shinhan7n2-spec/autonomous-car/README.md

# 자율주행 자동차 (몸체)

## 처음이면 여기부터

| 폴더 | 내용 |
|---|---|
| `1_출력파일_v6.3` | **지금 뽑을 STL 10개** |
| `2_출력가이드` | 출력 순서·시간·설정 (`index.html` 열기) |
| `3_조립설명서` | 그림으로 보는 조립 순서 (`index.html` 열기) |
| `4_학교제공자료` | 수업 자료 화면, 부품 목록·사진·스캔 STL |
| `5_과거기록` | 날짜별 이전 설계, 작업 기록 |
| `6_발표자료` | AI 활용 발표 (`index.html` 열기, 방향키로 넘김) |

- 최신 모델: `5_과거기록/2026-10-30/06_v6.3_최신모델/20261030_자율주행자동차_최종_v6.4.blend`
- 출력은 `1_출력파일_v6.3` 파일만 사용. 과거 기록의 STL과 섞지 않기
