shinhan7n2-spec/autonomous-car/5_과거기록/2026-10-29/00_부품조사/README.md

# 부품 원본 자료

2026-10-29, 기기 A. 사용자가 제공한 Downloads의 파일 3개를 원본 이름으로 복사했으며 각각 SHA-256 일치를 확인했다. 원본은 변경하지 않았다.

- 부품리스트_학생용.xlsx: Sheet3, 부품 항목 24개와 용도별 체결 부품 표를 읽음. 제품 링크의 실시간 내용은 아직 확인하지 않음.
- 부품스캔파일(stl).zip: 원본 ZIP 보존. 부품 STL 6개를 stl/에 풀었음. 몸체 완성 모델은 파일 목록에 없음.
- 자율주행_팀_물품사진_공지용.jpg: 팀 물품 안내 사진. 실제 수령 여부와 동일성은 미확인.
- stl_inventory.json: 바이너리 STL의 삼각형 수와 좌표축별 외곽 범위를 계산한 목록. STL에는 단위 정보가 없으므로 mm로 확정하지 않음. 회전된 부품의 축별 범위는 실제 길이·폭·높이와 다를 수 있음. 구멍 치수나 출력 적합성을 검증한 결과가 아님.

## 확인한 구성

- 라즈베리파이 4B 8GB 1개, IG-22GM 01TYPE 12V 1/104 모터 2개, 좌·우 96mm 메카넘휠 각 1개, 캐스터 1개.
- L298 드라이버, 2250mAh 11.1V 리포배터리, 보조배터리, APC850 카메라, 초음파 센서 등.
- STL: 라즈베리, 리포배터리, 메카넘휠, 모터, 보조배터리, 캐스터 휠. 카메라·센서·드라이버 이름의 STL은 없음.
- 체결 표: 캐스터 M5×10 4개와 M5 너트 4개, 바퀴 M4×12 2개와 M3×8 2개, 카메라 M6×20 1개, 지지대 볼트·너트 M4×30 각 4개, M4×20 볼트 8개.
- M4 3cm 지지대가 목록에 있어 다층 구성에 활용 가능성을 검토할 수 있으나 층 구성은 아직 결정하지 않음.

## 다음 확인

STL 형상과 방향·실물 크기 대조, 고정 구멍과 볼트 머리/너트 작업 공간, 카메라·센서·드라이버 크기, 프린터 조건, 사용자 외형 선택.
