shinhan7n2-spec/autonomous-car/5_과거기록/DESIGN_CHECKLIST.md

# 설계 고려사항과 확인 상태

2026-10-29 / 기기 A. 최신 사용자 결정 기준. 고려한 것과 실제 검증 완료를 구분한다.

| 항목 | 상태 | 근거 / 남은 일 |
|---|---|---|
| 제공 STL 원본 크기·형상 유지 | 반영·검사 | 배율 1. v3.1과 원본배율 복원본의 참고 객체 8개 전체 정점 해시 일치. 원본 파일 보존. |
| 기존 v2 보존 | 완료 | v3.0~v3.2를 별도 파일로 저장. |
| 메카넘휠 2개＋모터 2개＋캐스터 | 반영 | 수업 연결도 및 XLSX. 좌L·우R 각 1개 확인. STL은 한쪽 휠만 있어 복제된 반대편은 실제 롤러 방향을 재현하지 못함. |
| 전방 카메라·HY-SRF05 | 부분 반영 | 센서 기판과 받침 배치. 카메라 본체 및 커넥터 외곽 미반영. |
| 한 장 / 두 조각 비교 | 한 장 선택·치수 검사 | 바닥판 190×185mm. 접합부 제거를 우선. 분할판의 하중 시험이나 강도 해석을 비교한 것은 아님. |
| 3DWOX 1 | 사양 반영 | 출력 한계210×200×195mm. 바닥판 좌우10mm, 앞뒤7.5mm 여유. 실제 슬라이서에서 브림·서포트까지 포함한 검사 미완료. |
| 둥근 외형 | 부분 반영 | 모서리를 완화한 바닥판. 뚜껑 없음. |
| 차체·바퀴 공간 | 수치 검사 일부 | 전체 폭 약282.6mm, 후방 바닥판과 휠 외곽 사이 약2.7mm. 회전·축 체결·동적 변형은 미검증. |
| 높이·지면 접촉 | 형상 기준 반영 | 원본 휠/캐스터의 최저점을 지면에 맞춤. 모터 실제 축선은 스캔 중앙과 같다고 보장하지 않음. |
| 모터 고정 | 수정 중 | 기존 둥근 상하 받침의 29mm 구멍은 확정 끼움 아님. 사용자 승인: U자 홈 받침＋평평한 판＋제공 금속 볼트로 변경. 아직 새 고정대 생성 전. |
| 나사 구멍 | 부분 반영·추정 | M4용5mm, M3용4mm. 캐스터 슬롯38×28 중심 간격,14×6 슬롯은 추정. 나사 길이·머리·너트 및 공구 접근 최종 대조 미완료. |
| 배터리 고정 | 형상 반영·조립 미검증 | 벨크로는 지급품으로 확인되지 않아 제외. 출력 가로대＋볼트·너트, 옆/앞뒤 멈춤턱. 상부 여유1mm 제안. 리포 가로대 위 선반 여유1mm로 작음. |
| 배선·커넥터 | 부분 반영 | 선반 통로와 배선 경로 예시. 실제 USB/전원 커넥터 크기·굽힘 반경·착탈 공간 검증 미완료. |
| 부품 겹침 | 부분 검사 | 외곽 범위와 일부 접촉 높이 검사. 모든 실제 형상의 교차·공구 접근·캐스터 회전 간섭 검사를 완료한 것은 아님. |
| 무게·주행 안정성 | 미검증 | 실제 부품 질량·무게중심·가감속·횡미끄럼·캐스터 전환 시험 없음. 단순한 구조가 주행 성공을 보장하지 않음. |
| 출력 쉬운 단순 부품 | 수정 중 | 선반·가로대는 평판. 높은 일체 기둥·너트 포켓·모터 고정대 출력 방향/지지물 검토 필요. |
| 모델 표면 검사 | v3.1 검사 완료 | 새 구조물의 비다양체 모서리0. 출력·강도·조립 성공 검사와 다름. |
| 출력 파일 | 검토용만 생성 | v3.2에서 부품9개 STL 내보냄. REVIEW 표시. 사용자 요청은 확정본이므로 현재 파일을 최종 출력본으로 안내하지 않는다. |
| 조립설명서·치수도 | 미완료 | v2 README의 개념 순서와 v3 렌더는 있음. 최종 부품 번호·볼트 수량·순서 문서 및 치수도 미완료. |
| 예약 출력·재방문 최소화 | 설계 제약 유지 | 반복 시험 출력 가능하다고 가정하지 않음. 최종 슬라이싱 시간·필라멘트 확인 필요. |

## 추정값 적용 원칙
- 사용자는 검색 후 추정해 진행하되 값을 기록하도록 승인했다. 추정을 실측·제조사 확정치로 표시하지 않는다.
- 모터 제품명: IG-22GM 01TYPE 12V 1/104. 제조사 참고: https://www.shayangye.com/en/ig-22gm-01type
- 정확한 커플링: 지급 목록 96mm 휠용4mm 커플링. 다른6mm 커플링 치수를 확정값으로 쓰지 않는다.
- 3DWOX1 사양: https://sindoh.es/producto-sindoh/3dwox-1/
- 구조 치수·검사 상세: outputs/20261029_assembly_v3_A/v3_engineering_audit.json 및 mesh_validation.json.
- 제조사 수치와 스캔이 달라도 STL은 변경하지 않는다. 새 고정대 설계에 차이를 기록한다.

## 다음 완료 순서
1. 모터 U자 받침＋평판 방식으로 수정하고 출력 방향·체결 경로 검사.
2. 다른 고정대·커넥터·배터리 탈착·공구 접근 검사 및 수정.
3. 최종 STL과 부품 번호·볼트 목록·치수도·조립설명서 생성.
4. 실제 3DWOX1 프로필/재료로 슬라이싱 검증 후 출력 확정 여부 보고.

## 2026-10-29 v3.3 갱신
- 모터 U자 V홈 받침+평판 변경 완료. 단, 실제 고정·축 정렬 미검증.
- STL9개, 조립설명서HTML, 금속부품 예상표, ZIP 저장 완료. 제작확정본 아님.
- 9개 출력부품 연결체1개, 비다양체모서리0, 개별베드크기범위내. 원본STL참고객체 전체 정점해시 보존.
- PLA를 사용자 선택. 실제 장비재료/슬라이서검사/G-code 미완료. 보드·카메라·캐스터·모터 체결 검증은 여전히 남음.

## 2026-10-29 v3.4 덮개 프리뷰
- 덮개 외형 생성 및 4뷰 프리뷰 완료. 원본 STL 파일/형상 유지 해시 검증.
- 체결부와 카메라 실물여유, 전체간섭·슬라이싱은 미완료. 최신 덮개는 프리뷰이며 출력승인 아님.

## 2026-10-29 v4 통합 검토와 카메라 정정
- 랜카드 A1000mini 내장 안테나형 참고 형상. 치수24.6×16×8mm·USB 위치 추정, 연결 돌출30mm 가정 기록. 전파·열 시험 아님.
- 해치백 덮개와 보드 고정편 추가. 19개 새 출력 부품 메시 닫힘/연결성/크기 검사 통과. 실제 조립 및 출력 승인 아님.
- 카메라 뒤 접이식 받침이 프리뷰에 누락/과도 단순화됨. 테이프 없이 모니터처럼 걸칠 세로 받침과 뒤 클립 여유 설계 필요. M6 볼트 체결 위치·유효깊이는 미확정.
- 센서 뒤 고정띠 체결 상세, 보드 소자 간섭, 모터 축 정렬, 캐스터 회전 궤적, 실제 슬라이서 검사가 남음.

## 2026-10-29 v4.1 카메라 클립 받침
- 모니터형 세로 받침과 뒤 누름판, 지급 공용 M3×20 볼트/너트 각2개 기준 체결 형상 생성. 카메라 클립 뒤 작업 공간을 덮개에 반영.
- 원본 STL 파일/메시/배율 유지 확인. 변경부품3개 닫힘/연결체1, 카메라·받침 대 덮개/선반/Pi 표면교차0. 실물 힌지 동작과 고정력 검사는 아님.
- 테이프·접착제·추가 구매 부품을 쓰지 않는 규칙을 AGENTS.md에 기록. 카메라 외형/클립 치수는 추정, 실제 M3 수량과 끼움 확인 필요.

## 2026-10-29 v4.2 배터리 후방 탈착
- 위 가로대는 유지하고 뒤 잠금판2개를 제거해 배터리를 꺼내는 구조. 테이프/스트랩 추가 없음. 지급 M3×16 볼트/너트 총4세트 기준.
- 앞/뒤 왼쪽 지지대와 보조배터리 겹침 수정. 선반 보강대와 덮개 후방 개구 추가. 변경메시5개 닫힘/연결체1.
- 배터리 직선 이동 공간과 지정 구조물 부피 검사. 실제 배선/커넥터/충전기 호환성/실물 강도/열은 별도 미검증. 충전 중 차내 장착을 전제로 하지 않음.

## 2026-10-29 v4.3 센서 고정 (Claude)
- 센서가 덮개 앞벽과 겹치던 문제를 수정함. 기판은 바닥판 앞 기둥 홈에 밀어 넣고, 덮개에는 위가 트인 홈을 냄. 카메라 받침은 +6mm 올리고 선반에 M3×20 2개로 고정함. P12 고정띠는 삭제함.
- 조립 순서: 센서를 먼저 꽂고 배선한 뒤 카메라 받침을 얹는다(받침이 센서 빠짐을 막음).
- 미확인: 센서 핀 방향, 원통 간격·지름, 기판 두께 실측. 슬라이서 검사는 아직 하지 않음.
- 출력 1차 계산: 모든 부품이 3DWOX1 출력 범위 안에 들어감. 덮개 P10은 서포트 면적이 큼(눕혀서 출력해도 약 131cm²). 선반 P02는 약 35cm². 바닥판 P01은 판 크기가 출력 범위에 거의 꽉 차서 브림 여유가 작음.

## 2026-10-29 v5.0 들어 올리는 덮개 (Claude)
- P10을 v5 덮개로 교체함. 핀 4개로 끼우고 볼트 없이 수직으로 들어 올림. 0~130mm 들어 올림 간섭 0건. 지붕을 아래로 놓고 출력하며 서포트는 거의 없음.
- 핀 지름 3.6mm, 바닥판 구멍 4mm. 끼움이 헐겁거나 빡빡한지는 실물로 확인 필요.
- v4.3 덮개는 사용하지 않음(센서 홈 방향 오류).
