shinhan7n2-spec/autonomous-car/인수인계.md

# 인수인계 (2026-11-01, Claude → 다음 작업자)

## 1. 한 줄 요약
v6.4 출력 세트까지 완성. 사용자가 **출력물에 볼트를 직접 박는 방식(셀프태핑)을 쓰지 않기로** 해서, 키트 지지대를 쓰는 재설계를 검토 중. 아직 모델 수정 시작 전.

## 2. 폴더
| 폴더 | 내용 |
|---|---|
| `1_출력파일_v6.3/` | 출력1~4 STL (v6.4 반영). `개별부품_다시뽑을때/`에 부품 10개 |
| `2_출력가이드/` | 출력 가이드 HTML (수업 자료 「3D 프린터 모델링 및 제작」 순서 반영) |
| `3_조립설명서/` | 단계별 그림 조립설명서 HTML |
| `4_학교제공자료/` | 수업 자료 화면, 부품 목록·사진·스캔 STL |
| `5_과거기록/` | 날짜별 이전 설계, `AI_WORK_LOG.md`(LOG-001~035), `PROJECT_STATUS.md`, `DESIGN_CHECKLIST.md` |
| `5_과거기록/2026-10-30/06_v6.3_최신모델/` | **최신 모델 `20261030_자율주행자동차_최종_v6.4.blend`** + 생성 스크립트 |
| `6_발표자료/` | AI 활용 발표 HTML |

## 3. 사용자 조건 (확정)
- 잘 달리는 것 우선, 배터리 충전·교체 쉽게
- **키트 부품만** 사용 (테이프·접착제·추가 구매 없음)
- 가늘어서 부러지기 쉬운 구조 없음, 부품 수 적게, 조립 쉽게
- 의미 없는 구멍·흔적·떠 있는 덩어리 없음
- 설명은 짧은 문장, 그림 중심
- **출력물에 볼트 직접 박는 방식 사용 안 함** (2026-11-01 결정)
- GitHub 업로드는 사용자가 직접 함 (Claude는 하지 않음)

## 4. 장비·규격
- 프린터: **신도리코 3DWOX 1** (210×200×195mm), PLA, 프로그램 3DWOX Desktop (사용자 확인)
- 예약: 학교 예약 사이트 "3D 프린터 (3DWOX1)", 월~금. 수업 자료상 9시 이전·18시 이후·주말 출입 제한
- 도로 폭 30cm. 교수님 자동차 규격은 **예시**(몸체 폭 15cm, 길이 25cm, 층 높이 3 or 6cm)
- 현재 차: 바퀴 포함 폭 28.3cm, 몸체 19cm, 길이 20.7cm, 높이 22.3cm, 바닥판→선반 3cm (모델 측정)

## 5. 키트 볼트 (사용자 제공 목록)
| 부품 | 개수 | v6.4에서 |
|---|---|---|
| M5×10 + M5 너트 | 4+4 | 캐스터 |
| M4×12 / M3×8 | 2 / 2 | 바퀴↔커플링 / 커플링↔모터축 |
| M6×20 ("카메라" 지퍼팩) | 1 | 덮개+선반 고정 (직접 박음) |
| 지지대 볼트 M4×30 (한쪽 나사) | 4 | 안 씀 |
| 지지대 너트 M4×30 (양쪽 구멍) | 4 | 안 씀 |
| M4×20 | 8 | 모터 묶음 (직접 박음) |
- **일반 M4 너트는 키트에 없음.**

## 6. 진행 중: 재설계안 (사용자 승인 전, 치수 확인 필요)
- 아래 지지대(양쪽 구멍) 4개: 모터 하판 P07 ↔ 바닥판 사이 기둥. 모터를 위아래로 눌러 잡음
- 위 지지대(한쪽 나사) 4개: 나사가 바닥판을 뚫고 아래 지지대에 물림. 바닥판↔선반 3cm 기둥
- M4×20 8개: 아래 4개(P07→아래 지지대), 위 4개(선반→위 지지대)
- M6×20: 카메라용으로 돌려놓기 (카메라 구멍 규격 확인 필요)
- 영향: 위 기둥 위치(현재 모터 볼트 x±53, y-70/-26)가 배터리 칸과 겹침 → **배터리 배치 이동 필요**. 덮개는 볼트 없이 테두리 턱+핀. 선반 앞쪽은 출력 핀
- 다시 만들 부품: P01 바닥판, P02 선반, P06 모터 받침, P07 모터 하판, P10 덮개, (P04 가로대)
- **필요한 실측**: 지지대 볼트의 나사 길이, 지지대 육각 폭

## 7. 출력 시간 (슬라이서 실측, 사용자 제공, 층 0.2mm·외벽 0.8mm)
- 출력1 작은 부품 7개 한 판: **13시간 5분, 117.7g** (가이드 어림값 9시간보다 약 1.47배)
- P15 뒤 막대 단독 33분 5.5g / P14 리포 잠금판 단독 49분 7.4g
- 나머지는 미측정. 같은 비율이면 출력2 약 14h, 출력3 약 8h, 출력4 약 17~18h (추정)
- 줄이는 방법(**Claude 제안, 사용자 미적용·미측정**): 층 0.3mm, 채움 15%, 외벽 1.2mm(3줄)
- 출력 가이드의 시간·벽 두께(“4줄”) 표기는 아직 실측 반영 전 → 수정 필요

## 8. 남은 확인
- 웹캠 클립 실측(위판·뒤판 길이, 폭: 사진 추정 49/55/48mm)
- 초음파 센서 원통·핀 실측, 캐스터 구멍 실측
- 장시간 출력 가능 여부(담당 선생님)
- 핀 구멍 여유 0.5mm (수업 자료는 1mm 권장)

## 9. GitHub
- 원격: shinhan7n2-spec/autonomous-car (main)
- 로컬 커밋 c326cc7(폴더 정리·v6.4)까지 만들어 둠. 이후 출력 가이드 수정·이 문서는 사용자가 GitHub Desktop으로 커밋·푸시
- 큰 파일(.blend/.stl/.zip)은 Git LFS
