shinhan7n2-spec/autonomous-car/5_과거기록/PROJECT_STATUS.md

# 자율주행 자동차 프로젝트 상태

기록 기준일: 2026-10-29 (한국 표준시). 정확한 작업 시각은 소급 추정하지 않는다.

## 현재 단계

- 2026-10-30 최신: v6 (키트 볼트만, 출력 부품 10개). 출력 파일 outputs/20261030_출력세트_v6_A. 설명서 docs/제작설명서/index.html. 남은 일: 실측 확인(캐스터 구멍, 센서, 카메라 클립 뒤판), 슬라이서 검사, 작은 부품 시험 출력.

- 부품 자료를 확보하고 치수 확정 전 부품 배치·둥근 몸체 구조 초안을 검토하는 단계이다.
- 사용자는 Blender 사용을 결정했다.
- 설치·조립·부품 수령·기존 모델링의 실제 진행 여부는 아직 확인되지 않았다.
- 설치된 Blender 5.0.1로 부품 배치 v1과 둥근 몸체·선반·고정대 구조 검토 v2를 생성했다. v2 조립/분해·층별 프리뷰와 6면도를 저장하고 Blender 창에서 파일이 열린 것을 프로세스 제목으로 확인했다. 출력용 모델은 아직 미완성이다.

## 자료에서 확인한 수업 요구사항

- 각 조가 AI 에이전트를 활용해 자동차 몸체를 모델링한다.
- 모든 부품을 포함하고 단단히 고정할 수 있어야 하며 조별 미적 특징을 반영한다.
- 부품 리스트의 제품 링크, 제공 STL 및 실제 측정으로 규격을 확인한다. 실제 XLSX/STL 파일은 아직 이 작업에서 검토하지 않았다.
- 11월 10일 화요일 수업 전까지 3D 프린팅을 완료해야 한다. 날짜는 사용자 전달 내용이며, 연도는 현재 대화 맥락상 2026년으로 이해한 것이다.
- 실습 도로 폭은 자료상 30cm이다.
- 자동차 폭 15cm, 길이 25cm, 높이 3 또는 6cm 및 단층·다층 구성은 자료에 표시된 예시이며 확정 설계값이 아니다.
- 연결도에는 카메라·초음파 센서 전방 배치, 구동 바퀴 2개와 캐스터 구성이 제시되어 있다. 브레드보드는 생략 가능으로 표시되어 있다. 상세 배선·전기 규격은 검증하지 않았다.
- 주재료 표에는 라즈베리파이 4B 8GB, 전원용 배터리, 모터·드라이브, 바퀴·캐스터, USB 카메라, 초음파 센서, 브레드보드, App Inventor 앱이 제시되어 있다. 실제 지급품의 모델·수량·치수는 확인이 필요하다.

## 수업 흐름

1. 이론·라즈베리파이 소개, 모델링 과제, 카메라 실습
2. 자동차 모델링 발표와 조이스틱 앱 제작
3. 모터·조이스틱 제어와 데이터 수집
4. 모델 학습과 자율주행 테스트
5. 데이터 보완·재학습, 성능 개선과 최종 테스트

## 합의한 결정

- 기획 / 설치 및 연결 / 몸체 모델링 및 출력의 세 채팅 역할로 구성한다.
- 현재 채팅 이름은 `자율주행 자동차 · 기획`으로 변경 완료했다.
- 설치 및 연결 채팅과 몸체 모델링 및 출력 채팅을 같은 로컬 프로젝트로 생성하고 문서·이미지 경로와 인수인계 내용을 전달했다.
  - 설치 및 연결: 01a1831d-4ce7-73f2-8f7d-9bed6ac4f6e9
  - 몸체 모델링 및 출력: 01a1831d-5918-7430-a919-b8e8ce041e63
- 미확인 설계값은 임의로 정하지 않고 사용자에게 질문한다.
- 규칙은 임시 초안으로 운영하며 작업 중 수정한다.
- 채팅 인수인계에는 확정 사항, 미확인 사항, 다음 작업을 포함한다.
- 사용자가 AGENTS.md, PROJECT_STATUS.md, AI_WORK_LOG.md 생성과 지속적인 AI 활용 기록을 요청했다.
- 2026-10-29 사용자 명시 확인에 따라 현재 기기는 A이며 기존 미확인 기록도 A로 정정했다. 기기 확인은 설치·설정 변경 또는 동기화에 필요한 때만 한다.

## 제안·검토 대기

- AGENTS.md의 추가 제안 항목은 아직 일괄 합의되지 않았다.
- 기기 기록 방식은 사용자 요청으로 확정했다. 현재와 과거 미확인 기록은 A로 기록한다.
- 수업 첨부 이미지 9개는 references/class-slides에 원본 이름으로 복사하고 목록을 README.md에 기록했다. 원본과 복사본 SHA-256 일치를 확인했다. 설계 파일 구조와 버전 관리 방식은 아직 정하지 않았다.

## 기기별 상태

| 구분 | 확인된 내용 |
|---|---|
| A | 사용자 확인 완료. 현재 작업과 기존 미확인 기록은 A로 기록 |
| B | 실제 기기 대응과 작업 이력 미확인 |
| A의 연결 경로 | C:\Users\n2ria\Documents\Codex\autonomous-car |

기기와 무관한 공통 결정은 위 공통 항목에 기록하고, 실제 실행·설치·검증은 확인된 기기를 함께 기록한다. 이번 과거 기록의 A 정정은 사용자 명시 지시에 근거한다. 일반 작업에서는 기기를 반복 질문하지 않는다.

## 로컬 및 동기화 상태

- 문서 작성 전 폴더에는 README.md, .gitattributes, .git이 있었다. README에는 프로젝트 이름만 있었다.
- 프로젝트 및 확인한 상위 경로에 기존 AGENTS.md가 없었다.
- 작성 전 Git 브랜치는 main이며 작업 트리 변경은 없었다. 로컬 기록에는 초기 커밋이 있었다.
- 세 공통 문서와 references/class-slides의 이미지 9개·자료 목록을 로컬에 저장했다. commit·push는 수행하지 않았다.
- ⚠️ 미전달 변경 있음: 새 문서는 로컬 작업이며 다른 PC나 원격에 전달되지 않았다. 원격 저장소의 실시간 상태와 다른 PC 파일 상태는 확인하지 않았다.

## 모델링 채팅 추가 확인 — 2026-10-29

- 최신 구조 검토본: models/structure-preview-v2/20261029_자율주행자동차_몸체조립검토_v2.0_A.blend. 기존 v1을 보존하고 둥근 바닥판·상부 선반·모터/캐스터/배터리/보드 받침·전방 센서/카메라 받침을 추가했다. outputs/20261029_structure_v2_A에 실제 모델 렌더 11장과 조립/층별 4칸 프리뷰·6면도를 저장했다. Blender GUI 새 프로세스(PID 26832)를 실행했다.
- v2는 사용자 검토용 제안이다. 체결 구멍·나사산·정밀 끼움·배터리 스트랩·배선 경로는 미완성이고 카메라 본체는 없다. 은색 볼트는 관계 설명용. 제조 치수 확정·실물 조립·강도·주행·출력 검증은 미수행. 세부는 v2 출력 폴더 README.md 참조. 아래의 '모델 미생성' 문장은 당시의 과거 기록이다.

- 최신 산출물: models/layout-preview-v1/20261029_자율주행자동차_부품배치_v1.0_A.blend 및 outputs/20261029_layout_v1_A의 6면도·층별 PNG. 사용자 요청으로 같은 파일을 Blender GUI에 여는 프로세스를 실행했다. 결과/한계/실측 항목은 해당 출력 폴더 README.md 참조.
- 추가 수업 첨부 7장 보존·해시 확인. 카메라 M6×20, 지지대 M4×30·체결 M4×20, 캐스터 높이62mm, 휠지름96mm 등을 반영했다. 캐스터 스캔 외곽과 자료 높이 차이를 기록하고 프리뷰에 균일 배율 참고 보정. 실제 치수 검증 결과는 아님.

- 제품 규격 직접 조사: L298N SZH-EK001 외형 43×43×27mm, HY-SRF05 SZH-USBC-008 5핀 기판 45×21mm를 원래 제품 판매처 상세에서 확인. APC850 제조사 자료의 화각·회전 사양도 확인. 카메라 외형·하부 고정 치수와 센서/드라이버 장착 구멍 치수는 조사 자료에서 아직 확보하지 못했으며 구체적으로 사용자에게 질문한다. references/parts/product_dimensions.md 참조.

- 출력 이용 조건(사용자 보고): 프린터 대여를 위해 설계 후 별도 신청·방문이 필요. 프린터 정보는 추후 확인하고 현재 자료로 배치·몸체 구조부터 검토하도록 요청했다. 시험 출력을 반복할 수 있다고 가정하지 않는다.
- 배치 A안과 축척 없는 SVG 개념도를 프로젝트 루트의 20261029_자율주행자동차_배치구조초안_v1.0_A.md 및 20261029_자율주행자동차_배치개념도_v1.0_A.svg에 작성했다. 후방 구동륜·전방 캐스터·중앙 하부 배터리·작은 상부 보드 선반은 AI 제안이며 사용자 확정은 아니다. 실제 치수·간섭·출력·주행 미검증. Blender 모델은 아직 생성하지 않았다.

- 주행 구조 검토: 일반 고무 구동륜 2개+캐스터의 차동구동 원리를 현재 메카넘휠 2개 구성의 검증 결과로 취급하지 않는다. 제공 메카넘 좌·우 휠은 저속 직진·회전·후진 시 횡미끄럼과 캐스터 방향 전환 영향을 실물 시험해야 한다.
- 설계 제안(미확정): 낮은 둥근 바닥판, 무거운 배터리 하부 배치, 교체 가능한 모터/캐스터 거치대, 견고한 전방 카메라 고정. 1번 구조 참고+3번 둥근 외형 참고가 현재 제안이며 직접 호환은 미검증.
- Blender 설치는 사용자가 보고했다. 설치 상태·버전·실행은 이 채팅에서 도구로 확인하지 않았다. 향후 제공 부품 STL 배치와 맞춤 몸체 모델링에 활용할 예정.

- 사용자 선호: 디자인 미정. 3D 프린터 첫 사용이므로 출력·조립 안정성을 우선하며 너무 각진 외형은 원하지 않는다.
- 기존 모델 3종의 제작자 설명과 파일 제공 여부를 웹에서 조사했다. references/parts/model_candidates.md에 근거와 수정 필요 사항을 기록했다. 후보 선택·파일 호환·출력 검증은 아직 미완료.

- 추가 확보: 부품 XLSX, STL ZIP, 팀 물품 안내 JPG를 references/parts에 원본 이름으로 복사하고 SHA-256 일치를 확인했다. 기존의 '자료 미확보' 기록은 과거 상태이다.
- XLSX 부품 항목 24개와 체결 표를 읽고 STL 6개를 추출했다. 부품별 원시 좌표 범위를 계산했으며 단위·실물 일치·구멍 치수는 미검증이다. 상세는 references/parts/README.md 참조.
- ZIP에는 부품 모델 6개가 있으며 완성 몸체 파일은 목록에 없다. 카메라·센서·드라이버의 별도 STL도 목록에서 확인되지 않았다. Blender 모델 생성은 아직 수행하지 않았다.

- 사용자 첨부 자료에 접시머리 십자 볼트·너트·와셔 공용 세트가 표시되어 있다. 볼트 지름 M2/M2.5/M3/M4/M5/M6이며 길이는 규격별로 다르다. 실제 수령·수량과 부품별 사용 규격은 미확인이다.
- 사용자는 기존 3D 모델을 찾아 응용하는 방향을 제안했다. 구체적인 모델 선정·검색·치수 검증은 아직 수행하지 않았다.

## 다음 작업

1. 현재 기기 A를 유지한다. 설치·설정 변경 또는 동기화 시 기기 정보가 불명확하거나 전환된 경우에만 확인한다.
2. 생성한 모델링 채팅에서 자료·디자인 검토부터 시작한다. 설치 채팅에서는 사용자와 설치 현황 및 대상 기기를 확인한다.
3. 모델링을 시작하기 전 부품 자료·실측값, 설치 현황, 출력 환경을 확인한다.
4. 작업마다 AI_WORK_LOG.md와 현재 상태를 실제 수행 결과에 맞춰 갱신한다.

## 채팅·파일 공유 범위

- 세 채팅은 같은 로컬 프로젝트 폴더를 사용하도록 구성했다. 저장된 문서와 이미지를 읽어 이어가도록 전달했다.
- 다른 채팅의 대화 전체가 자동 전달되지는 않는다. 최신 결정은 문서로 기록하고 작업 재개 시 다시 읽는다.
- 같은 공통 문서를 동시에 수정하면 충돌할 수 있으므로 최신 내용을 확인하고 기존 기록을 보존한다.
- A/B PC 사이의 파일 복제, 설치 환경, 원격 저장소 동기화는 이번 작업에서 수행하거나 확인하지 않았다.

## 원본 STL 배율 유지 — 2026-10-29 / A
- 사용자 명시: 참고 배율 조절 금지. 제공 STL은 원래 크기/형상을 유지하고 위치·회전만 조정한다.
- 기존 v2 보존. models/assembly-v3/20261029_자율주행자동차_원본배율검토_v3.0_A.blend에 휠·캐스터 보정 제거 및 참고 STL 8개 객체 배율 (1,1,1) 검증 후 저장.
- 새 파일은 원본 크기 복원 체크포인트이며 조립 개선 완료본이 아니다. 기존 지지대·받침 높이와의 간섭은 재설계 대상. 원본 STL 파일 수정 없음.
- 진행 요청 유지: 겹침·바퀴구조 검토, 실제 체결/배선/배터리 고정 개선. 캐스터 높이와 모터·휠 축 위치·좌우 롤러 방향은 확인 필요.

## v3 설계·검증 상태 정리 — 2026-10-29 / A
- 최신 모델은 models/assembly-v3/20261029_자율주행자동차_한장차체조립_v3.2_A.blend. 아직 출력 확정본 아님.
- 고려사항 전체를 DESIGN_CHECKLIST.md에 반영/추정/미완료로 구분하여 정리했다. v3.1 검사 결과와 v3.2 검토용 STL 9개 존재를 기록.
- 사용자 승인: 모터 고정대를 홈 있는 U자 받침＋평판＋제공 볼트 방식으로 수정. 현재 수정 착수 단계. 생성 완료로 기록하지 않는다.
- 최근 결정이 모델 메모/JSON에 분산되고 공통 상태 갱신이 늦었던 것을 바로잡았다. 출력 최종 승인·슬라이서 검사·실물 주행 검증 미완료.

## v3.3 U자 받침 및 설명서 — 2026-10-29 / A
- 최신 모델: models/assembly-v3/20261029_자율주행자동차_U받침조립_v3.3_A.blend. U자 V홈 받침과 평판으로 교체. 기존 버전 보존. 모터 고정대 형상 변경 완료, 실물 끼움 미검증.
- outputs/20261029_assembly_v3_3_A에 STL9개, 조립 HTML, ZIP, 렌더3개, manufacturing_checks.json 저장. 새 구조9개 연결체1/비다양체모서리0/베드 크기범위내, 참고STL8개 전체정점해시 일치. 바이너리STL 구조와ZIP 무결성 확인.
- 사용자 선택 PLA. 실제 장비 재료는 담당자 확인 예정. 슬라이서 설치/실행 및 G-code 생성 미완료. 3DWOX1 사용. 출력 확정본 아님: 모터 축·끼움, 캐스터패턴, 보드/카메라 고정 상세 등이 남아 있음.
- 이전 사용량으로 인한 자동 승인 검토 실패 뒤 재시도 성공. 조립설명서 저장 및 Blender GUI PID33360 실행, 창 제목 확인.

## v3.4 덮개 프리뷰 — 2026-10-29 / A
- 사용자 요청은 덮개 모델링 프리뷰. models/assembly-v3/20261029_자율주행자동차_덮개프리뷰_v3.4_A.blend에 별도 저장, 기존v3.3 보존.
- 둥근 모서리 쉘168×156×82mm, 명목벽3mm, 전방 개구·선반여유·측면통풍·배선개구·후방휠여유 추가. 체결부 미설계, 실제 카메라 본체 미포함, 전체간섭/출력 검증 미완료. 외형프리뷰이며 출력용STL 미발행.
- 원본STL6개 파일 SHA256 전후 일치, 참고객체8개 전체정점해시 유지/배율1 검사. 덮개비다양체모서리0. 4뷰와합성프리뷰 확인, BlenderGUI 실행PID31244 및창제목 확인.
- 결과: outputs/20261029_cover_preview_v3_4_A. 파일·메시검사 근거 preview_checks.json.

## v4 통합 검토 중 — 2026-10-29 / A
- models/assembly-v3/20261029_자율주행자동차_통합설계_v4.0_A.blend 및 outputs/20261029_integrated_v4_A 생성. 해치백 덮개, 통풍구, 랜카드 추정 형상, 보드 고정편 추가. 수업 STL6개와 참고객체8개 해시/배율 유지 검사.
- 랜카드 부품표 모델은 ipTIME A1000mini. 내장 안테나형 기준이며 24.6×16×8mm와 포트 위치는 미검증 추정값. 연결 후 돌출30mm 공간 가정. 통신·온도 시험 미수행.
- 덮개 내부 면 방향/삼각화 오류와 고정편 간섭을 수정. 최신 engineering_report.json상 출력부품19개 연결체1/비다양체모서리0/개별출력범위내. 회전궤적·실물조립·슬라이싱 검사와 동일하지 않음.
- 사용자 카메라 사진 재확인: 모니터 걸침형 접이식 뒤 받침이 현재 카메라 단순 프리뷰에 충분히 반영되지 않음. 테이프 고정 아님. 카메라 받침과 뒤 클립 공간 재설계 필요. M6 체결 위치/깊이 미확정. 센서 뒤 고정띠 체결도 미완료. 최종 출력본으로 취급하지 말 것.

## 카메라 클립 받침 v4.1 — 2026-10-29 / A
- models/assembly-v3/20261029_자율주행자동차_카메라클립_v4.1_A.blend에 별도 저장. 세로 받침8mm, 뒤 누름판, M3×20 볼트/너트 각2개 기준 체결, 덮개 클립 작업 공간 수정. 기존 버전과 원본 STL 보존.
- outputs/20261029_camera_clip_v4_1_A에 변경 STL3개·조립안내HTML·검사JSON·렌더3개. 원본파일/참고메시 해시와 배율 유지, 변경부품 닫힘/연결체1, 카메라/받침 대 덮개/선반/Pi 표면교차0 확인.
- 사용자 요청에 따라 AGENTS.md 합의 규칙에 테이프·접착제·추가 구매 부품 없이 출력 구조물과 지급 부품으로 고정한다는 조건 기록.
- 카메라 클립 치수/힌지는 추정. 실제 고정력·접이동작·볼트 수량·슬라이싱 미확인. 카메라 높이가 높아진 구조이며 실물에 따라 재조정 가능. 전체 출력 확정본이 아님.

## 배터리 탈착 v4.2 — 2026-10-29 / A
- 선반/덮개를 남긴 채 뒤 잠금판을 풀고 배터리를 뒤로 빼는 구조로 수정. 기존 위 가로대 유지, 뒤 턱 제거, 잠금판2개와 M3×16 볼트/너트 총4세트 기준 받침 추가. 지급 수량 미확인.
- 실제 형상검사에서 왼쪽 앞/뒤 지지대가 보조배터리와 겹침을 발견. 뒤(-69,-59)→(8,-59), 앞(-69,64)→(-76,64) 이동. 선반 체결 귀/하부 보강대와 덮개 여유 추가.
- models/assembly-v3/20261029_자율주행자동차_배터리탈착_v4.2_A.blend, outputs/20261029_battery_service_v4_2_A에 변경STL5개·렌더·HTML안내·검사JSON. 기존버전 및 수업 STL 보존.
- 원본파일/참고메시/배율 유지 검사, 변경메시 닫힘/연결체1, 배터리 직선 탈착 공간과 지정 구조물 부피 겹침 검사. 케이블/커넥터 치수와 배치, 실제 휨/고정력/충전기 호환성/슬라이싱 미검증. 충전 가능 또는 안전성 확정으로 해석하지 말 것.

## GitHub 전달 준비 — 2026-10-29 / A
- 사용자 커밋·업로드 승인. origin은 shinhan7n2-spec/autonomous-car, 기존 main의 Initial commit 기준으로 작업 파일 등록.
- 제작파일·수업 참고자료·설명서·작업기록 포함. tmp, .blend1 등 자동 백업, 실행 로그 제외. .blend/.stl/.zip은 Git LFS 관리. 원본 파일 내용 변경 없음.
- 텍스트 내 대표 토큰/개인키 패턴 검색에서 일치 없음. 대용량 파일은 LFS 포인터로 등록됨.
- 현재 원격 확인은 사용자 GitHub 로그인 대기 중. 이 기록 시점에는 푸시 완료 아님. ⚠️ 미전달 변경 있음.

## GitHub 전달 확인 — 2026-10-29 / A
- 제작 파일 커밋 86c6d6205c2ab4db88e41fbc8cf6ac5fa047f527 업로드 성공. git ls-remote로 origin/main과 로컬 HEAD 일치 확인, 작업트리 깨끗함 확인.
- LFS 45개 고유 객체 약2.0GB 전송 완료. 서버 index-pack 오류 후 동일 커밋 재시도 성공. 기존 이력 강제 변경 없음.
- 앞선 로그인 대기/미전달 기록은 당시 상태이며, 위 제작 커밋은 전달 완료. 이 확인 기록은 후속 문서 커밋으로 전달한다.
