shinhan7n2-spec/autonomous-car/5_과거기록/2026-10-29/00_부품조사/model_candidates.md

# 기존 모델 후보 검토

2026-10-29, 기기 A. 사용자는 첫 3D 출력·조립의 안정성을 우선하며 너무 각진 외형은 원하지 않는다. 특정 디자인은 아직 선택하지 않았다.

## 1. Flexible chassis 2WD & 4WD robot — Geoff_B_UK

- 제작자 설명: https://onlinedevices.org.uk/Flexible_Chassis_Design?page_ref_id=225
- 배포 페이지: https://www.printables.com/model/75941-flexible-chassis-2wd-4wd-robot
- 제작자 설명에서 2WD/4WD 공용 단일 바닥판, 분리형 부품 고정대, 배치 변경 구조를 확인했다. Printables 본문은 도구에서 열리지 않았다.
- 활용 판단: 2WD 바닥판과 고정대 분리 구성을 참고하기 좋은 후보. 사용자 모터·캐스터·배터리·카메라에 맞춘 변경이 필요하며 직접 호환은 미검증. 둥근 모서리와 낮은 외장을 추가하는 것은 AI 제안이다.
- 재배포 사이트는 CC BY-NC로 표시하지만 실제 파일 채택 전 원본 라이선스를 확인해야 한다.

## 2. PenguinTutor Mecanum Robot Chassis V2 — Stewart Watkiss

- 제작자: https://www.penguintutor.com/projects/robot-mecanum
- 배포: https://www.thingiverse.com/thing:6126877
- 제작자 설명에서 선택형 2층, 초음파 센서 거치대, 개선 모터 고정대를 확인했다. V1 FreeCAD/STL 링크와 V2 배포 링크가 있다.
- 활용 판단: 바닥판·상판·별도 거치대 구조를 참고. 원본 4륜 구동을 사용자 2륜+캐스터 구성으로 그대로 쓰지 않는다. 모터 고정과 구멍 위치 재설계 필요. 라이선스는 미확인.

## 3. PROBE LX-3 — Lumalien

- 제작자: https://www.lumalien.com/probe-lx-3
- 원본: https://github.com/patmakesapps/PROBE-LX-3
- 제작자 설명상 둥근 돔, 2 N20 모터+볼 캐스터, Pi 5용. Blender 원본·STL·조립 안내 제공. CC BY-SA 4.0.
- 제작자 표기 폭 약 245mm, 돔 출력에 최소 256×256mm 베드. 원본 지지물 없이 출력 가능하다는 제작자 설명이며 독립 검증하지 않았다.
- 활용 판단: 둥근 외장과 분리형 내부판 참고용. 사용자 부품과 차이가 커 구조 변경량이 많으며 첫 출력용 직접 채택 우선순위는 낮다.

## 현재 결론과 한계

- AI 제안: 1번의 단순 분리 구조를 바탕으로 모서리가 둥근 낮은 차체를 검토. 사용자 선택이나 확정 설계가 아니다.
- 외부 파일 다운로드·Blender 로드·부품 간섭·조립·강도·출력 검증은 수행하지 않았다. 웹 설명 기반 후보 비교이다.
- 일부 원본 이미지 URL은 웹 도구에서 불러오지 못했다. 원본 페이지의 사진/렌더 링크를 제공한다.
