shinhan7n2-spec/autonomous-car/5_과거기록/2026-10-29/00_부품조사/product_dimensions.md

# 제품 자료 규격 확인

2026-10-29 / A. XLSX 제품명·링크를 기준으로 웹 자료를 조사했다. 외형 치수와 장착 구멍 치수는 구분한다.

| 부품 | 직접 확인한 자료 | 설계에 남은 정보 |
|---|---|---|
| L298N SZH-EK001 | 원래 제품 판매처 상세설명에 Size 43×43×27mm | 구멍 지름·중심 간격, 단자/케이블 작업 여유 |
| HY-SRF05 SZH-USBC-008, 5핀 | XLSX 링크의 정확한 제품 식별. 판매처 상세에 L×W 45×21mm | 센서 돌출 깊이, 구멍 지름·간격, 커넥터 돌출 |
| ABKO APC850 | 제조사 보도자료에서 제품 식별, FHD 30fps, 화각 110°, 수평 360°·수직 90° 회전 표기 확인 | 본체·받침 외곽 치수와 하부 고정 방식. 조사한 공식 본문에서 해당 수치 찾지 못함 |

출처:
- https://www.devicemart.co.kr/goods/view_contents?no=1278835&setMode=pc&zoom=1
- https://www.devicemart.co.kr/goods/view_contents?no=1324055&setMode=pc&zoom=1
- https://www.abko.co.kr/bbs/board.php?bo_table=news&wr_id=181

HY-SRF05를 HC-SR04 모델로 대체하지 않는다. 동일 제품군도 판본 차이가 있을 수 있으므로 장착 치수는 제공품과 대조한다. APC850의 화각 110°는 제조사 표기이며 수평/수직 구분이 없어 수평 화각으로 단정하지 않는다. 물품 사진의 카메라용 M6×20 볼트 목록만으로 카메라 하부 나사산이 M6라고 확정하지 않는다.

사용자 요청: 이미 자료에 있는 내용은 먼저 직접 조회하고, 찾지 못한 필요한 항목을 구체적으로 질문한다. 사진·치수가 확보되면 이 문서에 출처와 함께 추가한다.

## 사용자 추가 수업 이미지

references/parts에 첨부 원본 7장을 파일명 그대로 보존하고 임시 원본과 SHA-256 일치를 확인했다.

- 카메라 사양: 고정 볼트 M6, 20mm. 모니터 걸이형 받침 사진 제공. 카메라 하부 나사산 자체·체결 깊이는 별도 확인.
- 지지대: 볼트형·너트형 M4, 30mm. 지지대용 볼트 M4, 20mm.
- 센서 모델: HY-SRF05.
- 모터: 2개, 12V, 1/104. 드라이버 5~35V, 2채널.
- 캐스터 높이: 62mm. 고정 볼트 M5, 10mm 및 M5 너트.
- 메카넘휠 지름: 96mm. 휠 고정 볼트 M4, 12mm 및 모터 고정 볼트 표기 M3, 8mm.
- 라즈베리 전원 5V, 모터 드라이버 전원 12V로 슬라이드에 표시. 리포 실제 전압 표기는 XLSX의 11.1V와 구분하며 전기 연결 검증은 수행하지 않았다.
