shinhan7n2-spec/autonomous-car/5_과거기록/README.md

# 과거 기록 (날짜별)

## 작업 기록 문서
- `AI_WORK_LOG.md` 작업 기록 (발견 → 조치 → 결과)
- `PROJECT_STATUS.md` 진행 상태
- `DESIGN_CHECKLIST.md` 설계 점검표

## 2026-10-29
| 폴더 | 내용 |
|---|---|
| `00_부품조사` | 키트 부품 치수·모델 조사 메모 |
| `01_배치_v1` | 부품 배치 개념도 |
| `02_구조_v2` | 몸체 구조 첫 검토 |
| `03_조립_v3` | 원본 배율 확인, 한 장 차체, U받침, 덮개 미리보기 (v3.0~3.4) |
| `04_통합_v4` | 통합 설계, 카메라 클립, 배터리 탈착, 센서 자리 (v4.0~4.3) |
| `05_덮개_출력세트_v5` | 들어 올림 덮개, 캐스터 수정, 첫 출력 세트 v5.2 |

## 2026-10-30
| 폴더 | 내용 |
|---|---|
| `06_v6.3_최신모델` | 부품 20개 → 10개, 키트 볼트만 사용, 덮개 볼트 1개, 웹캠 클립 받침. **최신 .blend** (v6.4: 모터 하판 눕혀서 출력) |
