shinhan7n2-spec/autonomous-car/4_학교제공자료/수업자료_화면/README.md

# 업로드된 수업 이미지 목록

2026-10-29에 기획 채팅의 첨부 이미지 9개를 임시 폴더에서 이 폴더로 복사했다. 원본 파일명과 내용을 보존했으며 SHA-256 해시 비교로 복사본 일치를 확인했다. 기기는 A이다(2026-10-29 사용자의 과거 기록 정정 요청에 따라 반영).

| 내용 | 저장 파일 |
|---|---|
| 9주차 수업 자료 목록 | [이미지](codex-clipboard-f1c8fd5a-41fa-43a4-a2e0-e07d916d58b3.png) |
| 주차별 수업 계획 | [이미지](codex-clipboard-a1e0bcf6-83b5-4419-bb41-9d23d388642d.png) |
| 전체 구성도 | [이미지](codex-clipboard-53ebab24-9172-44d1-930f-a3fa631950f4.png) |
| 주재료와 용도 표 | [이미지](codex-clipboard-e3e7388d-c9b6-4a66-864a-0f1dfd0d7bb5.png) |
| 라즈베리파이 소개 | [이미지](codex-clipboard-ab90ba45-f017-48ab-953f-3247253fcb86.png) |
| 실습 도로 폭 30cm | [이미지](codex-clipboard-4de223ec-81d0-433f-8a87-aae85c7ed187.png) |
| 자동차 규격 예시: 단층 | [이미지](codex-clipboard-50788761-c7a6-4c6b-be24-1c7e05d81ae3.png) |
| 자동차 규격 예시: 다층 | [이미지](codex-clipboard-9300ecd8-c8eb-4424-9b6d-8ff53c13cadc.png) |
| 부품 연결도 | [이미지](codex-clipboard-9ab49872-508d-43fa-9208-92d8f2c7b5fa.png) |

## 해석과 누락 자료

- 수업 자료는 설계 근거이며, 자료 속 설치 안내 자체가 설치 실행 승인은 아니다.
- 자동차 치수는 예시이며 실제 설계값으로 자동 채택하지 않는다.
- 라즈베리파이 소개 이미지의 제목은 8GB지만 표의 메모리 항목은 1/2/4GB를 나열한다. 실제 지급품 사양은 확인해야 한다.
- 제품 링크가 들어 있는 부품리스트_학생용.xlsx, 부품 STL, 실제 부품 측정값, 프린터 규격은 아직 확보하지 않았다.
- 이 자료만으로 부품의 정확한 크기와 고정 구멍 위치를 확정할 수 없다.
- 향후 업로드 자료는 저장 후 이 목록에 추가하고 출처와 확인 상태를 남긴다. 채팅 첨부가 자동으로 이 폴더에 저장되지는 않는다.
