shinhan7n2-spec/autonomous-car/5_과거기록/2026-10-29/01_배치_v1/20261029_자율주행자동차_배치구조초안_v1.0_A.md

# 부품 배치·둥근 몸체 구조 초안 v1.0

2026-10-29 / 기기 A / 사용자 검토용 제안. 실제 치수·강도·주행·출력 적합성을 확정한 도면이 아니다.

## 사용자 조건

- 첫 3D 출력이므로 조립과 출력 안정성을 우선하며 너무 각진 외형은 원하지 않음.
- 프린터는 대여하며 설계를 정리한 뒤 별도 신청·방문 필요. 프린터 정보는 나중에 확인하고 지금은 배치·구조 검토를 진행하도록 요청.
- Blender 사용. 제공 STL 6개는 부품 참고 모델이다. STL 단위와 실물 일치는 아직 검증하지 않았다.

## A안: 뒤쪽 구동륜 + 앞쪽 캐스터 + 낮은 둥근 바닥판

- 전방 상부: USB 카메라. 낮고 짧은 전용 받침에 고정하며 필요한 도로 시야를 확보하는 각도·높이는 이후 확인한다. 고정 후 흔들리지 않아야 한다.
- 전방 정면: 초음파 센서. 카메라 아래쪽 후보이며 센서 송수신부 앞을 외장이 가리지 않게 한다. 두 센서의 최종 높이와 간격은 미정.
- 전방 하부: 캐스터 1개. 회전축을 중심으로 바퀴·포크가 전체 회전하는 공간을 예약한다. 앞쪽 배터리·볼트와 간섭하지 않게 한다. 사진/외곽 STL만으로 회전 공간과 장착 높이를 확정하지 않는다.
- 후방 좌우: 모터 2개와 구동륜. 두 축을 같은 직선상에 두는 배치 후보. 휠은 차체 밖으로 노출하며 롤러·허브·체결부 여유를 확보한다. L/R 장착 방향은 실물과 수업 자료로 확인한다.
- 하부 중앙: 리포배터리와 보조배터리를 나란히 세로 방향으로 놓는 후보. 사진과 STL 범위를 바탕으로 한 개념이며 두 부품과 모터가 실제로 들어가는지는 미검증. 무게중심을 구동륜 접지선보다 캐스터 쪽 안쪽에 두면서 캐스터에 하중이 몰리지 않게 조정한다. 실제 질량 정보 필요.
- 중앙~후방 상부: 라즈베리파이용 작은 분리형 선반. 기판·금속 지지대가 배터리 표면에 닿지 않게 구성하고 팬 흡배기, USB/전원 포트, 케이블 굽힘과 분리 공간을 확보한다. 사용 가능한 M4 지지대가 보드 장착 구멍에 맞는다고 가정하지 않는다. 선반 체결과 보드 체결을 구분한다.
- 후방 하부 또는 옆면: 드라이버를 독립 고정. 모터 선이 짧게 이어지도록 하되 발열부를 배터리와 떨어뜨리고 단자 나사에 공구가 접근하게 한다. 모터와의 간섭에 따라 위치 변경 가능.
- 배선·선택 부품: 중앙 옆쪽 통로를 확보. 브레드보드는 최종 연결 방식에 따라 예약 공간만 두고, 무선랜카드가 필요하면 USB 돌출 공간 확보. 충전기·모니터용 케이블·보관백 등 외부 작업용 물품과 실제 탑재 부품은 최종 수업 요구로 구분한다. 브레드보드 생략을 이번 배치 결정으로 확정하지 않는다.

## 몸체 구조

- 위에서 보면 앞뒤가 둥근 긴 사각형. 앞코는 부드러운 곡선, 옆면은 짧고 곧게 이어 앞뒤가 분명한 자동차 형태를 만든다.
- 바닥은 출력판에 놓을 수 있도록 평평한 방향으로 계획. 윗면 테두리와 앞뒤 모서리를 둥글게 하는 방식으로 시작하며 바닥 전체를 구면으로 만들지 않는다.
- 바닥판 1개 + 작은 전자부품 선반 + 좌우 모터 고정대 + 캐스터 고정대 + 전방 센서 고정대가 기능 단위 후보. 일체화/분리 개수는 프린터와 조립 경로 확인 후 결정.
- 큰 돔 대신 낮은 옆 테두리와 둥근 앞코로 외형을 표현하고 상부는 열어 둔다. 배터리 교체와 배선 점검을 위한 접근 공간 확보.
- 모터/캐스터 결합은 볼트로 확실히 고정하는 구조를 검토. 위치 조정용 긴 구멍은 필요한 축에만 제한하고 모터가 회전하거나 미끄러지지 않도록 받침 면을 함께 설계한다.
- 배터리는 탈착 가능한 받침과 고정 밴드 방식 후보. 나사 끝이나 너트가 배터리에 닿지 않도록 한다. 실제 밴드 보유·치수·재료는 미정이며 새 부품 확보를 확정하지 않는다.
- 캐스터 앞/뒤가 본질적으로 항상 우수하다고 단정하지 않는다. A안의 전방 캐스터가 센서·배터리와 충돌하거나 하중 조건이 나쁘면 앞 구동륜+후방 캐스터 B안으로 바꿔 비교한다.

## 확정하지 않은 항목

차체 폭·길이·판 두께·바퀴 간격·지상고·구멍 지름/간격·카메라 각도·선반 높이·볼트 길이·재료·출력 분할. 15×25cm와 높이 3/6cm는 계속 수업 예시로 취급한다. M4 30mm 지지대 보유 목록만으로 층간 유효 공간이 충분하다고 판단하지 않는다.

## 다음 작업

Blender에서 먼저 부품 참고 모델만 원본 보존 상태로 배치해 단위와 간섭을 확인한다. 단위 대조에 필요한 대표 실물 치수 한 가지를 확보하고 실제 구멍/체결부를 확인한 뒤 몸체의 치수를 정한다. 카메라·센서·드라이버는 STL이 없으므로 제품 자료나 실측 전 임의 치수의 실제 부품 모델을 만들지 않는다. 프린터 정보는 출력용 구조·파일 확정 전에 반영한다.

동봉 SVG는 배치 관계를 설명하는 개념도이며 축척·실물 크기·실제 부품 외형을 나타내지 않는다. Blender 모델/STL은 이번 단계에서 만들지 않았다.
