shinhan7n2-spec/autonomous-car/2_출력가이드/img/pr_plate.jpg

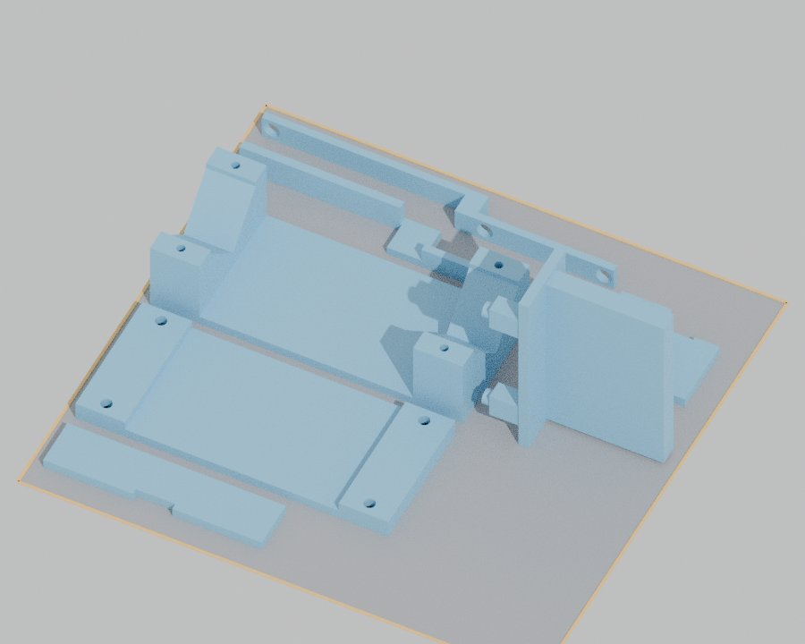
2_출력가이드/img/pr_plate.jpg
