shinhan7n2-spec/autonomous-car/4_학교제공자료/부품/codex-clipboard-4c7e1d8b-b363-4929-ad33-3c70bf41ea95.png

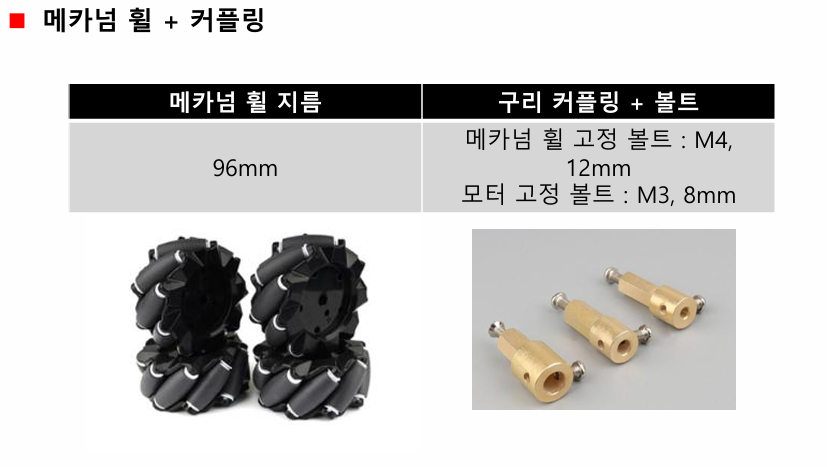
4_학교제공자료/부품/codex-clipboard-4c7e1d8b-b363-4929-ad33-3c70bf41ea95.png
