shinhan7n2-spec/autonomous-car/4_학교제공자료/부품/codex-clipboard-109dc1af-4932-47ae-b3d5-a2442e641044.png

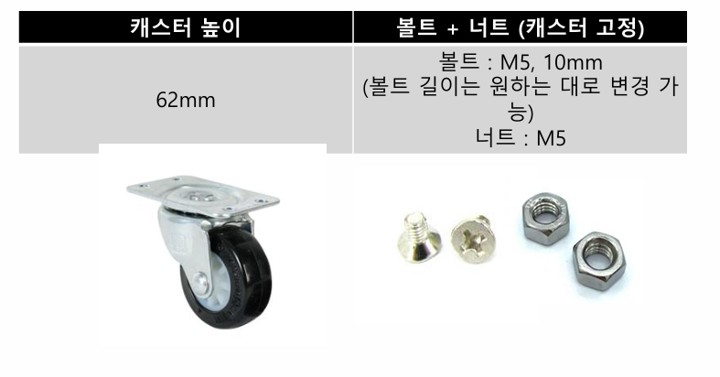
4_학교제공자료/부품/codex-clipboard-109dc1af-4932-47ae-b3d5-a2442e641044.png
