shinhan7n2-spec/autonomous-car/4_학교제공자료/부품/codex-clipboard-4463d129-2521-4563-b00f-e695de466e16.png

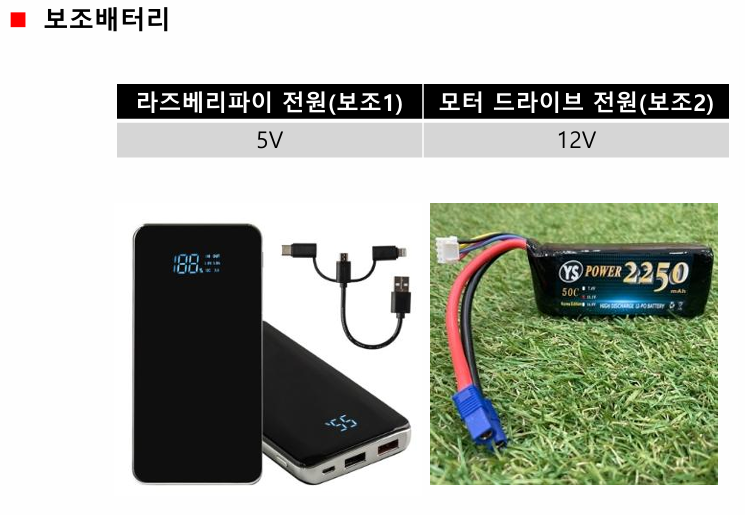
4_학교제공자료/부품/codex-clipboard-4463d129-2521-4563-b00f-e695de466e16.png
