shinhan7n2-spec/autonomous-car/4_학교제공자료/부품/codex-clipboard-06438be9-f692-4079-ad38-5f4aebd96200.png

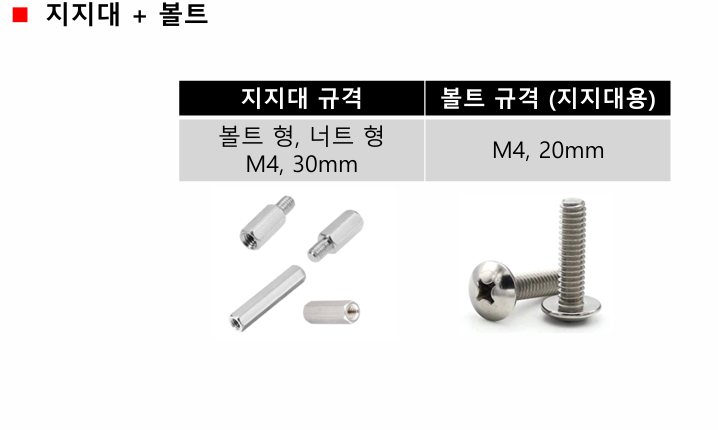
4_학교제공자료/부품/codex-clipboard-06438be9-f692-4079-ad38-5f4aebd96200.png
