shinhan7n2-spec/autonomous-car/4_학교제공자료/부품/codex-clipboard-16206f9e-b647-4b4c-82dd-df07e386d69a.png

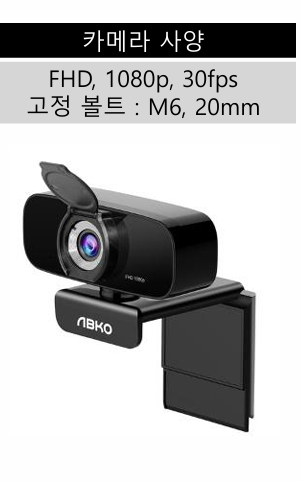
4_학교제공자료/부품/codex-clipboard-16206f9e-b647-4b4c-82dd-df07e386d69a.png
