shinhan7n2-spec/autonomous-car/4_학교제공자료/부품/codex-clipboard-b5cda85c-d5c8-43b8-b700-ac711ba945a7.png

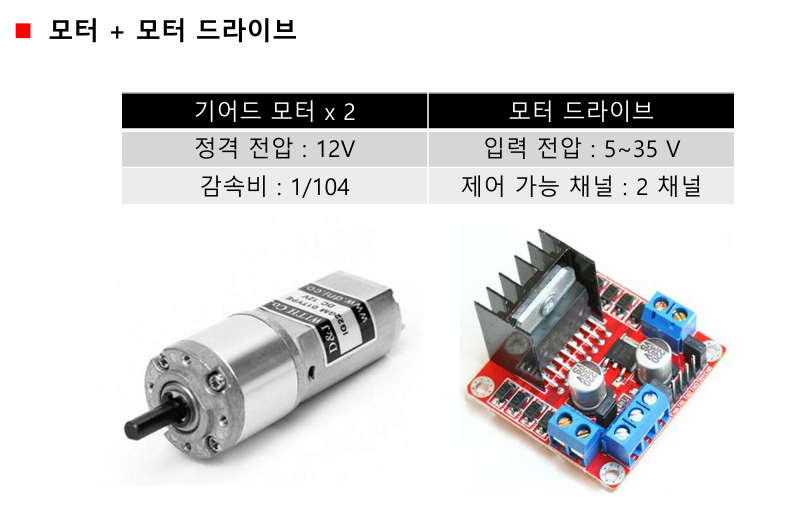
4_학교제공자료/부품/codex-clipboard-b5cda85c-d5c8-43b8-b700-ac711ba945a7.png
