shinhan7n2-spec/autonomous-car/4_학교제공자료/부품/codex-clipboard-f0626517-a061-4748-88e9-d76361669555.png

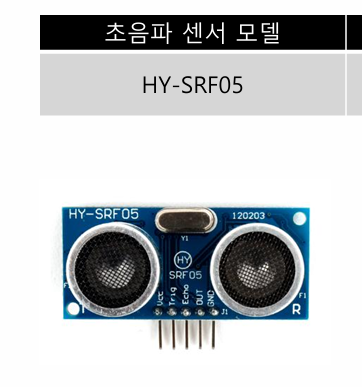
4_학교제공자료/부품/codex-clipboard-f0626517-a061-4748-88e9-d76361669555.png
