shinhan7n2-spec/autonomous-car/4_학교제공자료/부품/자율주행_팀_물품사진_공지용.jpg

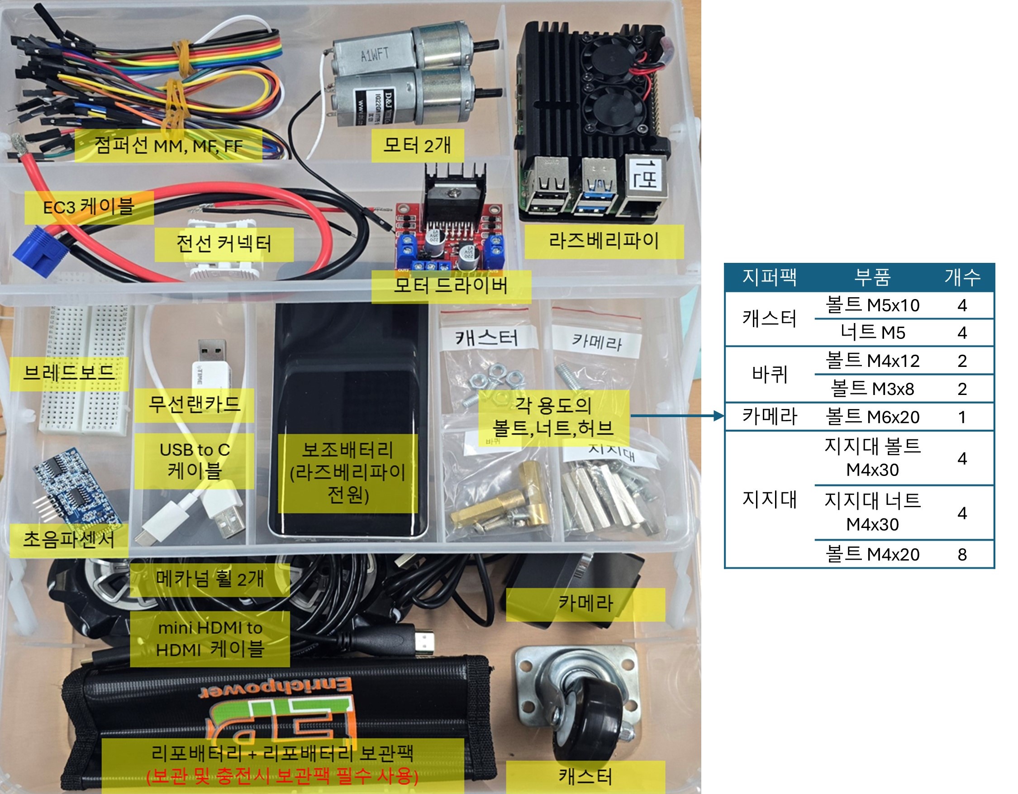
4_학교제공자료/부품/자율주행_팀_물품사진_공지용.jpg
