shinhan7n2-spec/autonomous-car/4_학교제공자료/수업자료_화면/codex-clipboard-4de223ec-81d0-433f-8a87-aae85c7ed187.png

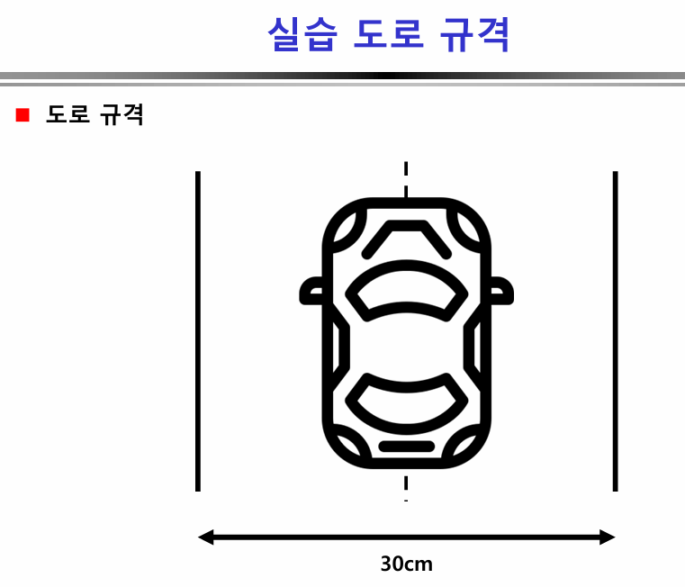
4_학교제공자료/수업자료_화면/codex-clipboard-4de223ec-81d0-433f-8a87-aae85c7ed187.png
