shinhan7n2-spec/autonomous-car/4_학교제공자료/수업자료_화면/codex-clipboard-9ab49872-508d-43fa-9208-92d8f2c7b5fa.png

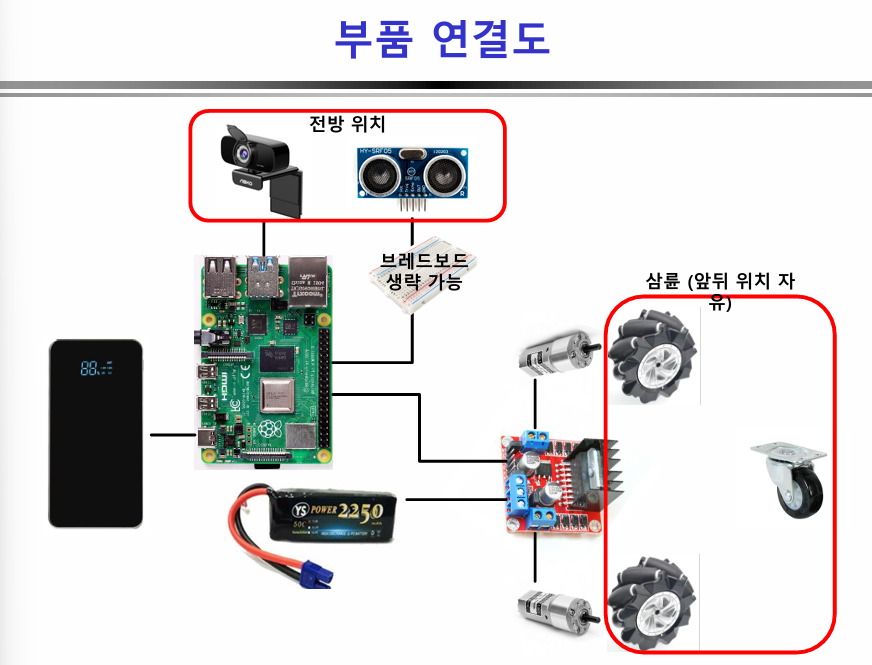
4_학교제공자료/수업자료_화면/codex-clipboard-9ab49872-508d-43fa-9208-92d8f2c7b5fa.png
