shinhan7n2-spec/autonomous-car/4_학교제공자료/수업자료_화면/codex-clipboard-53ebab24-9172-44d1-930f-a3fa631950f4.png

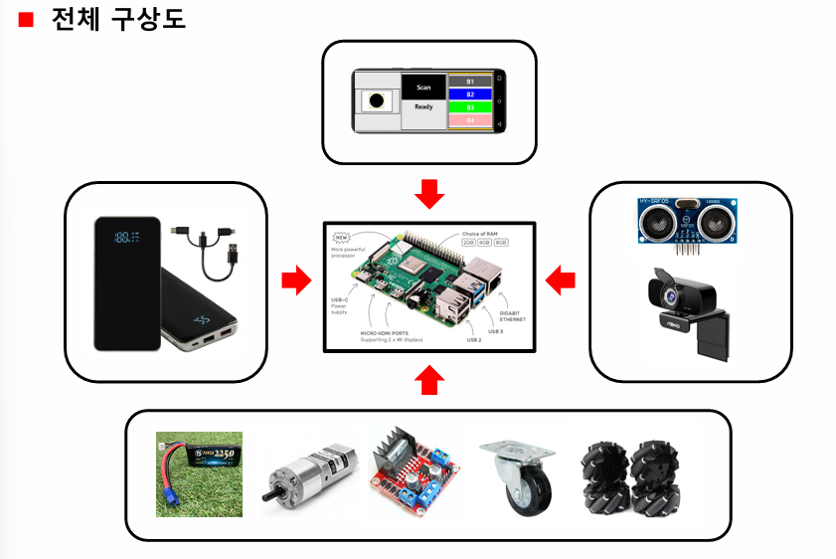
4_학교제공자료/수업자료_화면/codex-clipboard-53ebab24-9172-44d1-930f-a3fa631950f4.png
