shinhan7n2-spec/autonomous-car/4_학교제공자료/수업자료_화면/codex-clipboard-9300ecd8-c8eb-4424-9b6d-8ff53c13cadc.png

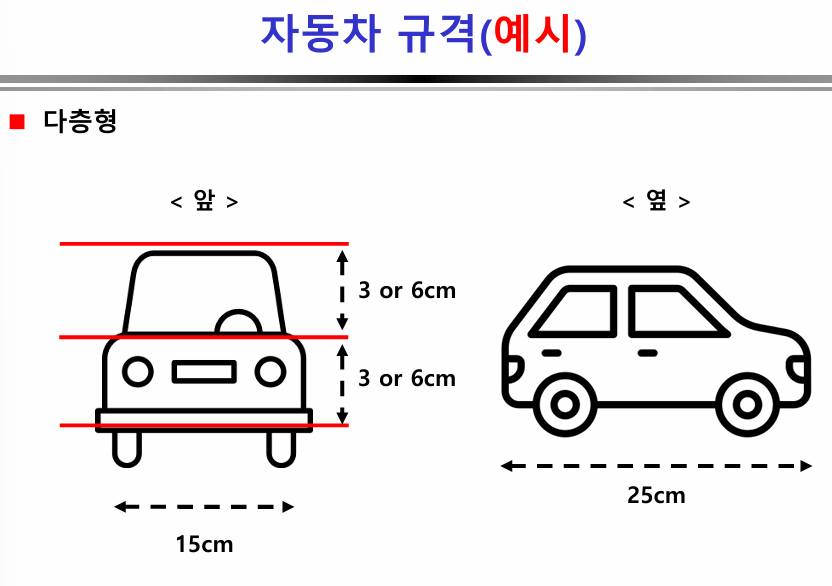
4_학교제공자료/수업자료_화면/codex-clipboard-9300ecd8-c8eb-4424-9b6d-8ff53c13cadc.png
