shinhan7n2-spec/autonomous-car/4_학교제공자료/수업자료_화면/codex-clipboard-50788761-c7a6-4c6b-be24-1c7e05d81ae3.png

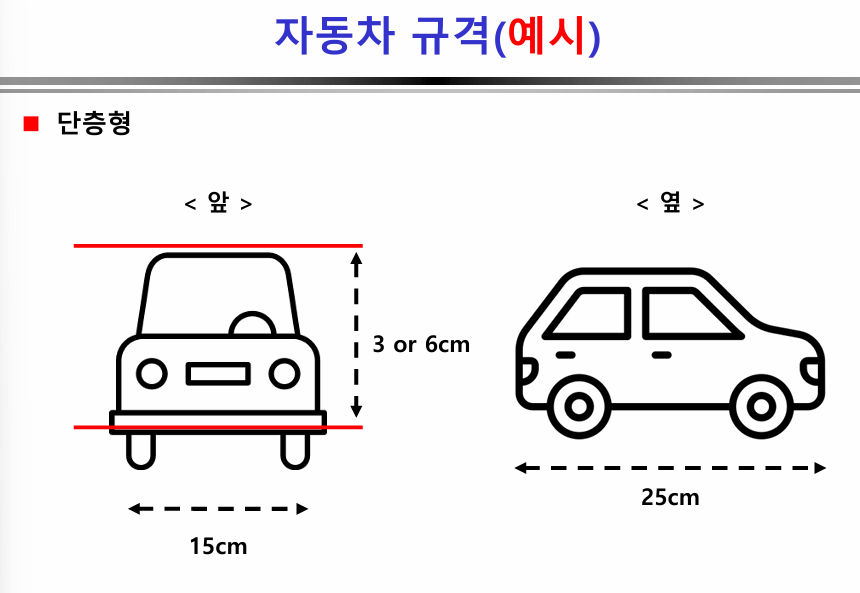
4_학교제공자료/수업자료_화면/codex-clipboard-50788761-c7a6-4c6b-be24-1c7e05d81ae3.png
