shinhan7n2-spec/autonomous-car/4_학교제공자료/수업자료_화면/codex-clipboard-a1e0bcf6-83b5-4419-bb41-9d23d388642d.png

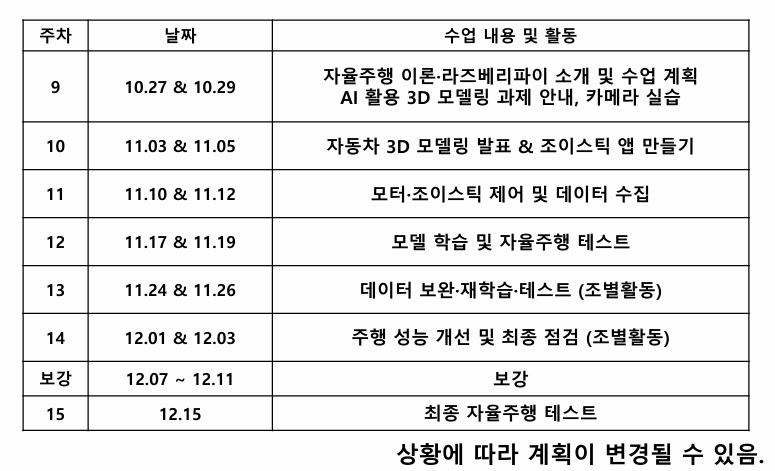
4_학교제공자료/수업자료_화면/codex-clipboard-a1e0bcf6-83b5-4419-bb41-9d23d388642d.png
