shinhan7n2-spec/autonomous-car/4_학교제공자료/수업자료_화면/codex-clipboard-ab90ba45-f017-48ab-953f-3247253fcb86.png

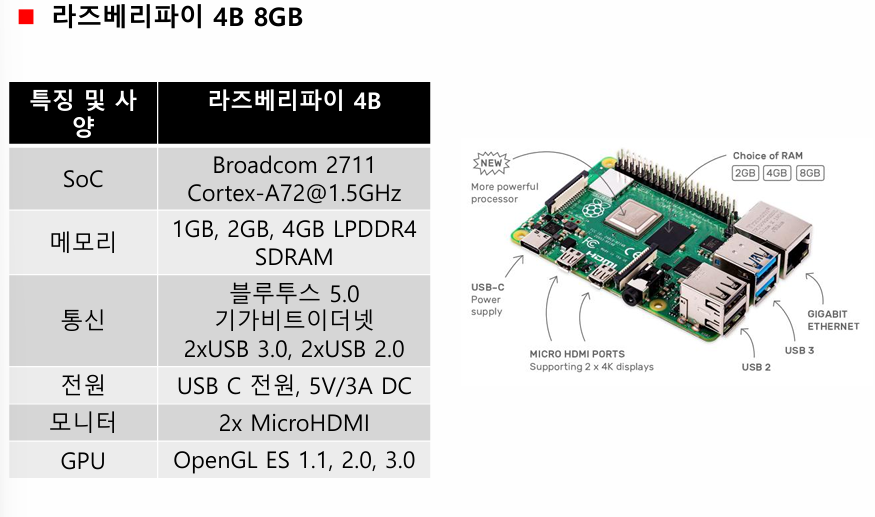
4_학교제공자료/수업자료_화면/codex-clipboard-ab90ba45-f017-48ab-953f-3247253fcb86.png
