shinhan7n2-spec/autonomous-car/4_학교제공자료/수업자료_화면/codex-clipboard-e3e7388d-c9b6-4a66-864a-0f1dfd0d7bb5.png

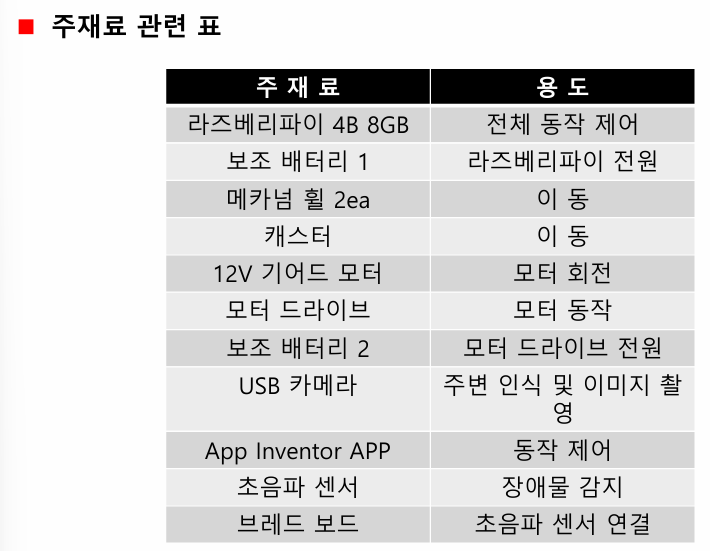
4_학교제공자료/수업자료_화면/codex-clipboard-e3e7388d-c9b6-4a66-864a-0f1dfd0d7bb5.png
