shinhan7n2-spec/autonomous-car/4_학교제공자료/수업자료_화면/codex-clipboard-f1c8fd5a-41fa-43a4-a2e0-e07d916d58b3.png

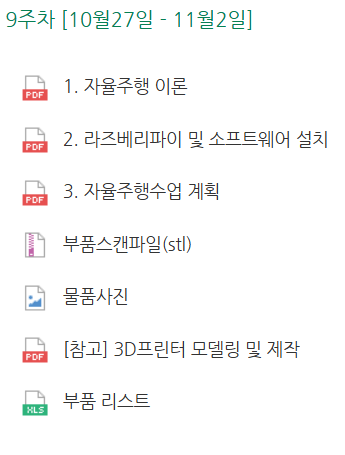
4_학교제공자료/수업자료_화면/codex-clipboard-f1c8fd5a-41fa-43a4-a2e0-e07d916d58b3.png
