shinhan7n2-spec/autonomous-car/5_과거기록/2026-10-29/01_배치_v1/20261029_layout_v1_A/20261029_자율주행자동차_층별프리뷰_v1.0_A.png

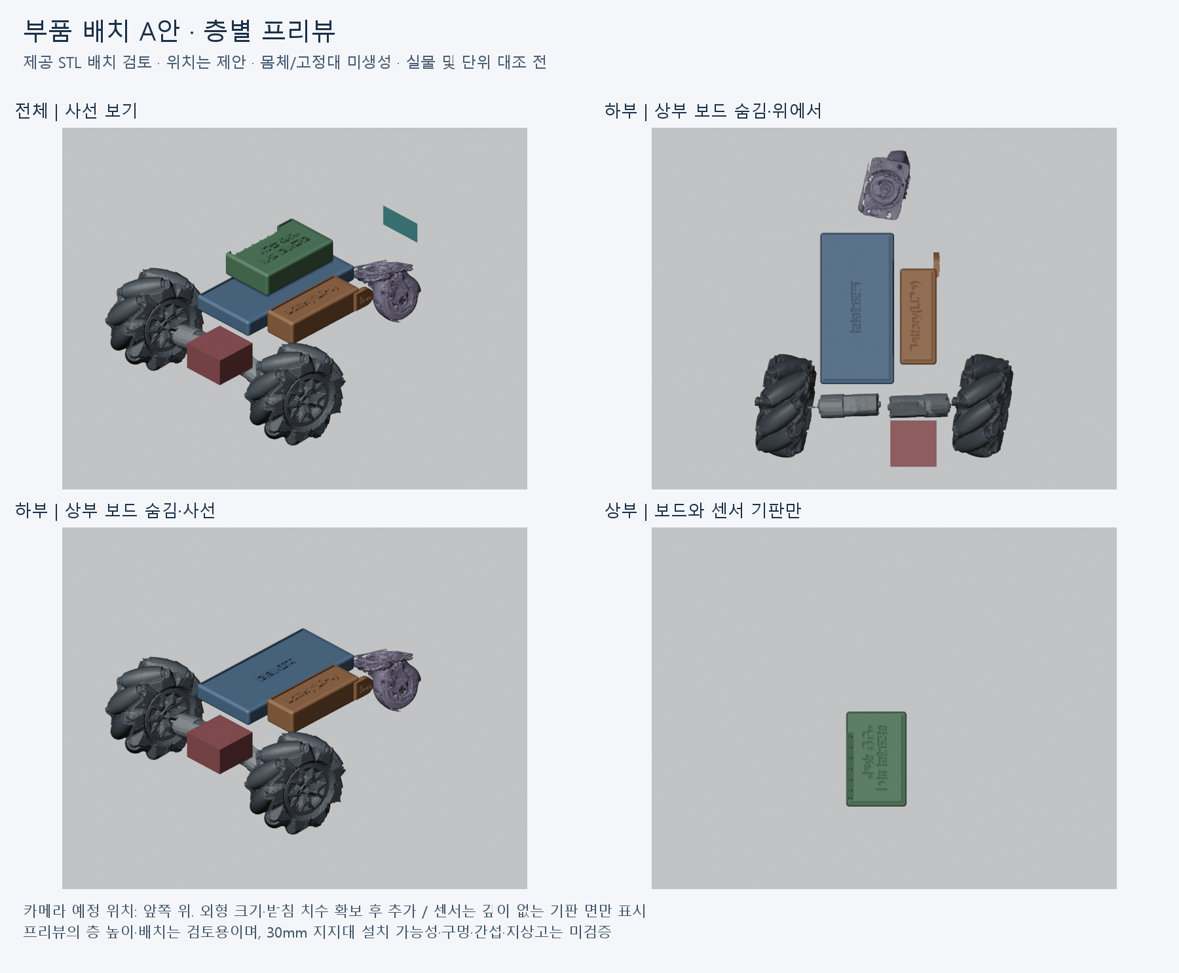
5_과거기록/2026-10-29/01_배치_v1/20261029_layout_v1_A/20261029_자율주행자동차_층별프리뷰_v1.0_A.png
