shinhan7n2-spec/autonomous-car/5_과거기록/2026-10-29/01_배치_v1/20261029_layout_v1_A/front.png

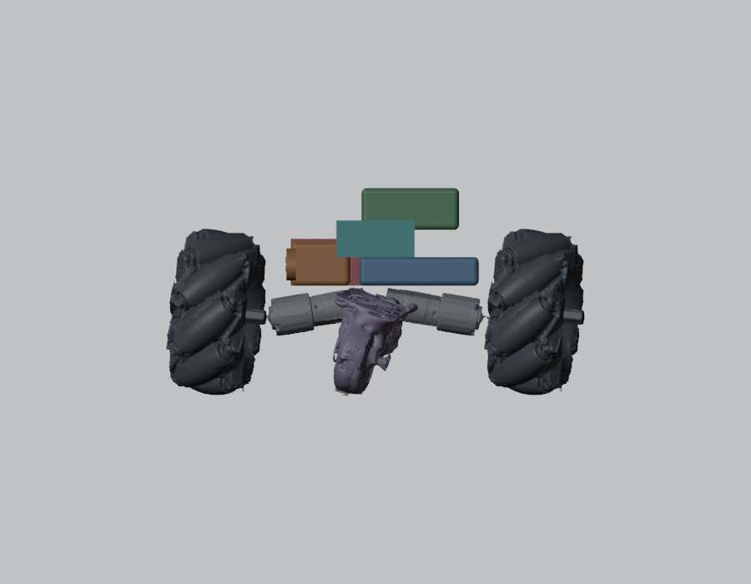
5_과거기록/2026-10-29/01_배치_v1/20261029_layout_v1_A/front.png
