shinhan7n2-spec/autonomous-car/5_과거기록/2026-10-29/02_구조_v2/20261029_structure_v2_A/front_iso.png

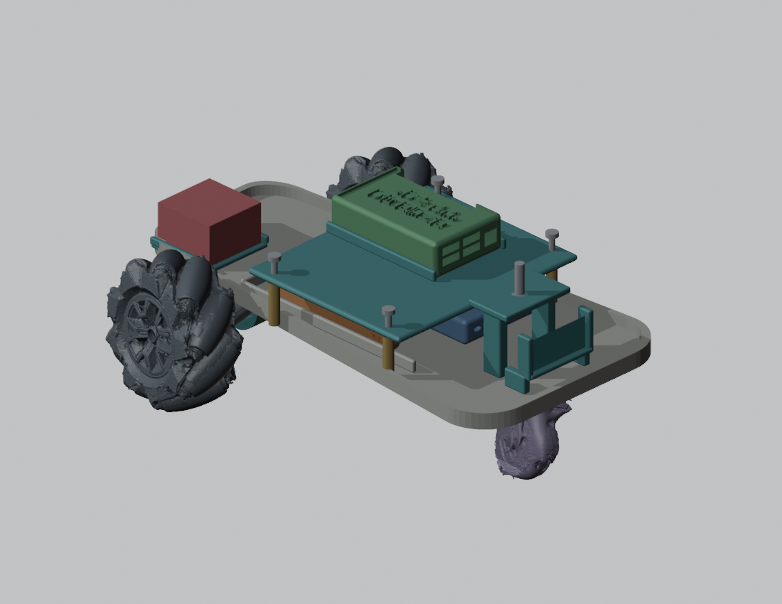
5_과거기록/2026-10-29/02_구조_v2/20261029_structure_v2_A/front_iso.png
