shinhan7n2-spec/autonomous-car/5_과거기록/2026-10-29/04_통합_v4/20261029_battery_service_v4_2_A/battery_removal.png

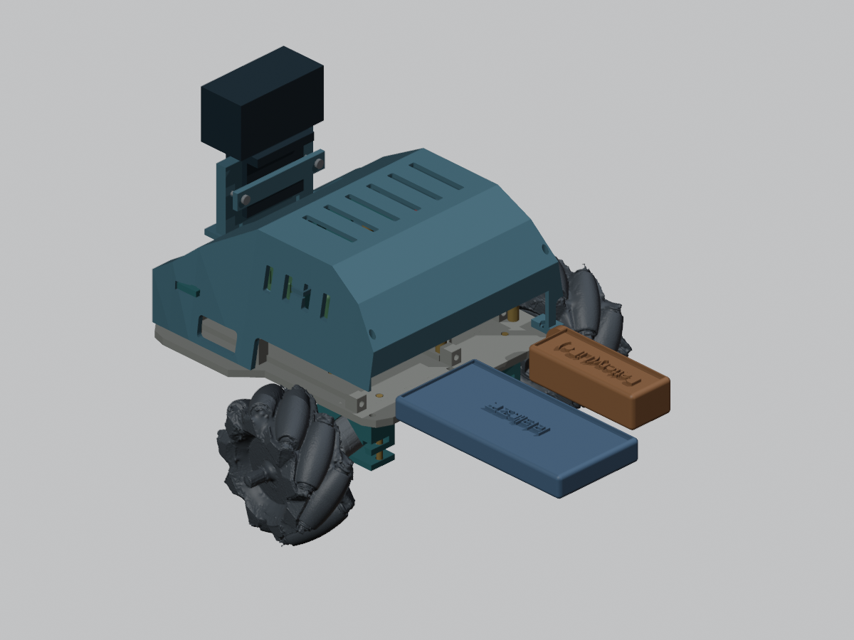
5_과거기록/2026-10-29/04_통합_v4/20261029_battery_service_v4_2_A/battery_removal.png
