shinhan7n2-spec/autonomous-car/5_과거기록/2026-10-29/04_통합_v4/20261029_integrated_v4_A/side.png

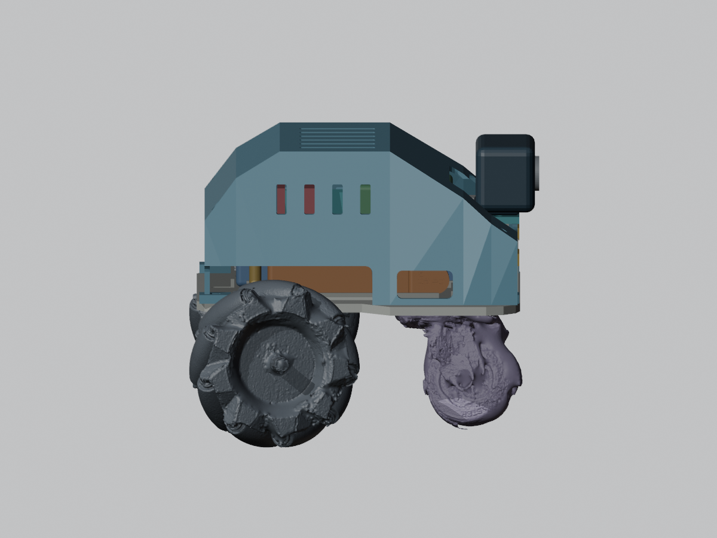
5_과거기록/2026-10-29/04_통합_v4/20261029_integrated_v4_A/side.png
