shinhan7n2-spec/autonomous-car/5_과거기록/2026-10-29/04_통합_v4/20261029_sensor_mount_v4_3_A/sensor_front_cover.png

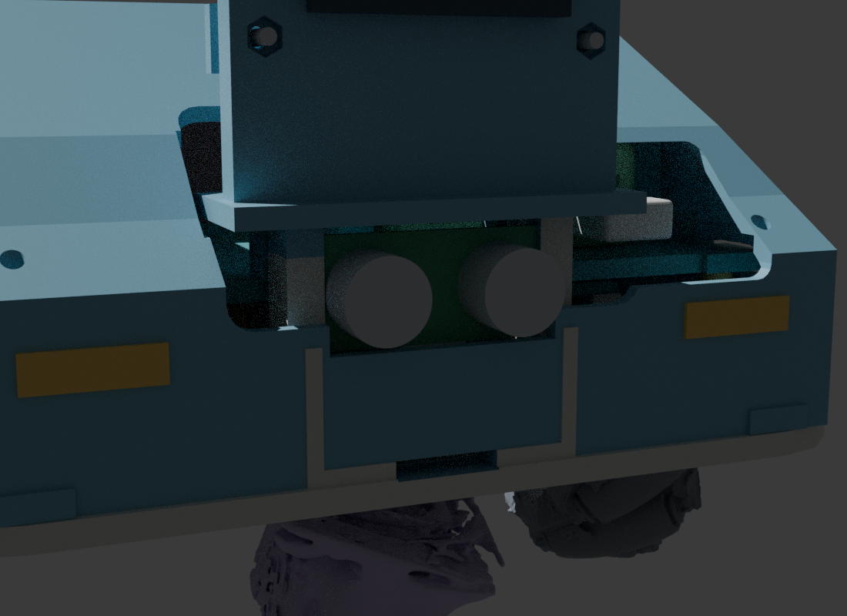
5_과거기록/2026-10-29/04_통합_v4/20261029_sensor_mount_v4_3_A/sensor_front_cover.png
