shinhan7n2-spec/autonomous-car/5_과거기록/2026-10-29/05_덮개_출력세트_v5/20261029_cover_v5_0_A/cover_v5_lifted.png

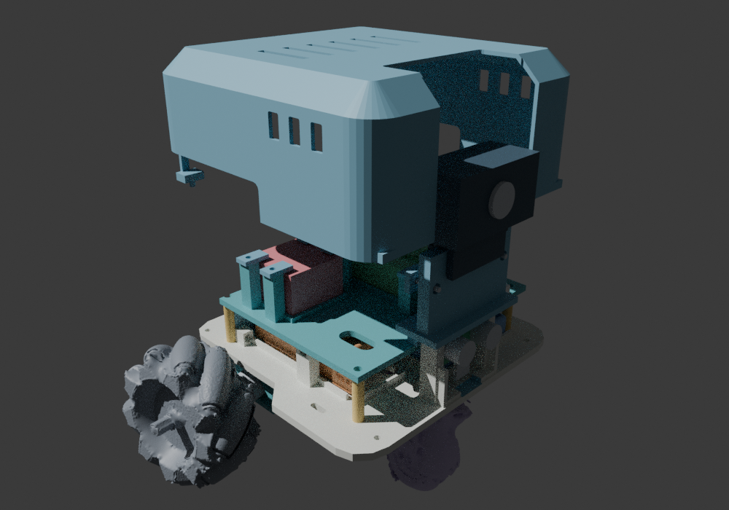
5_과거기록/2026-10-29/05_덮개_출력세트_v5/20261029_cover_v5_0_A/cover_v5_lifted.png
