shinhan7n2-spec/autonomous-car/6_발표자료/img/s6_a13_camera.jpg

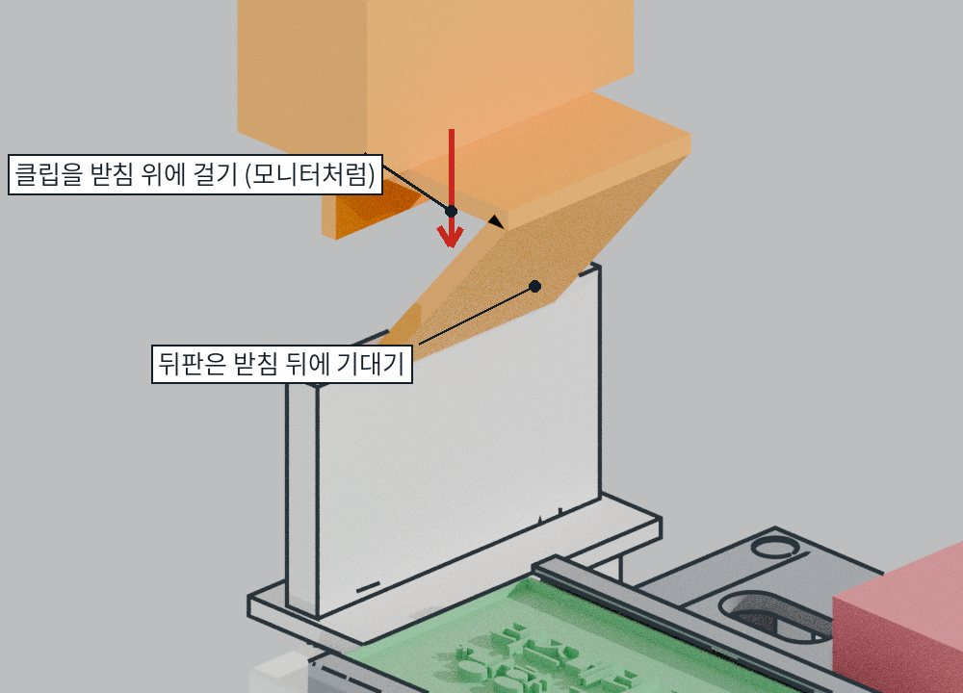
6_발표자료/img/s6_a13_camera.jpg
