shinhan7n2-spec/autonomous-car/6_발표자료/img/v3.jpg

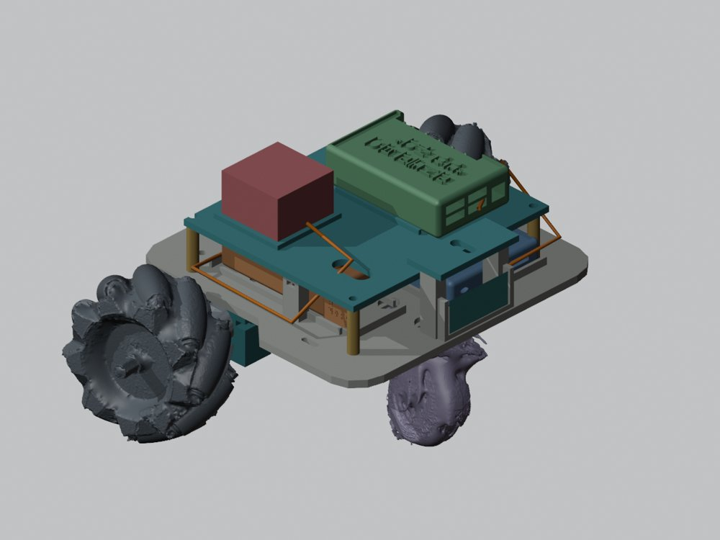
6_발표자료/img/v3.jpg
