shinhan7n2-spec/autonomous-car/6_발표자료/img/v6.jpg

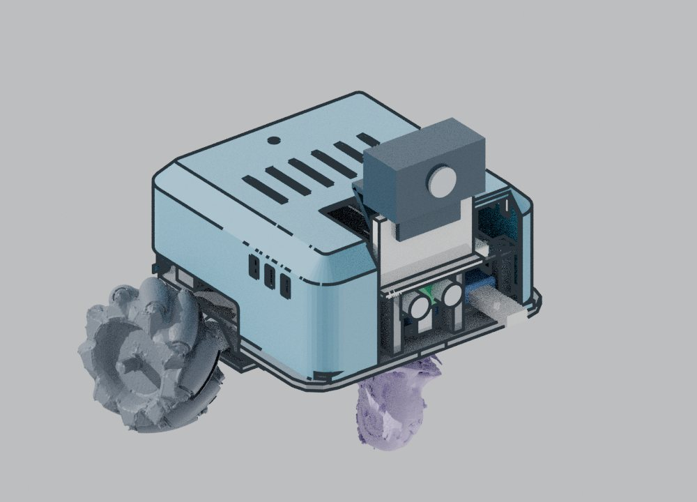
6_발표자료/img/v6.jpg
