shinhan7n2-spec/autonomous-car/(list of files, cad)

Other CAD files:
1_출력파일_v6.3/개별부품_다시뽑을때/P02_분리선반_150x130x4.stl
1_출력파일_v6.3/출력3_P02_선반.stl
4_학교제공자료/부품/stl/캐스터 휠.stl
5_과거기록/2026-10-29/03_조립_v3/20261029_assembly_v3_3_A/STL/06_P06_R_U받침_V홈.stl
5_과거기록/2026-10-29/04_통합_v4/20261029_battery_service_v4_2_A/P14_BANK_뒤잠금판.stl
5_과거기록/2026-10-29/04_통합_v4/20261029_camera_clip_v4_1_A/P13_カメラ_뒤클립누름판.stl
5_과거기록/2026-10-29/04_통합_v4/20261029_integrated_v4_A/STL_슬라이서검사전/P11_PI_脱落防止.001.stl
5_과거기록/2026-10-29/04_통합_v4/20261029_sensor_mount_v4_3_A/P01_한장바닥판_190x185x5.stl
5_과거기록/2026-10-29/05_덮개_출력세트_v5/20261029_cover_v5_0_A/P10_들어올림덮개_v5.stl
5_과거기록/2026-10-29/05_덮개_출력세트_v5/20261029_출력세트_v5.2_A/_이전파일_출력하지않음/P05_리포배터리_고정가로대.stl
5_과거기록/2026-10-29/05_덮개_출력세트_v5/20261029_출력세트_v5.2_A/P07_L_평판.stl
1_출력파일_v6.3/개별부품_다시뽑을때/P15_보드_뒤막대.stl
1_출력파일_v6.3/출력2_P01_바닥판.stl
4_학교제공자료/부품/stl/모터.stl
5_과거기록/2026-10-29/03_조립_v3/20261029_assembly_v3_3_A/STL/09_P09_카메라받침_추정.stl
5_과거기록/2026-10-29/04_통합_v4/20261029_battery_service_v4_2_A/P02_분리선반_150x130x4.stl
5_과거기록/2026-10-29/04_통합_v4/20261029_camera_clip_v4_1_A/P09_카메라_클립받침.stl
5_과거기록/2026-10-29/04_통합_v4/20261029_integrated_v4_A/STL_슬라이서검사전/P11_DRIVER_脱落防止.003.stl
5_과거기록/2026-10-29/04_통합_v4/20261029_sensor_mount_v4_3_A/P02_분리선반_150x130x4.stl
5_과거기록/2026-10-29/05_덮개_출력세트_v5/20261029_출력세트_v5.2_A/_이전파일_출력하지않음/P04_보조배터리_고정가로대.stl
5_과거기록/2026-10-29/05_덮개_출력세트_v5/20261029_출력세트_v5.2_A/P04_배터리_고정가로대_일체.stl
1_출력파일_v6.3/개별부품_다시뽑을때/P09_카메라_받침_일체.stl
1_출력파일_v6.3/출력1_작은부품7개_한판.stl
4_학교제공자료/부품/stl/리포배터리.stl
5_과거기록/2026-10-29/03_조립_v3/20261029_assembly_v3_3_A/STL/04_P05_리포배터리_고정가로대.stl
5_과거기록/2026-10-29/04_통합_v4/20261029_battery_service_v4_2_A/P10_해치백덮개.stl
5_과거기록/2026-10-29/04_통합_v4/20261029_camera_clip_v4_1_A/P10_해치백덮개.stl
5_과거기록/2026-10-29/04_통합_v4/20261029_integrated_v4_A/STL_슬라이서검사전/P11_DRIVER_脱落防止.001.stl
5_과거기록/2026-10-29/04_통합_v4/20261029_sensor_mount_v4_3_A/P09_카메라_클립받침.stl
5_과거기록/2026-10-29/05_덮개_출력세트_v5/20261029_출력세트_v5.2_A/P14_LIPO_뒤잠금판.stl
1_출력파일_v6.3/개별부품_다시뽑을때/P10_들어올림덮개_v5_1.stl
1_출력파일_v6.3/출력4_P10_덮개.stl
4_학교제공자료/부품/stl/보조배터리.stl
5_과거기록/2026-10-29/03_조립_v3/20261029_assembly_v3_3_A/STL/05_P06_L_U받침_V홈.stl
5_과거기록/2026-10-29/04_통합_v4/20261029_battery_service_v4_2_A/P01_한장바닥판_190x185x5.stl
5_과거기록/2026-10-29/04_통합_v4/20261029_integrated_v4_A/STL_슬라이서검사전/P11_DRIVER_脱落防止.002.stl
5_과거기록/2026-10-29/04_통합_v4/20261029_sensor_mount_v4_3_A/P10_해치백덮개.stl
5_과거기록/2026-10-29/05_덮개_출력세트_v5/20261029_출력세트_v5.2_A/P13_カメラ_뒤클립누름판.stl
1_출력파일_v6.3/개별부품_다시뽑을때/P07_모터하판_일체.stl
4_학교제공자료/부품/stl/라즈베리.stl
5_과거기록/2026-10-29/03_조립_v3/20261029_assembly_v3_3_A/STL/07_P07_L_평판.stl
5_과거기록/2026-10-29/04_통합_v4/20261029_battery_service_v4_2_A/P14_LIPO_뒤잠금판.stl
5_과거기록/2026-10-29/04_통합_v4/20261029_integrated_v4_A/STL_슬라이서검사전/P02_분리선반_150x130x4.stl
5_과거기록/2026-10-29/05_덮개_출력세트_v5/20261029_출력세트_v5.2_A/P14_BANK_뒤잠금판.stl
1_출력파일_v6.3/개별부품_다시뽑을때/P06_모터받침_일체.stl
4_학교제공자료/부품/stl/메카넘휠.stl
5_과거기록/2026-10-29/03_조립_v3/20261029_assembly_v3_3_A/STL/08_P07_R_평판.stl
5_과거기록/2026-10-29/04_통합_v4/20261029_integrated_v4_A/STL_슬라이서검사전/P11_PI_脱落防止.stl
5_과거기록/2026-10-29/05_덮개_출력세트_v5/20261029_출력세트_v5.2_A/P11_PI_脱落防止_002.stl
1_출력파일_v6.3/개별부품_다시뽑을때/P01_한장바닥판_190x185x5.stl
5_과거기록/2026-10-29/03_조립_v3/20261029_assembly_v3_3_A/STL/01_P01_한장바닥판_190x185x5.stl
5_과거기록/2026-10-29/04_통합_v4/20261029_integrated_v4_A/STL_슬라이서검사전/P11_PI_脱落防止.003.stl
5_과거기록/2026-10-29/05_덮개_출력세트_v5/20261029_출력세트_v5.2_A/P06_R_U받침_V홈.stl
1_출력파일_v6.3/개별부품_다시뽑을때/P14_LIPO_뒤잠금판.stl
5_과거기록/2026-10-29/03_조립_v3/20261029_assembly_v3_3_A/STL/03_P04_보조배터리_고정가로대.stl
5_과거기록/2026-10-29/04_통합_v4/20261029_integrated_v4_A/STL_슬라이서검사전/P11_DRIVER_脱落防止.stl
5_과거기록/2026-10-29/05_덮개_출력세트_v5/20261029_출력세트_v5.2_A/P11_PI_脱落防止_001.stl
1_출력파일_v6.3/개별부품_다시뽑을때/P14_BANK_뒤잠금판.stl
5_과거기록/2026-10-29/03_조립_v3/20261029_assembly_v3_3_A/STL/02_P02_분리선반_150x130x4.stl
5_과거기록/2026-10-29/04_통합_v4/20261029_integrated_v4_A/STL_슬라이서검사전/P11_PI_脱落防止.002.stl
5_과거기록/2026-10-29/05_덮개_출력세트_v5/20261029_출력세트_v5.2_A/P07_R_평판.stl
1_출력파일_v6.3/개별부품_다시뽑을때/P04_배터리_고정가로대_일체.stl
5_과거기록/2026-10-29/04_통합_v4/20261029_integrated_v4_A/STL_슬라이서검사전/P04_보조배터리_고정가로대.stl
5_과거기록/2026-10-29/05_덮개_출력세트_v5/20261029_출력세트_v5.2_A/P01_한장바닥판_190x185x5.stl
5_과거기록/2026-10-29/04_통합_v4/20261029_integrated_v4_A/STL_슬라이서검사전/P06_L_U받침_V홈.stl
5_과거기록/2026-10-29/05_덮개_출력세트_v5/20261029_출력세트_v5.2_A/P11_DRIVER_脱落防止.stl
5_과거기록/2026-10-29/04_통합_v4/20261029_integrated_v4_A/STL_슬라이서검사전/P12_센서뒤고정띠.stl
5_과거기록/2026-10-29/05_덮개_출력세트_v5/20261029_출력세트_v5.2_A/P09_카메라_클립받침.stl
5_과거기록/2026-10-29/04_통합_v4/20261029_integrated_v4_A/STL_슬라이서검사전/P09_카메라받침_추정.stl
5_과거기록/2026-10-29/05_덮개_출력세트_v5/20261029_출력세트_v5.2_A/P06_L_U받침_V홈.stl
5_과거기록/2026-10-29/04_통합_v4/20261029_integrated_v4_A/STL_슬라이서검사전/P10_해치백덮개.stl
5_과거기록/2026-10-29/05_덮개_출력세트_v5/20261029_출력세트_v5.2_A/P11_PI_脱落防止.stl
5_과거기록/2026-10-29/04_통합_v4/20261029_integrated_v4_A/STL_슬라이서검사전/P06_R_U받침_V홈.stl
5_과거기록/2026-10-29/05_덮개_출력세트_v5/20261029_출력세트_v5.2_A/P11_DRIVER_脱落防止_002.stl
5_과거기록/2026-10-29/04_통합_v4/20261029_integrated_v4_A/STL_슬라이서검사전/P07_L_평판.stl
5_과거기록/2026-10-29/05_덮개_출력세트_v5/20261029_출력세트_v5.2_A/P10_들어올림덮개_v5_1.stl
5_과거기록/2026-10-29/04_통합_v4/20261029_integrated_v4_A/STL_슬라이서검사전/P07_R_평판.stl
5_과거기록/2026-10-29/05_덮개_출력세트_v5/20261029_출력세트_v5.2_A/P11_DRIVER_脱落防止_003.stl
5_과거기록/2026-10-29/04_통합_v4/20261029_integrated_v4_A/STL_슬라이서검사전/P01_한장바닥판_190x185x5.stl
5_과거기록/2026-10-29/05_덮개_출력세트_v5/20261029_출력세트_v5.2_A/P11_PI_脱落防止_003.stl
5_과거기록/2026-10-29/04_통합_v4/20261029_integrated_v4_A/STL_슬라이서검사전/P05_리포배터리_고정가로대.stl
5_과거기록/2026-10-29/05_덮개_출력세트_v5/20261029_출력세트_v5.2_A/P02_분리선반_150x130x4.stl
5_과거기록/2026-10-29/05_덮개_출력세트_v5/20261029_출력세트_v5.2_A/P11_DRIVER_脱落防止_001.stl
5_과거기록/2026-10-29/01_배치_v1/모델/20261029_자율주행자동차_부품배치_v1.0_A.blend
5_과거기록/2026-10-29/02_구조_v2/모델/20261029_자율주행자동차_몸체조립검토_v2.0_A.blend
5_과거기록/2026-10-29/03_조립_v3/20261029_assembly_v3_A/STL_REVIEW_출력확정전/01_P01_한장바닥판_190x185x5_REVIEW.stl
5_과거기록/2026-10-29/03_조립_v3/20261029_assembly_v3_A/STL_REVIEW_출력확정전/02_P02_분리선반_150x130x4_REVIEW.stl
5_과거기록/2026-10-29/03_조립_v3/20261029_assembly_v3_A/STL_REVIEW_출력확정전/03_P04_보조배터리_고정가로대_REVIEW.stl
5_과거기록/2026-10-29/03_조립_v3/20261029_assembly_v3_A/STL_REVIEW_출력확정전/04_P05_리포배터리_고정가로대_REVIEW.stl
5_과거기록/2026-10-29/03_조립_v3/20261029_assembly_v3_A/STL_REVIEW_출력확정전/05_P06_모터상부_추정끼움_REVIEW.stl
5_과거기록/2026-10-29/03_조립_v3/20261029_assembly_v3_A/STL_REVIEW_출력확정전/06_P06_모터상부_추정끼움.001_REVIEW.stl
5_과거기록/2026-10-29/03_조립_v3/20261029_assembly_v3_A/STL_REVIEW_출력확정전/07_P07_모터하부_추정끼움_REVIEW.stl
5_과거기록/2026-10-29/03_조립_v3/20261029_assembly_v3_A/STL_REVIEW_출력확정전/08_P07_모터하부_추정끼움.001_REVIEW.stl
5_과거기록/2026-10-29/03_조립_v3/20261029_assembly_v3_A/STL_REVIEW_출력확정전/09_P09_카메라받침_추정_REVIEW.stl
5_과거기록/2026-10-29/03_조립_v3/모델/20261029_자율주행자동차_U받침조립_v3.3_A.blend
5_과거기록/2026-10-29/03_조립_v3/모델/20261029_자율주행자동차_덮개프리뷰_v3.4_A.blend
5_과거기록/2026-10-29/03_조립_v3/모델/20261029_자율주행자동차_원본배율검토_v3.0_A.blend
5_과거기록/2026-10-29/03_조립_v3/모델/20261029_자율주행자동차_한장차체조립_v3.1_A.blend
5_과거기록/2026-10-29/03_조립_v3/모델/20261029_자율주행자동차_한장차체조립_v3.2_A.blend
5_과거기록/2026-10-29/04_통합_v4/모델/20261029_자율주행자동차_배터리탈착_v4.2_A.blend
5_과거기록/2026-10-29/04_통합_v4/모델/20261029_자율주행자동차_카메라클립_v4.1_A.blend
5_과거기록/2026-10-29/04_통합_v4/모델/20261029_자율주행자동차_통합설계_v4.0_A.blend
5_과거기록/2026-10-30/06_v6.3_최신모델/20261030_자율주행자동차_최종_v6.3.blend
5_과거기록/2026-10-30/06_v6.3_최신모델/20261030_자율주행자동차_최종_v6.4.blend
