shinhan7n2-spec/autonomous-car/3_조립설명서/index.html

설계 v6 · 2026-10-30 · 출력 마감 11월 10일(화)

# 자율주행차 제작 설명서

완성 모델

- 출력 부품 10개, 출력판 4번
- 볼트는 키트 것만
- 덮개는 볼트 1개 풀고 위로 들어 올림
- 배터리는 공구 없이 뒤로 빼기

## 1 출력

- 파일: 1_출력파일_v6.3 폴더의 출력1~4 4개
- 방향은 맞춰 둠. 슬라이서에 그대로 놓기
- PLA · 층 0.2mm · 채움 20% · 벽 4줄 · 서포트 출력판에서만

출력판 위 모습 | 부품 | 뽑은 뒤 확인
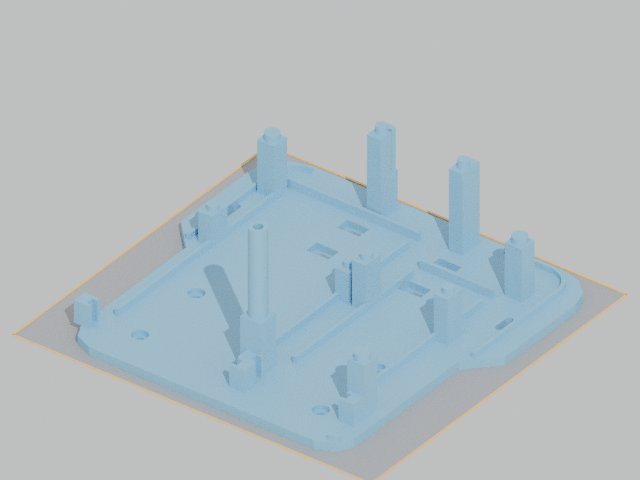
[picture p63: 3_조립설명서/img/pr_p01.jpg]
P01 바닥판
 | P01 바닥판 | 기둥 6개 곧게 섰나 · 핀 5개 온전한가
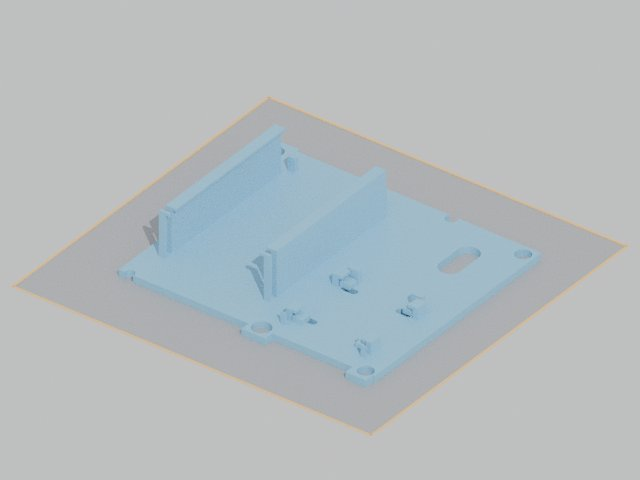
[picture p64: 3_조립설명서/img/pr_p02.jpg]
P02 선반
 | P02 선반 | 레일 위 턱 온전한가
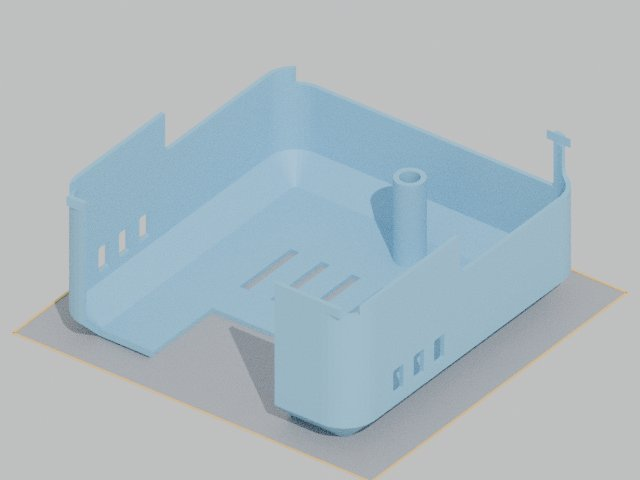
[picture p65: 3_조립설명서/img/pr_p10.jpg]
P10 덮개
 | P10 덮개 | 벽에 구멍 없나
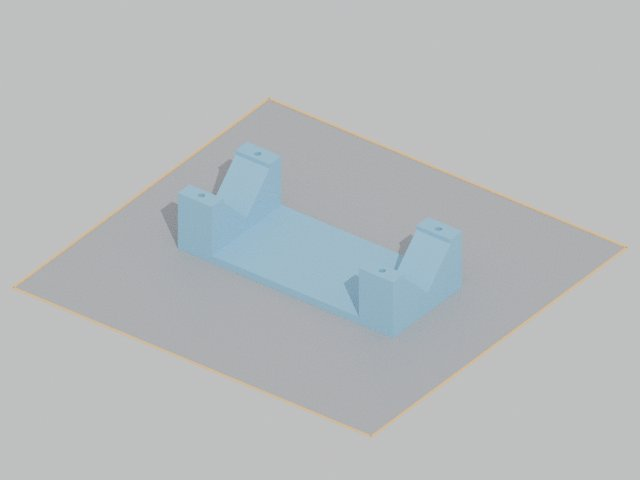
[picture p66: 3_조립설명서/img/pr_p06.jpg]
P06 모터 받침
 | P06 모터 받침 | V홈 매끈한가
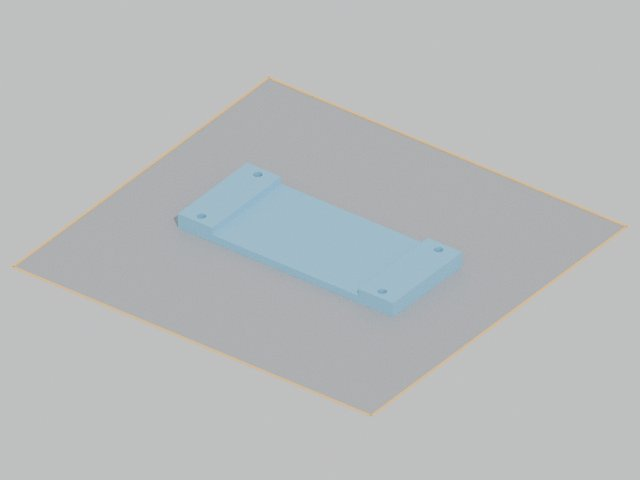
[picture p67: 3_조립설명서/img/pr_p07.jpg]
P07 모터 하판
 | P07 모터 하판 | 볼트 구멍 4개 뚫렸나
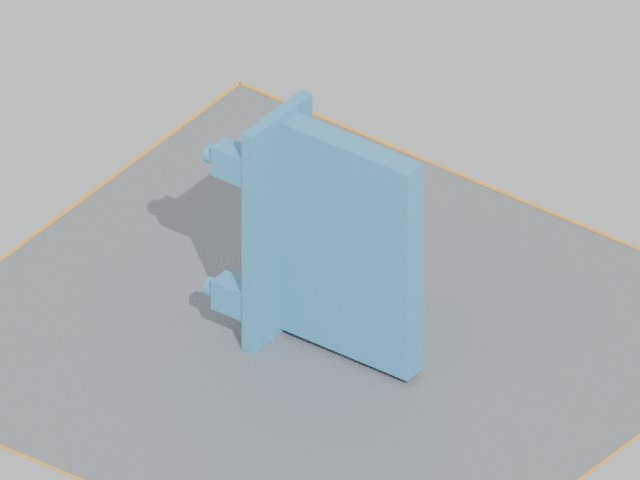
[picture p68: 3_조립설명서/img/pr_p09.jpg]
P09 카메라 받침
 | P09 카메라 받침 | 핀 2개 온전한가
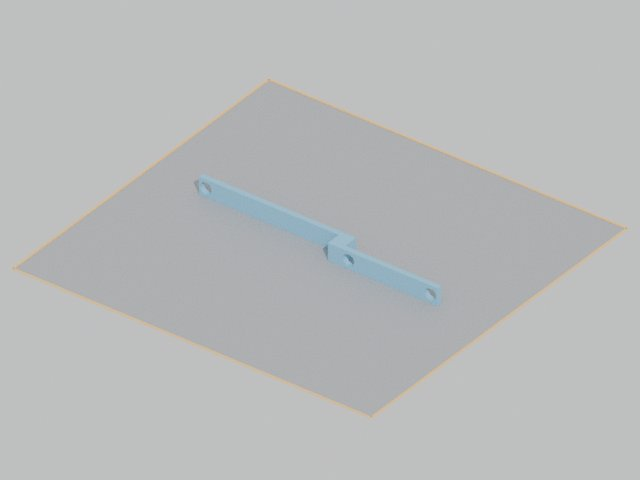
[picture p69: 3_조립설명서/img/pr_p04.jpg]
P04 가로대
 | P04 가로대 | 핀 구멍 4개
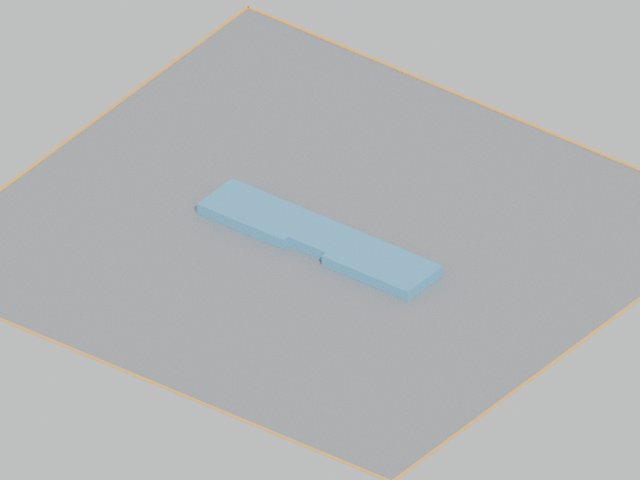
[picture p70: 3_조립설명서/img/pr_p14b.jpg]
P14 잠금판 (보조)
 | P14 잠금판 (보조) | 홈에 꽂아 보기
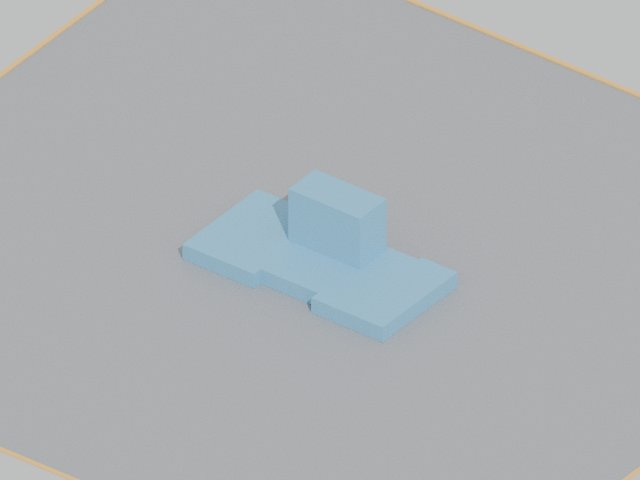
[picture p71: 3_조립설명서/img/pr_p14l.jpg]
P14 잠금판 (리포)
 | P14 잠금판 (리포) | 홈에 꽂아 보기
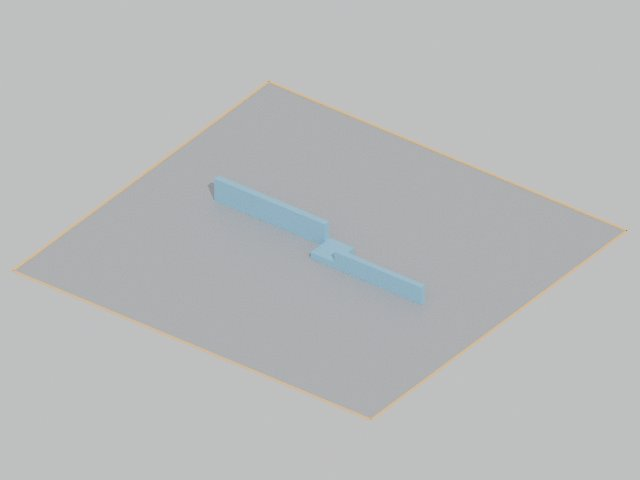
[picture p72: 3_조립설명서/img/pr_p15.jpg]
P15 보드 뒤 막대
 | P15 보드 뒤 막대 | 홈에 꽂아 보기

### 출력 순서

1. 작은 부품 한 판 (받침·하판·카메라 받침·가로대·잠금판·막대) → 끼움 시험
2. P01 바닥판 (출력판에 꽉 참, 모서리 들뜸 주의)
3. P02 선반
4. P10 덮개 (가장 오래 걸림)

## 2 볼트 (키트 것만)

어디 | 볼트 | 개수 | 팩
캐스터 | M5×10 + 너트 | 4 | 캐스터
바퀴 | M4×12, M3×8 | 2+2 | 바퀴
모터 받침·하판 | M4×20 | 8 | 지지대
덮개 (선반도 같이) | M6×20 | 1 | 카메라

- 너트 대신 출력물 구멍에 직접 조여 넣기. 처음엔 뻑뻑함, 너무 세게 조이지 않기
- 지지대(황동 기둥) 8개는 안 씀

## 3 조립

주황 = 이번에 끼우는 부품 · 빨간 화살표 = 끼우는 방향

### 출력물 손질

1. 할 일 서포트 떼기
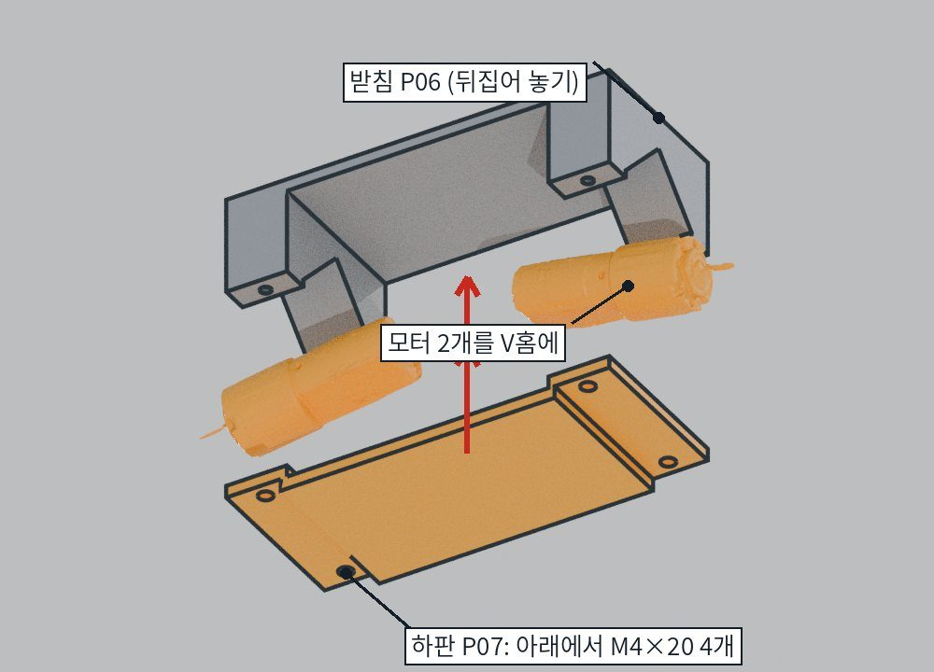
[picture p73: 3_조립설명서/img/s6_a01_motor.jpg]
모터 + 받침
2. 

### 모터 + 받침

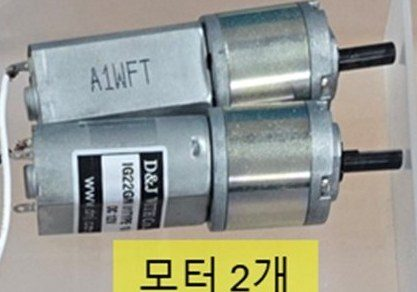
[picture p74: 3_조립설명서/img/kit_motor.jpg]
   모터
  할 일 받침 뒤집고 모터 2개, 하판 덮기
  이유 모터 고정
  볼트 M4×20 4개 (아래에서)
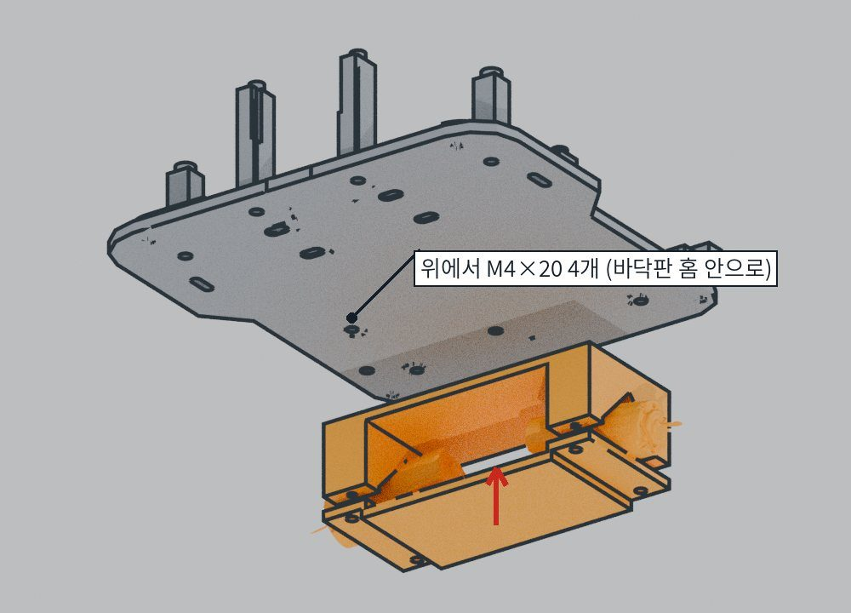
[picture p75: 3_조립설명서/img/s6_a02_to_base.jpg]
받침 → 바닥판
3. 

### 받침 → 바닥판

  할 일 바닥판 아래에 대고 위에서 조이기
  이유 바퀴 위치 고정
  볼트 M4×20 4개 (위에서)
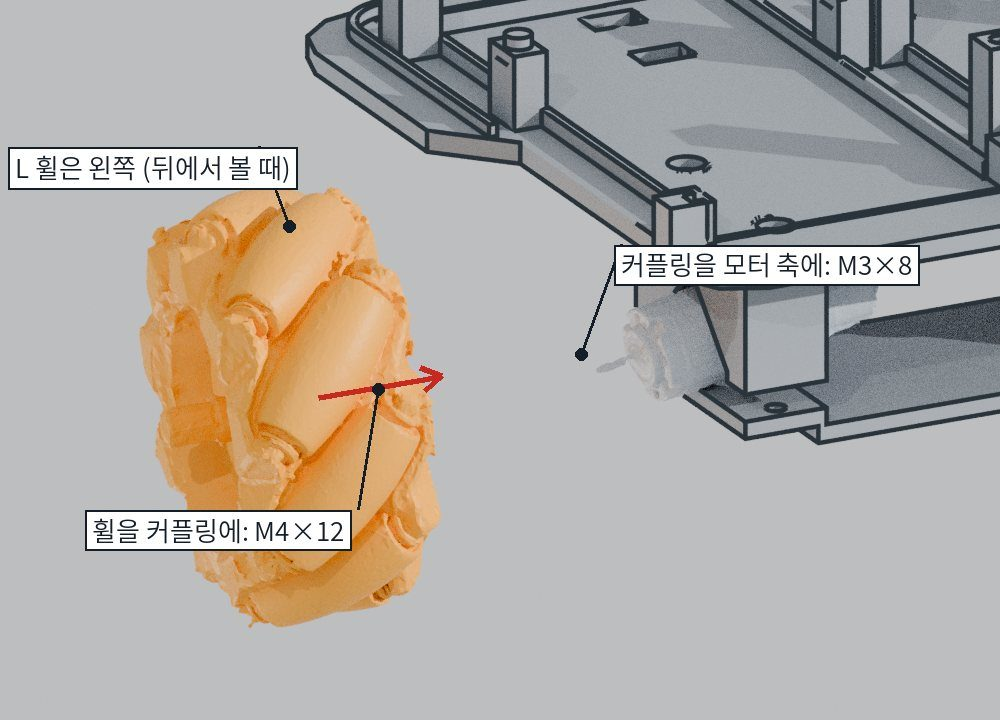
[picture p76: 3_조립설명서/img/s6_a03_wheels.jpg]
바퀴
4. 

### 바퀴

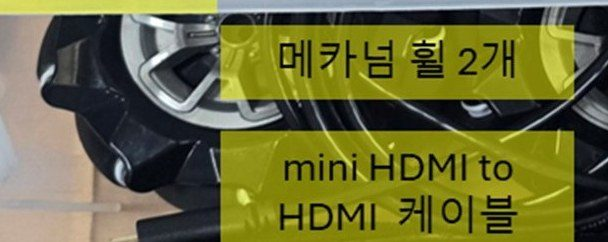
[picture p77: 3_조립설명서/img/kit_wheel.jpg]
   메카넘휠
  할 일 L 왼쪽, R 오른쪽
  이유 바꾸면 직진 안 됨
  볼트 M3×8, M4×12
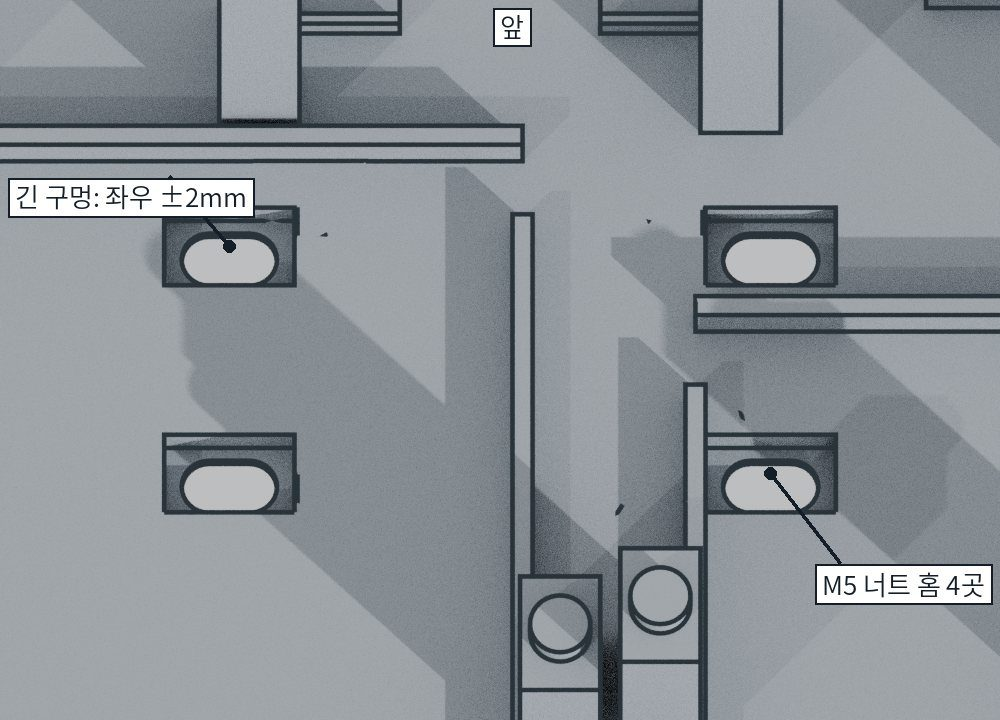
[picture p78: 3_조립설명서/img/s6_a04b_caster_nuts.jpg]
캐스터 너트
5. 

### 캐스터 너트

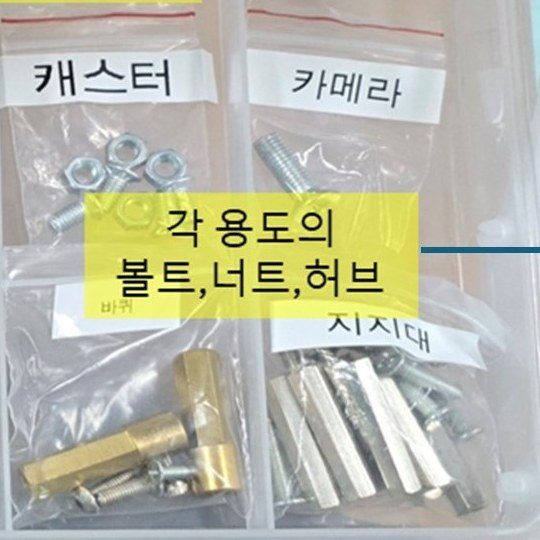
[picture p79: 3_조립설명서/img/kit_bolts.jpg]
   M5 너트
  할 일 윗면 홈 4곳에 넣기
  이유 볼트가 조여지게
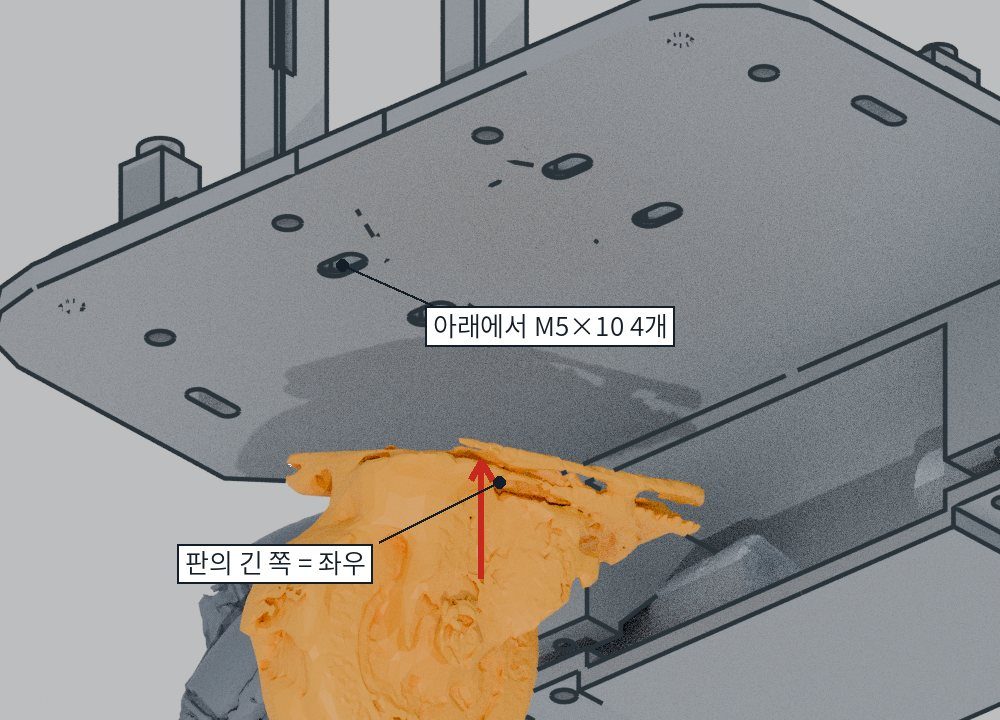
[picture p80: 3_조립설명서/img/s6_a04_caster.jpg]
캐스터
6. 

### 캐스터

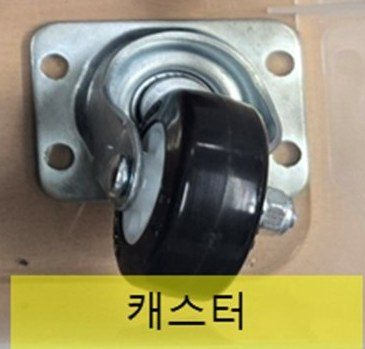
[picture p81: 3_조립설명서/img/kit_caster.jpg]
   캐스터
  할 일 아래에서 조이기
  이유 앞바퀴
  볼트 M5×10 4개
7. 배터리

### 배터리

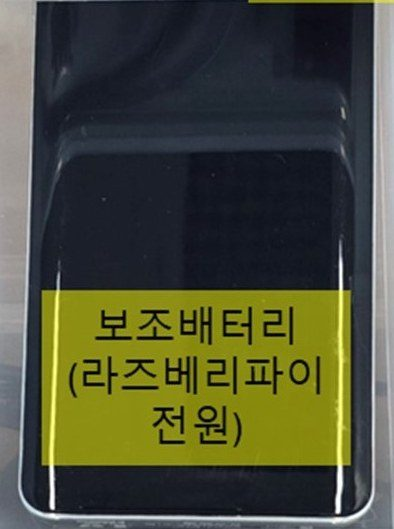
[picture p82: 3_조립설명서/img/kit_bank.jpg]
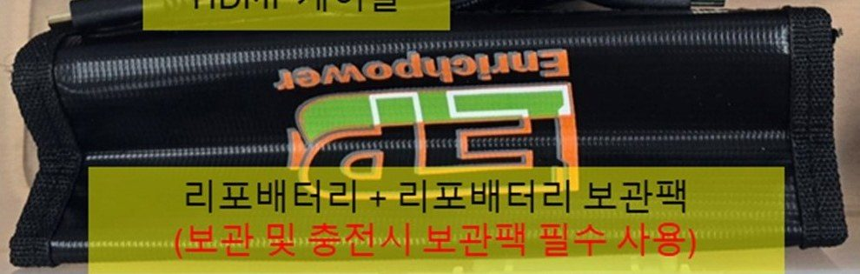
[picture p83: 3_조립설명서/img/kit_lipo.jpg]
   보조배터리  리포
  할 일 보조 왼쪽(단자 앞), 리포 오른쪽
  이유 무게 균형
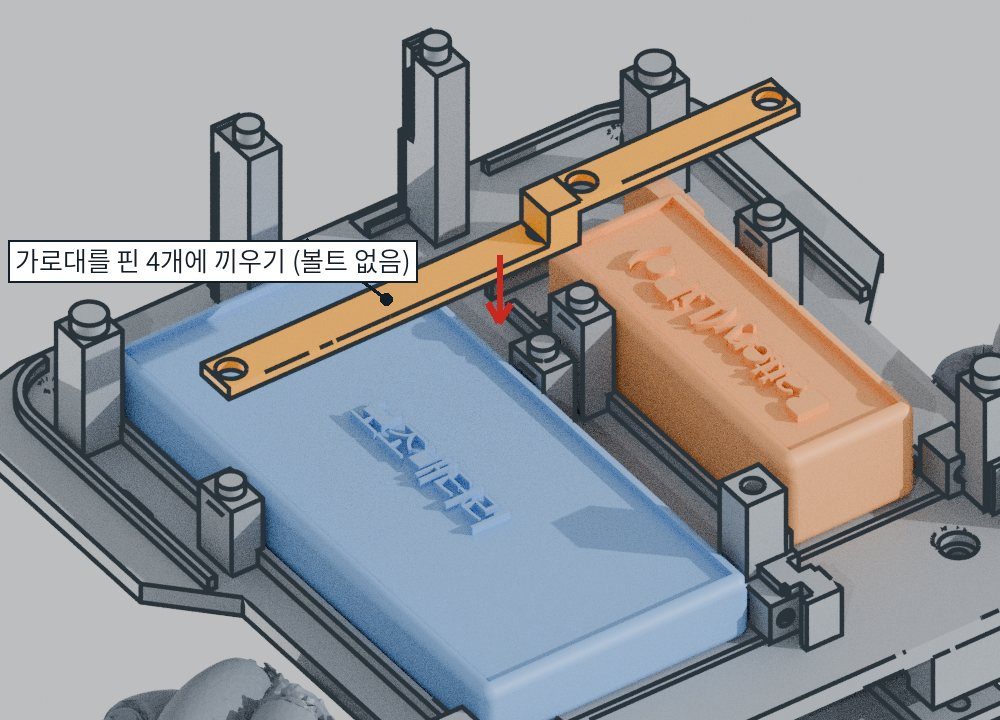
[picture p84: 3_조립설명서/img/s6_a06_bar.jpg]
가로대
8. 

### 가로대

  할 일 핀 4개에 끼우기
  이유 배터리 들뜸 방지
  볼트 없음
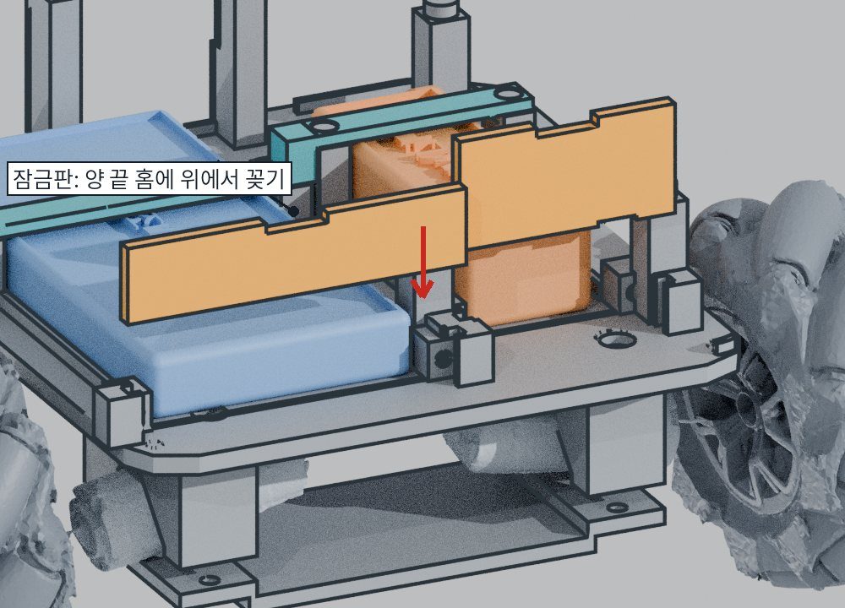
[picture p85: 3_조립설명서/img/s6_a07_gates.jpg]
잠금판
9. 

### 잠금판

  할 일 양 끝 홈에 위에서 꽂기
  이유 배터리 빠짐 방지
  볼트 없음
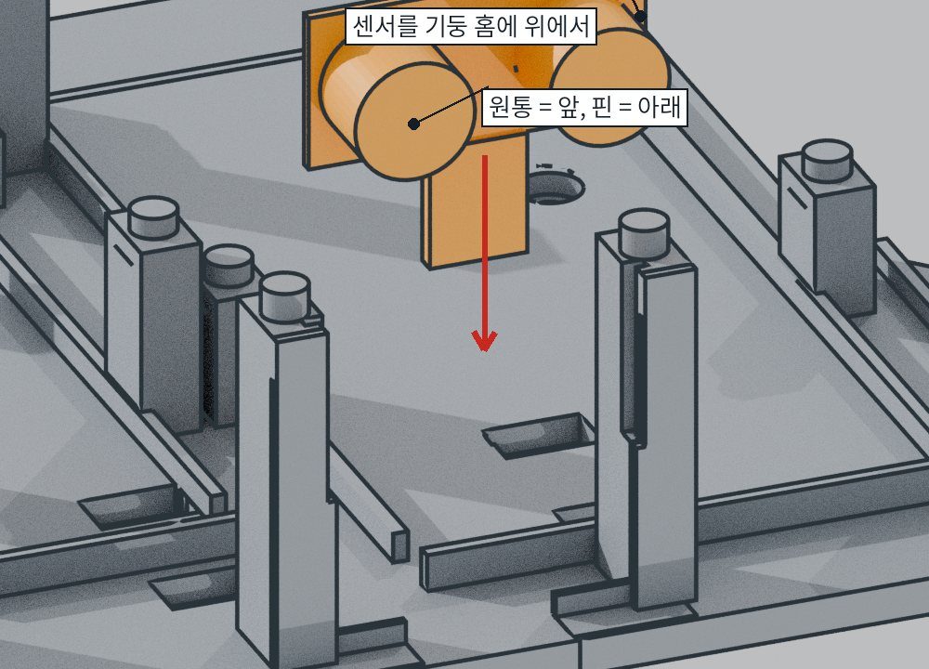
[picture p86: 3_조립설명서/img/s6_a08_sensor.jpg]
초음파 센서
10. 

### 초음파 센서

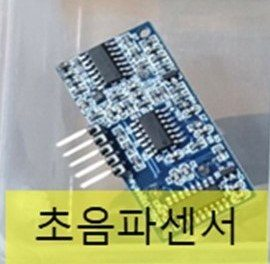
[picture p87: 3_조립설명서/img/kit_sensor.jpg]
   초음파 센서
  할 일 기둥 홈에 위에서 꽂기
  이유 앞 장애물 감지
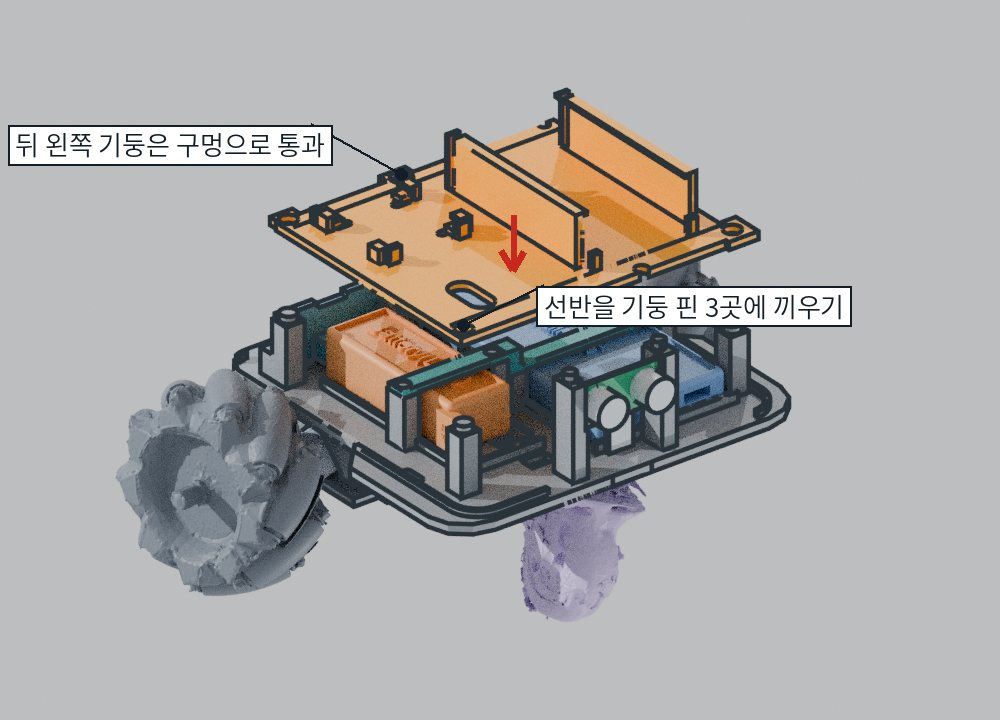
[picture p88: 3_조립설명서/img/s6_a09_shelf.jpg]
선반
11. 

### 선반

  할 일 기둥 핀 3곳에 끼우기. 뒤 왼쪽 기둥은 구멍으로 통과
  이유 보드 올릴 2층
  볼트 없음 (덮개 볼트가 같이 잡음)
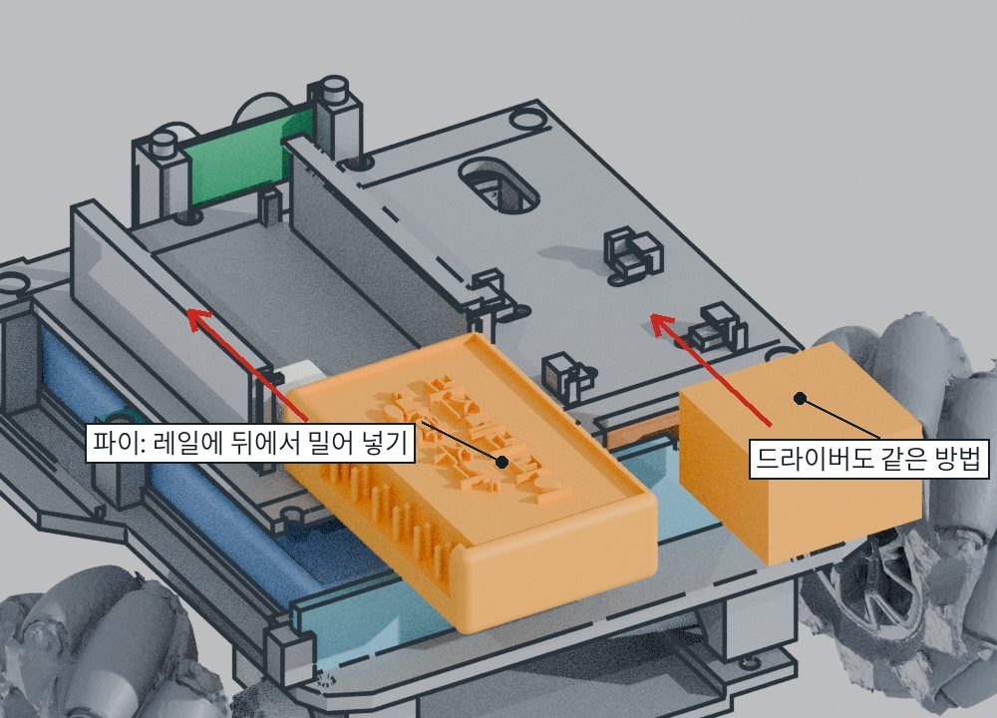
[picture p89: 3_조립설명서/img/s6_a10_boards.jpg]
파이·드라이버
12. 

### 파이·드라이버

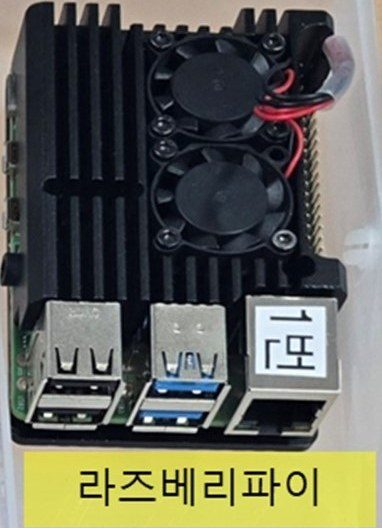
[picture p90: 3_조립설명서/img/kit_pi.jpg]
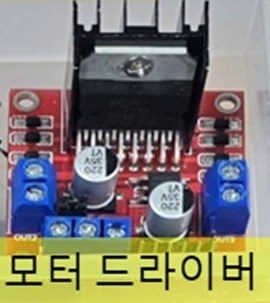
[picture p91: 3_조립설명서/img/kit_driver.jpg]
   파이  드라이버
  할 일 레일에 뒤에서 밀어 넣기
  이유 주행 중 안 빠지게
  볼트 없음
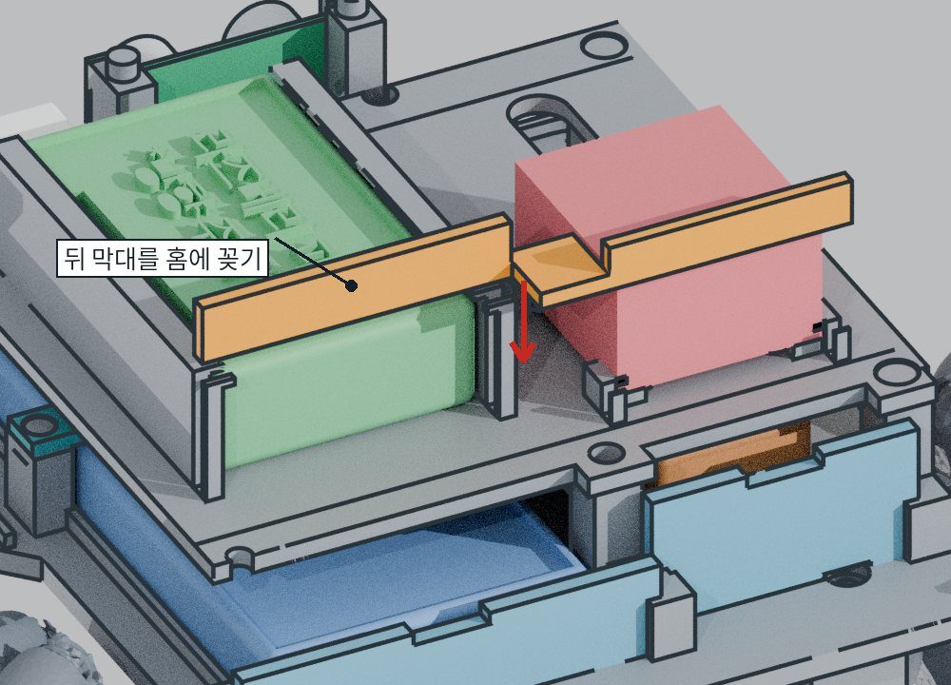
[picture p92: 3_조립설명서/img/s6_a11_key.jpg]
뒤 막대
13. 

### 뒤 막대

  할 일 보드 뒤 홈에 꽂기
  이유 보드 빠짐 방지
  볼트 없음

### 전선

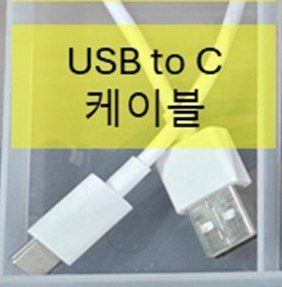
[picture p93: 3_조립설명서/img/kit_usbc.jpg]
14.  USB to C 케이블
  할 일 수업 연결도대로
  파이 보조배터리 바깥쪽 구멍 → 케이블 → 파이
  모터 리포 → 드라이버 → 모터
  신호 센서·드라이버 → 파이, GND끼리 연결
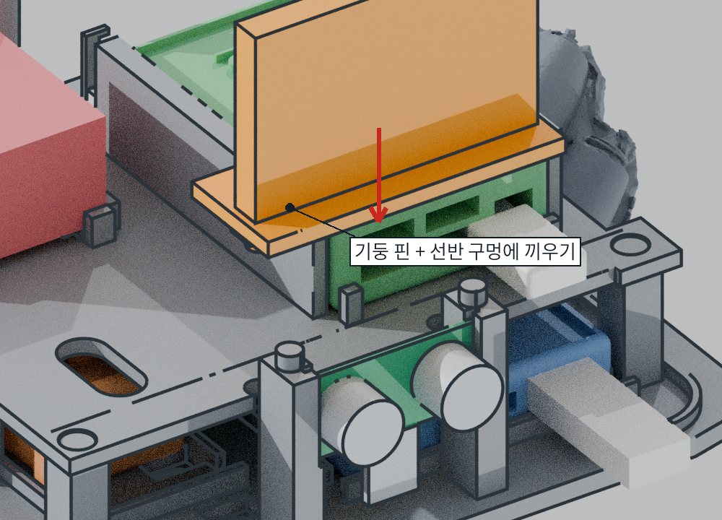
[picture p94: 3_조립설명서/img/s6_a12_deck.jpg]
카메라 받침
15. 

### 카메라 받침

  할 일 기둥 핀 + 선반 구멍에 끼우기
  이유 카메라 자리
  볼트 없음
16. 카메라

### 카메라

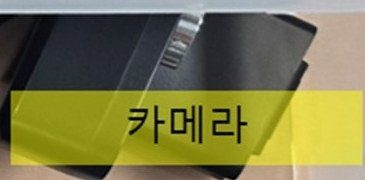
[picture p95: 3_조립설명서/img/kit_camera.jpg]
   카메라
  할 일 클립을 받침 위에 걸기. 뒤판은 받침 뒤에 기대기
  이유 모니터에 거는 것과 같음
  볼트 없음
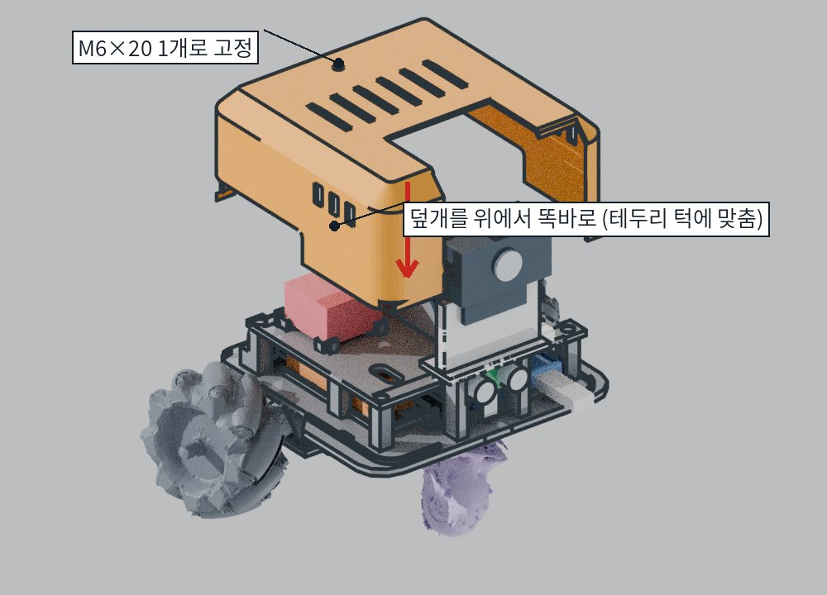
[picture p96: 3_조립설명서/img/s6_a14_cover.jpg]
덮개
17. 

### 덮개

  할 일 위에서 똑바로 (테두리 턱에). 뒤 왼쪽 구멍에 볼트
  이유 주행 중 안 들림
  볼트 M6×20 1개

## 4 충전

잠금판

1. 덮개 볼트 1개 풀고 들기
2. 잠금판 위로 뽑기
3. 배터리 뒤로 빼기
4. 리포: 보관팩 안에서 B6 충전기로 (3S, 2.2A 이하)
5. 보조배터리: 휴대폰 충전기로

## 5 주의

- 도로 폭: 차 폭 28.3cm, 도로 30cm. 한쪽 여유 8mm
- 처음엔 저속: 메카넘휠이라 회전 때 뒤가 미끄러짐
- 출발은 천천히: 0.3~0.5초에 걸쳐 속도 올리기
- 들 때는 바닥판을: 덮개·선반은 볼트 1개로만 잡혀 있음
- 카메라 흔들림: 주행 영상 확인

## 6 확인할 것

- 바퀴가 도로 선을 밟아도 되나 (선생님)
- 캐스터 구멍 간격 실측 (54×24mm 가정)
- 센서 원통 간격·지름 실측 (26·16mm 가정)
- 카메라 클립 위판 길이·뒤판 길이·폭 (사진으로 추정: 49 / 55 / 48mm)
- 카메라 클립 바닥에 나사 구멍 있나
- 슬라이서 출력 시간·필라멘트 양

구조 지도 (구멍·기둥마다 용도)

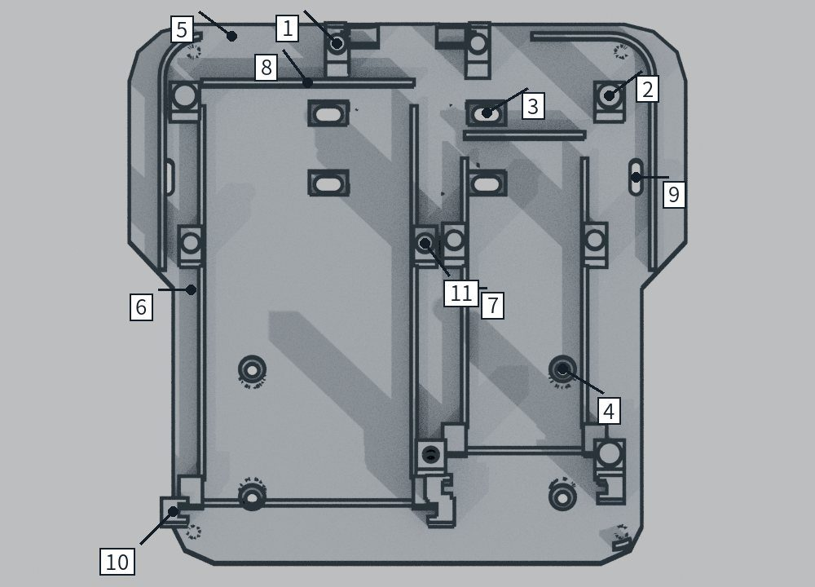
[picture p97: 3_조립설명서/img/s6_m_p01.jpg]
바닥판 구조 지도


P01 바닥판 (위가 차 앞)

1. 앞 기둥: 센서 홈 + 카메라 받침 핀
2. 선반 기둥 + 핀 (3곳)
3. 캐스터 긴 구멍 + M5 너트 홈
4. 모터 받침 볼트 구멍 (머리 홈)
5. 덮개 테두리 턱
6. 보조배터리 옆벽
7. 리포 옆벽
8. 배터리 앞 턱
9. 배선 구멍 (좌우)
10. 잠금판 홈 기둥
11. 가로대 핀 (4곳)

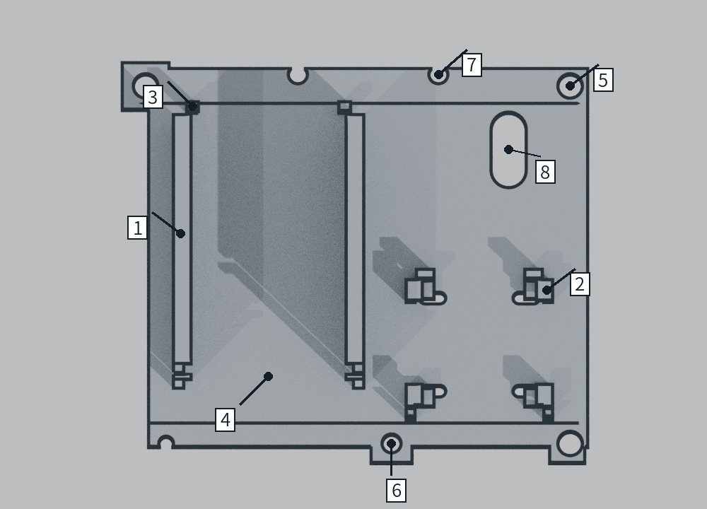
[picture p98: 3_조립설명서/img/s6_m_p02.jpg]
선반 구조 지도


P02 선반 (위가 차 앞)

1. 파이 레일 + 위 턱
2. 드라이버 모서리 턱
3. 앞 모서리 막이
4. 뒤 막대 홈
5. 기둥 핀 구멍 (3곳)
6. M6 볼트 구멍
7. 카메라 받침 핀 구멍
8. 배선 구멍

문제 기록 (발견 → 조치 → 결과)

버전 | 발견한 문제 | 조치 | 결과
v6.3 | 덮개가 얹기만 해서 주행 중 들릴 수 있음. 실제 웹캠 클립은 위판이 길고 뒤판이 비스듬히 내려옴(사진) | 기둥을 덮개 천장까지 올려 M6 1개로 덮개+선반 고정. 카메라 받침 뒤 틈 삭제, 덮개 천장 구멍 뒤로 넓힘 | 해결 간섭 0건, 볼트 풀면 들어 올림 걸림 0건
v6 | 키트에 볼트가 부족할 수 있음. 덮개 핀이 부러지기 쉬움. 부품이 많음 | 키트 볼트만 사용(출력물에 직접 나사). 덮개 핀 → 테두리 턱. 지지대·고정편 → 출력 기둥·레일. 모터 받침·하판 좌우 일체 | 해결 20개 → 10개
v5.3 | 배터리를 뺄 때마다 볼트 4개를 풀어야 함. 모터 볼트 머리가 배터리 밑에 깔림. 보조배터리가 덮개 뒤 다리에 걸림 | 잠금판을 홈에 꽂는 방식으로. 바닥판에 볼트 머리 홈. 덮개 다리 2mm 줄임 | 해결 빼는 길 간섭 0건
v5.2 | 작은 출력 부품이 너무 많음 (21개) | 가로대 2개를 1개로. 고정편 8개는 막대로 합치면 드라이버 단자·파이 핀을 덮고, 잠금판을 합치면 충전 때 볼트 4개를 풀어야 해서 유지 | 해결 20개
v5.2 | 선반 뒤쪽 지지대 구멍이 판 끝에서 1mm라 뒤가 트인 U자 홈이 됨. 선반이 뒤로 밀릴 수 있음 | 구멍 주변에 판을 덧대 막힌 구멍으로 | 해결
v5.2 | 예전 버전 흔적: 옛 센서 받침 턱·가이드, 옮기기 전 지지대 구멍 2곳, 가려진 케이블 타이 구멍, 옛 캐스터 구멍 끝 | 삭제하거나 메움. 남긴 구조는 모두 구조 지도에 용도를 적음 | 해결
v5.2 | 선반 아래 보강대 때문에 판 전체가 공중에 떠서 출력됨 (서포트 179cm²) | 보강대 제거. 실린 무게가 약 200g이라 4mm 판으로 충분 | 해결 서포트 2cm²
v5.2 | STL이 조립 방향이라 슬라이서에서 직접 돌려야 함 | 모든 부품을 출력 방향으로 돌려 다시 저장 | 해결
v5.2 | 캐스터 구멍 38×28mm가 추정값이었고 실제(스캔 54×24mm)와 다름. M5×10이 너트까지 닿지 않음 | 예전 구멍을 메우고 54×24mm 긴 구멍을 냄. 윗면에 M5 너트 홈(4mm) | 실측 필요 스캔 오차 ±1.5mm
v5.1 | 보조배터리 USB-A 앞에서 덮개 벽까지 약 2cm라 파이 전원 플러그가 안 들어감 | 덮개 앞 왼쪽에 바닥부터 트인 창 | 해결 플러그 간섭 0건
v5.0 | 덮개 출력이 어려움(서포트 131cm²), 충전할 때 불편, 차 모양이 안 남 | 지붕이 평평한 들어 올림 덮개로 교체. 핀 4개, 볼트 없음 | 해결 서포트 8cm², 들어 올림 간섭 0건
v5.0 | v4.3 덮개의 센서 홈이 위로 트여 있어, 덮개를 위아래로 움직이면 센서에 걸림 | 앞면 가운데를 아래부터 위까지 트임 | 해결
v4.3 | 센서 기판이 덮개 앞벽 안에 묻혀 있음 | 앞 기둥에 센서 홈, 덮개에 센서 자리. 카메라 받침 6mm 올림 | 해결 송수신 경로 막힘 없음
v4.3 | 센서 핀 방향이 불확실 | 지급 부품 사진으로 확인 | 확인 긴 모서리에서 곧게 나옴
