shinhan7n2-spec/autonomous-car/5_과거기록/2026-10-29/04_통합_v4/20261029_camera_clip_v4_1_A/20261029_카메라클립_조립안내_v4.1_A.html

# 카메라 클립 받침 v4.1

2026-10-29 / A · 기존 v4.0 보존 · 수업 STL 원본 크기 유지

클립 치수와 힌지 위치를 추정하여 수정한 설계입니다. 실제 카메라 끼움·고정력·접이 동작은 검증하지 않았습니다. 아래 STL 3개는 변경 부품만이며 자동차 전체 출력 세트가 아닙니다.

## 고정 구조

검은 부분은 카메라와 기존 접이식 클립의 추정 형상입니다. 청색 세로 받침을 모니터 윗부분처럼 걸치고, 뒤쪽 청색 누름판을 지급 공용 세트의 M3×20 볼트 2개와 M3 너트 2개로 조이는 구조입니다. 테이프·접착제·새 구매 부품을 사용하지 않습니다. 제공 M6 볼트를 카메라의 확인되지 않은 나사 구멍에 넣는 방식도 사용하지 않습니다.

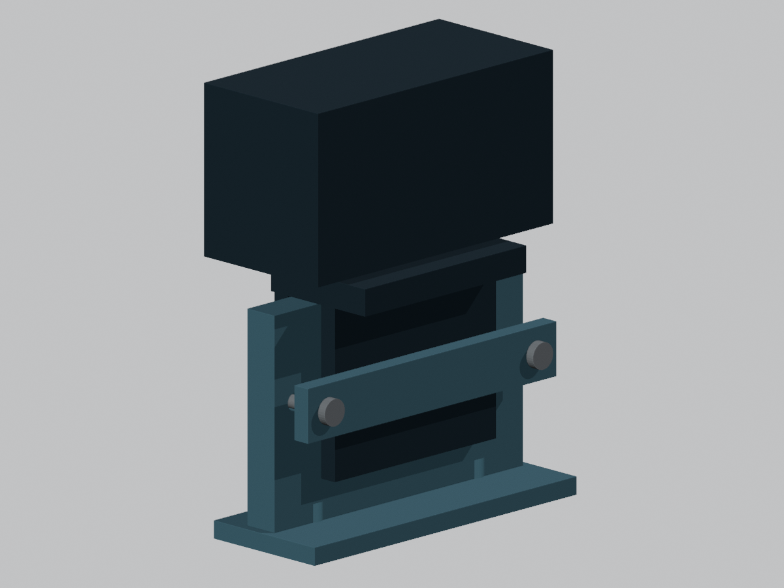
[picture p101: 5_과거기록/2026-10-29/04_통합_v4/20261029_camera_clip_v4_1_A/clip_rear.png]
뒤에서 본 클립 받침과 누름판


뒤쪽 누름판의 양 끝 볼트는 카메라 클립 바깥쪽을 지나 받침의 너트와 결합합니다. 렌더의 금속 막대는 나사산을 생략한 볼트 표시입니다.

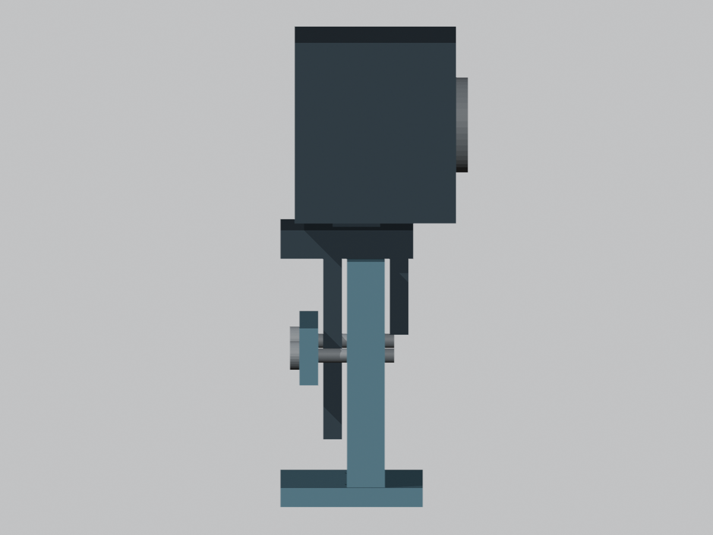
[picture p102: 5_과거기록/2026-10-29/04_통합_v4/20261029_camera_clip_v4_1_A/clip_side.png]
측면에서 본 앞 걸림턱과 뒤 접이판


앞 걸림턱과 뒤 접이판 사이에 세로 받침이 들어갑니다. 렌더에는 조이기 전 추정 여유 1mm가 있습니다. 조립 시 누름판을 좌우 균등하게 조여 뒤 접이판을 받침 쪽으로 잡습니다. 실제 힌지 구조가 이 움직임을 허용하는지는 확인이 필요합니다.

## 조립 순서

1. 누름판을 분리한 상태에서 출력 받침을 기존 카메라 지지 기둥 위에 장착합니다. 기존 받침의 두 체결 위치를 유지했습니다.
2. 세로판 앞쪽에 카메라의 앞 걸림턱을 걸치고 뒤 접이판을 뒤로 내려 놓습니다.
3. 받침 앞쪽 너트 홈에 M3 너트를 넣습니다. 뒤에서 누름판과 M3×20 볼트 2개를 장착합니다.
4. 좌우를 조금씩 조여 빠짐을 막습니다. 카메라 힌지나 플라스틱이 휘도록 과도하게 조이지 않습니다.
5. 렌즈 방향과 케이블을 확인한 후 덮개를 장착합니다. 덮개에는 클립과 누름판 접근을 위한 개구를 넓혔습니다.

## 치수·검사 범위

- 세로 받침 두께 8mm. 뒤 접이판 가정 48×4×36mm. 카메라 본체 가정 70×34×38mm.
- 덮개 작업 공간 82×38×70mm 기준으로 절개. 위로 카메라를 빼낼 수 있도록 개방.
- 변경 받침·누름판·덮개: 닫힌 메시, 각각 연결체 1개 검사. 카메라 및 받침과 덮개·선반·라즈베리파이의 표면교차 검사 수행.
- 수업 STL 파일 해시와 참고 객체의 전체 정점 해시·배율1 보존 확인.
- 실물 힌지 동작, 흔들림, 고정력, 케이블 굽힘, 출력 경로 검사는 미수행. 실제 지급 M3 부품 수량도 확인 필요.

## 출력 방향 후보

받침은 세로판의 넓은 면이 베드에 놓이도록 회전해 내보냈습니다. 누름판은 넓은 면을 아래로 놓으면 됩니다. 덮개는 기존 지붕 아래 방향입니다. 출력 전 슬라이서에서 너트 홈과 절개 주변의 지지대 필요 여부를 확인해야 합니다. 실제 장비 재료가 확인되지 않아 G-code는 제공하지 않았습니다.

## 전체 조립 모습

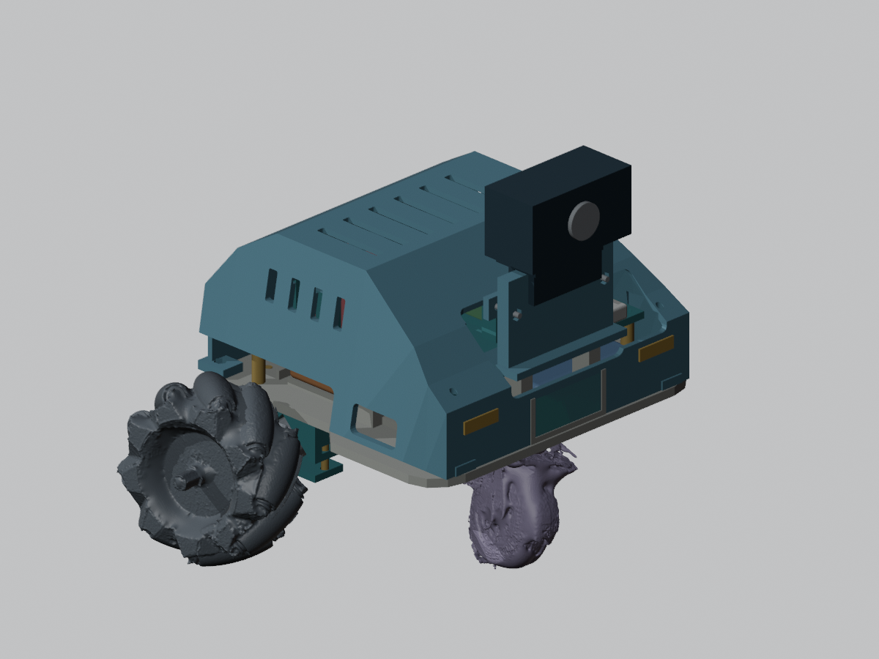
[picture p103: 5_과거기록/2026-10-29/04_통합_v4/20261029_camera_clip_v4_1_A/assembly.png]
클립 받침이 반영된 전체 자동차


카메라가 앞선 프리뷰보다 높아졌습니다. 이는 뒤 접이판이 선반과 닿지 않도록 확보한 추정 배치이며 실물 높이에 따라 낮출 수 있습니다.
