shinhan7n2-spec/autonomous-car/5_과거기록/2026-10-29/03_조립_v3/20261029_assembly_v3_3_A/motor_assembled.png

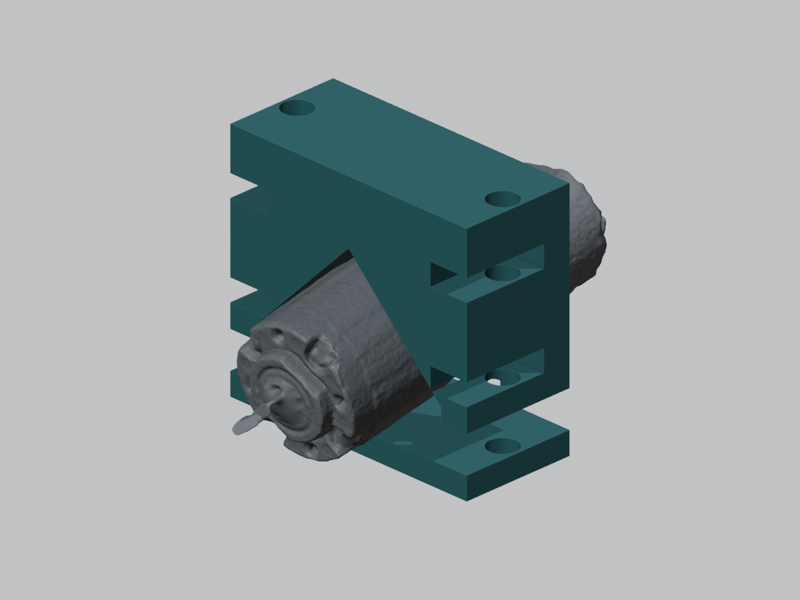
5_과거기록/2026-10-29/03_조립_v3/20261029_assembly_v3_3_A/motor_assembled.png
