shinhan7n2-spec/autonomous-car/5_과거기록/2026-10-29/03_조립_v3/20261029_cover_preview_v3_4_A/cover_side.png

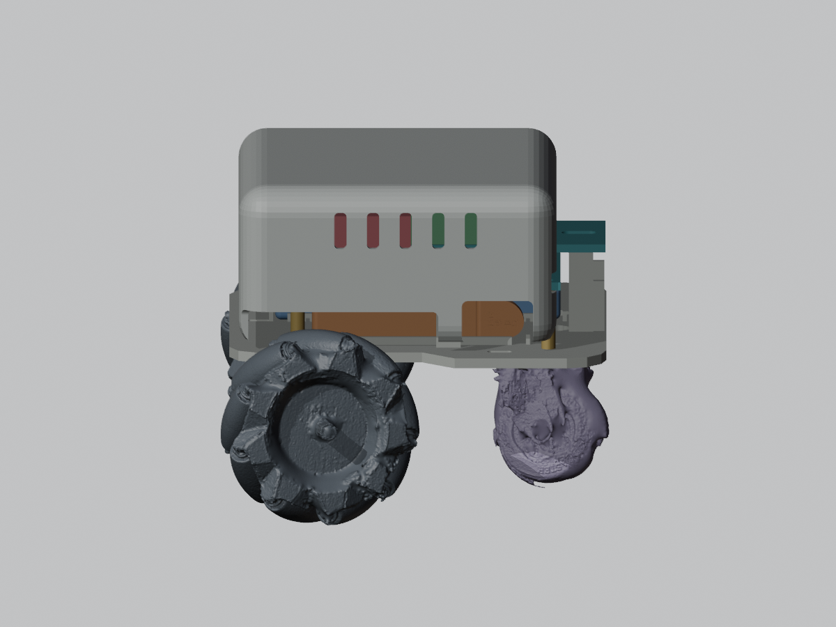
5_과거기록/2026-10-29/03_조립_v3/20261029_cover_preview_v3_4_A/cover_side.png
