shinhan7n2-spec/autonomous-car/5_과거기록/AI_WORK_LOG.md

# AI 활용 기록

## 기록 방법

- 목적은 AI가 도운 부분, 사람이 판단한 부분, 검증 근거를 발표·보고서에서 설명할 수 있도록 남기는 것이다.
- 의미 있는 작업·결정 단위로 기록한다. 전체 대화나 비밀정보를 복사하지 않는다.
- 현재 기기는 사용자 확인에 따라 A이다. 설치·설정 변경 또는 동기화에 필요한 때만 기기를 확인한다. 일반 작업은 마지막으로 확인된 기기를 유지하며 반복 질문하지 않는다. 경로로 기기를 추정하지 않는다.
- 아래 과거 기록은 이 채팅에서 확인되는 내용만 소급 정리했다. 2026-10-29 사용자가 과거 미확인 기록도 A로 기록하도록 명시하여 LOG-001~005를 A로 정정했다. 불확실한 날짜는 임의로 채우지 않았다.
- 이후 기기가 확인되면 해당 기록에 확인 근거를 덧붙인다. 근거 없이 기존 기록을 다른 기기로 옮기지 않는다.

## A 기기 작업

### LOG-001 — 기존 프로젝트 확인

- 날짜: 2026-10-28 (대화 날짜 기준)
- 기기: A (2026-10-29 사용자 명시 확인으로 정정)
- 목적: 기존 작업을 보존하며 연결 폴더와 지침·상태 문서 유무를 확인한다.
- 도구·요청: Codex의 파일 읽기 및 Git 조회. 사용자 요청은 읽기 전용 확인이었다.
- AI의 기여: 연결 경로, README, 지침 유무, Git 상태와 초기 커밋을 확인했다.
- 사용자 판단: 처음부터 새로 만들지 말고 목표와 진행 상황부터 질문하도록 요청했다. 이후 아직 정해진 것이 없다고 설명했다.
- 결과·검증: README.md와 .gitattributes 및 .git 확인. 당시 로컬 변경 없음. 원격 실시간 확인은 하지 않았다.
- 근거: 이 채팅의 명령 실행 결과. 파일 변경 없음.

### LOG-002 — 수업 자료 검토와 범위 파악

- 날짜: 2026-10-28~2026-10-29 (대화 날짜 범위)
- 기기: A (2026-10-29 사용자 명시 확인으로 정정)
- 목적: 수업 목표, 자동차 구성과 모델링 과제를 파악한다.
- 도구·요청: Codex로 사용자가 첨부한 수업 슬라이드 이미지와 과제 설명을 읽었다.
- AI의 기여: 수업 진행 순서, 부품 구성, 모델링·출력 과제를 요약했다. 예시 치수와 필수 조건을 구분했다.
- 사용자 판단: Blender를 사용한다고 결정하고, 이 채팅은 기획용이며 설치·모델링과 분리해야 한다고 명확히 했다.
- 결과·검증: PROJECT_STATUS.md에 자료 기반 요구사항 정리. 실제 부품, STL, XLSX, 배선과 출력 가능성은 검증하지 않았다.
- 근거: 이 채팅에 첨부된 수업 일정, 구성도, 부품 표, 도로·자동차 규격 예시와 연결도 이미지 및 사용자 설명.

### LOG-003 — 채팅 구성과 임시 지침 결정

- 날짜: 2026-10-29 (대화 날짜 기준)
- 기기: A (2026-10-29 사용자 명시 확인으로 정정)
- 목적: 기획·설치·모델링 작업을 구분하고 협업 규칙을 정한다.
- 도구·요청: Codex의 대화와 채팅 이름 변경 도구.
- AI의 기여: 세 채팅 역할, 인수인계 방식, 지침 초안을 제안하고 현재 채팅 이름을 변경했다.
- 사용자 판단: 세 채팅 구성과 역할 구분에 동의했다. 미확인 값을 임시로 정하는 대신 다시 질문하도록 수정했다. 지침은 작업하면서 고치는 초안으로 두고, 채팅 간 전달 규칙에도 동의했다.
- 결과·검증: 현재 채팅 이름은 `자율주행 자동차 · 기획`으로 도구에서 변경 확인. 나머지 채팅은 생성하지 않았다. 추가 모델링 규칙은 제안 상태이다.
- 근거: 사용자 답변과 채팅 이름 변경 도구의 성공 결과.

### LOG-004 — 프로젝트 문서와 AI 활용 기록 도입

- 날짜: 2026-10-29 (한국 표준시, 정확한 시각 미기록)
- 기기: A (2026-10-29 사용자 명시 확인으로 정정)
- 목적: 대화의 합의·제안·진행 상태를 보존하고 AI 활용 과정을 설명할 근거를 남긴다.
- 도구·요청: Codex의 파일 읽기, Git 상태 조회 및 문서 작성 도구. 사용자가 세 문서 생성과 향후 지속 기록을 요청했다.
- AI의 기여: AGENTS.md, PROJECT_STATUS.md, AI_WORK_LOG.md의 역할과 기록 형식을 제안하고, 현재 채팅의 이력을 정리했다.
- 사용자 판단: 세 문서 생성에 동의하고 A/B 기기 구분을 요청했다. 다만 기기를 확실히 나누기 어렵다고 설명했다.
- 당시에는 기기 미확인으로 기록했다. 이후 2026-10-29 사용자가 현재와 과거 미확인 기록을 A로 기록하도록 명시하여 정정했다.
- 결과·검증: 세 문서를 생성하고 UTF-8로 다시 읽어 저장 내용을 확인했다. Git 변경 목록에는 새 문서 세 개만 표시됐다. 기존 파일 변경은 없다.
- 전달 상태: 로컬 저장 완료. commit·push 및 다른 기기 전달은 수행하지 않았다.
- 근거: 현재 채팅의 사용자 요청, 작성 전 파일 목록과 Git 조회 결과. 설치·모델링·commit·push는 수행하지 않았다.

### LOG-005 — 이미지 보존과 담당 채팅 인수인계

- 날짜: 2026-10-29 (한국 표준시)
- 기기: A (2026-10-29 사용자 명시 확인으로 정정)
- 목적: 모델링을 이어갈 채팅을 준비하고 임시 첨부 이미지가 사라져도 수업 자료를 참고할 수 있도록 보존한다.
- 도구·요청: 사용자가 두 채팅 생성, 지침·진행 내용 전달, 업로드 이미지 저장을 요청했다. 파일 복사·해시 확인, 채팅 생성 도구를 사용했다.
- AI의 기여: 첨부 이미지 9개를 references/class-slides에 원본 이름으로 복사하고 자료 목록을 작성했다. 두 채팅을 같은 로컬 프로젝트로 생성해 공통 문서·이미지 경로·합의와 제안·미확인 사항을 시작 메시지에 포함했다.
- 사용자 판단: 모델링부터 시작하고 싶다는 우선순위를 정하고 현재까지의 자료를 먼저 보존하도록 요청했다.
- 결과·검증: 이미지 9개 모두 원본과 SHA-256 일치. 두 채팅 생성 도구에서 각각 threadId와 local host 반환을 확인했다. 설치·모델링은 이 기획 작업에서 수행하지 않았다.
- 지침 명확화: 공통 AGENTS.md의 '현재 채팅' 표현을 기획 채팅 이름으로 바꾸어 새 담당 채팅에서도 역할이 혼동되지 않게 했다.
- 한계: 부품 STL·XLSX·실측값과 출력 환경은 아직 없다. 채팅 대화 전체와 다른 PC 파일은 자동 동기화를 전제하지 않는다.
- 전달 상태: 같은 로컬 프로젝트의 두 채팅에 문서 경로와 인수인계 메시지를 전달했다. 원격 push 및 다른 PC 전달은 수행하지 않았다.
- 인수인계 확인: 두 채팅 모두 초기 응답을 완료하고 문서 4개를 읽었다고 보고했다. 모델링 채팅은 단층·다층·연결도 이미지도 확인하고 부품 XLSX/STL 보유 여부를 질문했다. 설치 채팅은 기기 구분을 질문했다. 양쪽 모두 초기 응답에서 공통 문서를 수정하지 않았다고 보고했다.

### LOG-006 — 기기 A 확인과 기기 질문 기준 수정

- 날짜: 2026-10-29 (한국 표준시)
- 기기: A (사용자 명시 확인)
- 목적: 불필요한 기기 질문을 줄이고 기존 기록을 사용자 확인에 맞춘다.
- 사용자 판단·요청: 현재 기기와 과거 미확인 기록을 A로 지정하고, 기기 구분은 설치나 동기화할 때만 확인하도록 요청했다.
- AI의 기여: 공통 지침, 상태 문서, LOG-001~005의 기기 표기와 자료 목록을 수정하고 정정 근거를 남겼다.
- 검증: 저장 후 관련 문구를 조회하여 LOG-001~005 모두 A로 정정되고 새 LOG-006 및 기기 확인 지침이 반영된 것을 확인했다.
- 전달 상태: 로컬 문서에 반영. commit·push와 다른 PC 전달은 수행하지 않았다.

### LOG-007 — 체결 부품 자료와 기존 모델 활용 방향 검토

- 날짜: 2026-10-29 (한국 표준시)
- 기기: A (최신 공통 문서의 사용자 확인 기록 기준)
- 사용자 제공·판단: 접시머리 십자 볼트·너트·와셔 공용 세트 이미지를 제공하고 기존 모델을 찾아 응용하는 방향을 제안했다.
- AI의 기여: 자료에 표시된 체결 종류를 확인하고, 부품 배치용 모델과 출력할 몸체·고정 구조의 활용 목적을 구분했다.
- 결과·한계: 부품별 체결 규격, 실물 수령, 기존 모델 호환성과 출력 적합성은 미확인. 외부 모델 검색·다운로드·Blender 모델링은 수행하지 않았다.
- 근거: 이 모델링 채팅의 첨부 이미지 codex-clipboard-6a38c51d-38ea-45e0-9d1b-75fc5e597bbc.png. 이미지는 현재 임시 경로에 있으며 프로젝트로 복사하지 않았다.
- 전달 상태: 공통 상태·AI 기록에 로컬 저장. commit·push는 수행하지 않았다.

### LOG-008 — 부품 원본 확보와 STL 목록 분석 (기기 A)

- 날짜: 2026-10-29 (한국 표준시). 최신 공통 문서의 기기 A 확인을 유지.
- 사용자 제공: 부품리스트_학생용.xlsx, 부품스캔파일(stl).zip, 자율주행_팀_물품사진_공지용.jpg.
- AI 기여: 원본 3개를 references/parts에 복사하고 각각 SHA-256 일치를 확인. XLSX Sheet3의 부품 항목 24개와 체결 표를 읽음. ZIP의 부품 STL 6개를 추출하고 바이너리 크기·삼각형 수·축별 좌표 범위를 계산해 stl_inventory.json에 기록.
- 사용자 판단: 이번 파일이 기존 PPT 일부 이미지와 구분되는 요청 원본 자료라고 설명함. 배치·외형·층 구성의 새 결정은 아직 없음.
- 검증·한계: 6개 모두 바이너리 STL의 파일 길이와 삼각형 수 일치. STL 단위와 실물 일치, 형상 시각 검토, 구멍 위치, 조립 및 출력 가능성은 미검증. 제품 링크의 실시간 내용은 확인하지 않음. 원본 수정·설치·Blender 모델 생성은 없음.
- 근거: references/parts/README.md, stl_inventory.json 및 보존 원본.
- 전달 상태: 로컬 저장. commit·push·다른 PC 전달은 수행하지 않음.

### LOG-009 — 기존 몸체 모델 후보 조사

- 날짜·기기: 2026-10-29 (한국 표준시), A.
- 사용자 판단·요청: 디자인은 미정이며 첫 출력의 안정성과 덜 각진 외형을 원함. 현재 부품에 응용할 기존 모델 몇 개를 찾아 보여 달라고 요청.
- AI 기여: 웹에서 제작자 설명을 조사해 Flexible chassis, PenguinTutor V2, PROBE LX-3를 비교하고 현재 부품과의 차이 및 수정 범위를 설명함.
- 검증·한계: 제작자 페이지와 배포 링크 확인. 일부 이미지와 Printables 본문은 도구로 로드되지 않음. 외부 모델 파일 다운로드·실물 적합·출력 성공 검증은 없음. 단순한 분리 구조에 둥근 외형을 적용하는 방향은 AI 제안이며 사용자 확정은 아님.
- 근거: references/parts/model_candidates.md의 제작자 URL과 조사 기록.
- 전달 상태: 로컬 문서 저장. commit·push 없음.

### LOG-010 — 자율주행용 바퀴 구조와 후보 재평가

- 날짜·기기: 2026-10-29 (한국 표준시), A.
- 사용자 요청·보고: 세 후보의 자율주행 적합성과 더 나은 방향을 검토하도록 요청. Blender는 설치되어 있다고 보고.
- AI 기여: 제작자 문서·차동구동 교재·캐스터 방향 오차 연구를 확인해 일반 구동륜과 메카넘 2륜의 차이를 설명. 낮고 둥근 맞춤 바닥판과 교체형 고정대 방향을 제안.
- 근거: https://msl.cs.illinois.edu/~lavalle/planning/node659.html , https://doi.org/10.1016/j.ifacol.2023.10.394 , references/parts/model_candidates.md의 제작자 문서.
- 검증·한계: 웹 문헌 검토이며 실물 주행·조립·무게중심·Blender 실행은 미검증. 캐스터 앞뒤와 휠 배치는 미확정. 사용자 디자인 선택도 미확정.
- 전달 상태: 로컬 상태·AI 기록 저장. commit·push 없음.

### LOG-011 — 둥근 몸체와 부품 배치 개념 초안

- 날짜·기기: 2026-10-29 (한국 표준시), A.
- 사용자 요청·판단: 출력은 설계 완료 후 대여 신청·방문으로 진행한다고 설명. 프린터 정보는 나중에 확인하고 현재 자료로 배치와 둥근 몸체 구조를 먼저 검토하도록 요청.
- AI 기여: 제공 부품 목록·STL 좌표 범위와 기존 조건을 바탕으로 후방 구동륜+전방 캐스터, 하부 배터리, 상부 작은 보드 선반을 A안으로 제안. 둥근 앞뒤와 평평한 바닥을 구분한 Markdown 초안 및 축척 없는 SVG 배치 개념도 작성.
- 검증·한계: 파일 저장과 SVG XML 구조 확인. 실제 축척·실물 일치·간섭·무게중심·조립·출력은 미검증. 미확인 치수를 지정하거나 Blender/STL을 생성하지 않았다. 레이아웃은 사용자 미확정 제안.
- 근거 파일: 프로젝트 루트의 20261029_자율주행자동차_배치구조초안_v1.0_A.md 및 20261029_자율주행자동차_배치개념도_v1.0_A.svg.
- 전달 상태: 로컬 저장. commit·push 없음.

### LOG-012 — 제품명·링크로 누락 규격 직접 확인

- 날짜·기기: 2026-10-29 (한국 표준시), A.
- 사용자 요청: 미확인이라고 남기기 전에 제품 자료를 직접 찾고, 없는 정보는 질문하도록 지적.
- AI 기여: XLSX 링크의 원래 판매처 상세와 ABKO 공식 자료를 웹으로 확인. 드라이버 43×43×27mm, 센서 45×21mm 및 정확한 HY-SRF05 5핀 모델 확인. 카메라 공식 화각·회전 사양 확인. 결과를 product_dimensions.md와 상태에 기록.
- 한계: 카메라 외형/고정부와 각 부품 장착 구멍의 정확한 치수는 아직 확보 못함. 판매처 상세 이미지 전체를 검토했다고 주장하지 않음. 임의 치수 모델링 없음.
- 전달 상태: 로컬 저장. commit·push 없음.

### LOG-013 — Blender 부품 배치와 6면도·층별 프리뷰

- 날짜·기기: 2026-10-29 (한국 표준시), A.
- 사용자 요청·판단: 확인 규격과 제공 STL로 6면도·층별 프리뷰 및 실측 항목 정리 요청. 추가 수업 이미지 7장을 제공하고 Blender 창에서 직접 보고 판단하고 싶다고 요청.
- AI 기여: 설치 Blender 5.0.1 확인, STL 6종 로드·모터/휠 복제 배치, 드라이버 규격 상자와 센서 기판면 표시. 휠96mm·캐스터62mm를 기준으로 스캔에 균일 참고 배율 적용하고 차이를 기록. 카메라 치수는 만들지 않음. 뷰 방향과 부품 간 대략적 배치를 수정한 뒤 10개 렌더와 합성 PNG 2개 생성. 초기 사선 시점을 저장한 .blend를 GUI로 실행.
- 검증: 합성 6면도·층별 이미지 직접 확인. .blend를 재로드하고 저장 성공. 새 첨부 이미지 7장 프로젝트 복사 및 원본 SHA-256 일치. GUI 실행 PID 반환 확인. 실물/원본 스캔 차이, 좌우 휠 방향, 축·체결·간섭·강도·출력·주행은 미검증.
- 근거: models/layout-preview-v1의 .blend, outputs/20261029_layout_v1_A의 PNG·README·placement_notes.json. 생성 스크립트는 같은 모델 폴더에 보존.
- 전달 상태: 로컬 저장. commit·push 없음. 화면에서 사용자 판단은 아직 받지 않음.

### LOG-014 — 둥근 몸체·선반·고정대와 조립 프리뷰

- 날짜·기기: 2026-10-29 / A.
- 사용자 요청: 부품만 떠 있는 상태에서 둥근 몸체·선반·고정대까지 만들고 Blender와 조립 프리뷰로 확인 요청. 도중 Astra로 모델을 전환했다고 알림.
- AI 기여: 기존 v1을 별도 v2로 확장. 둥근 바닥판, 모터 분할 받침, 캐스터 보강판, 배터리/드라이버 받침, 30mm 지지대 위 선반, 보드 측면 받침, 전방 센서·카메라 받침을 생성. 조립 상태·분해도·층별·6면도 총 11개 렌더와 합성 프리뷰 2개 저장.
- 검증: 조립 사선 및 분해 렌더, 합성 조립 프리뷰 직접 확인. .blend 저장과 GUI 실행 PID 26832 확인. 사용자 형상 승인은 아직 받지 않음.
- 한계: 형상 검토용 제안이며 실제 출력용 아님. 체결 구멍/나사산/정밀 공차/배선/스트랩 미완성, 카메라 본체 미포함. 볼트는 설명 기호. 실물 조립·강도·주행·출력 미검증.
- 근거: models/structure-preview-v2 및 outputs/20261029_structure_v2_A. 기존 v1과 원본 자료 보존.
- 전달: 로컬 저장, commit·push 없음.

## B 기기 작업

아직 B로 확인된 작업 기록이 없다.

## 이후 기록 양식

### LOG-번호 — 작업명

- 날짜·시각: 한국 표준시 기준. 확인되지 않은 시각은 추정하지 않는다.
- 기기: A / B / 미확인 및 확인 근거
- 목적:
- 도구·핵심 요청:
- AI의 기여:
- 사용자의 판단·직접 수행:
- 결과·검증 및 남은 한계:
- 근거 파일·화면·측정 결과:
- 전달 상태: 로컬 저장 / commit / push / 다른 기기 확인 중 실제 확인한 단계만 기록

### LOG-015 — 원본 STL 배율 복원
- 2026-10-29 / A. 사용자 지시로 참고 배율 조절을 중단하고 휠·캐스터를 원본 배율로 복원했다. 나머지 참고 STL 객체도 배율 1 확인.
- v2와 원본 STL은 보존. v3 원본배율검토 .blend 및 scale_restoration.json 저장. 위치·회전은 유지하여 간섭 검토 시작점으로 사용한다.
- 조립 개선·출력용 설계는 아직 완료하지 않았으며, 배율 복원으로 높이 관계를 재검토해야 한다. commit·push 없음.

### LOG-016 — v3 한장 배치와 고려사항 정리
- 2026-10-29 / A. 한장190×185mm 배치와 분할안을 비교하여 접합부 없는 한장안을 선택. 배율1 유지, 모터/휠/캐스터 위치, 체결구멍, 배선통로, 배터리 가로대 모델링. v3.1과v3.2 별도 저장.
- 전체 참고 정점 해시 비교 통과(v3.1), 새 구조물 비다양체 모서리0 확인. 출력 성공·간섭 전체 검증은 아님.
- 검토용 STL9개를 REVIEW 폴더에 생성. 사용자는 확정본을 요청했으므로 최종 출력 파일로 제공하지 않음.
- 사용자 승인: 추정값 기록, 벨크로 대신 출력 가로대, U자 모터받침＋평판. 모터받침 변경은 착수 중.
- DESIGN_CHECKLIST.md에 완료/추정/미완료 정리. 진행 문서 업데이트 지연을 바로잡음. 로컬 저장, commit/push 없음.

### LOG-017 — U자 모터 받침과 조립 자료
- 2026-10-29 / A. U자 V홈 받침+평판으로 수정. 너트 슬롯이 받침을 분리하지 않도록 후면 벽을 남기고 연결체 검증.
- STL9개 생성, 원본 참고 객체 정점해시 유지. 조립/모터 렌더 확인. 설명서HTML·금속부품 예상표·출력방향·미완료 목록·ZIP 작성, STL구조와ZIP 무결성 검사. HTML 시각 렌더검사는 미수행.
- 사용자 선택PLA, 실제 장비카트리지 미확인. 최종출력승인·슬라이싱·G-code·실물조립은 미완료. 모델 GUI실행/창제목 확인. 로컬저장, commit/push 없음.

### LOG-018 — 둥근 덮개 외형 프리뷰
- 2026-10-29 / A. 수업 원본을 수정하지 말라는 사용자 지시 유지. 둥근 덮개, 전방 개구, 통풍구, 휠/선반 여유 형상 추가. v3.4 별도파일저장.
- 원본파일6개 및 참고메시8개 해시 일치. 렌더4개·합성프리뷰 시각확인. BlenderGUI 창제목 확인.
- 덮개 체결·실제카메라·전체간섭·출력방향과서포트 미검증. 출력용으로제공하지않음. 로컬저장, commit/push 없음.

### LOG-019 — 랜카드 추정 반영 및 통합 덮개 검사
- 2026-10-29 / A. 사용자 검색·추정 검사 승인에 따라 A1000mini 제품자료 검색, 내장 안테나형 참고 형상 추가. 치수24.6×16×8mm는 확인된 실측값으로 표시하지 않음. 신규 팬·테이프·안테나 추가 없음.
- v4 통합 모델/렌더/STL19개 작성. 덮개 형상 오류를 표면교차 검사로 발견, 면 방향·삼각화 및 고정부 여유 수정. 원본 STL 해시·참고메시 해시/배율 유지 확인. 검사 보고서 별도 저장.
- 사용자가 재제공한 카메라 사진을 보고 기존 프리뷰의 뒤 클립 누락을 인정. 카메라가 현재 모델대로 고정된다는 보장은 철회하며, 모니터 걸침 받침과 클립 공간 재설계 대상으로 기록. 센서 체결/슬라이싱/G-code/실물시험은 미완료. 과거 버전 보존, commit/push 없음.

### LOG-020 — 카메라 클립 받침 수정 및 지침 기록
- 2026-10-29 / A. 사용자 요청에 따라 세로 받침/뒤 누름판/M3 체결과 덮개 작업 공간을 모델링하고 v4.1로 별도 저장. 카메라 앞 걸림턱·뒤 접이판·힌지를 추정 형상으로 표현.
- 원본 STL/참고 메시 보존 확인. 변경 출력물3개의 닫힘/연결성 및 지정 부품과 표면 겹침 검사. 렌더 시각검토 후 잘린 측면 구도를 수정. HTML 조립안내 작성.
- 테이프·접착제·추가 구매 부품 금지, 지급 부품과 출력물 사용 규칙을 AGENTS.md에 사용자 승인 범위로 추가. 실물 고정 및 출력 성공을 검증한 것은 아님. commit/push 없음.

### LOG-021 — 배터리 충전 접근을 위한 탈착 구조
- 2026-10-29 / A. 사용자 진행 승인으로 후방 탈착 통로, 개별 잠금판2개, 지급 M3체결, 열린 배선 홈 설계. 덮개/선반 분해 없이 빼는 방식. 원본 STL과 참고메시 형상/배율 보존.
- 단순 외관 대신 이동 공간과 구조물의 교차 부피를 검사해 보조배터리/지지대 겹침을 발견, 앞/뒤 지지대 이동 및 선반 보강. 변경출력물5개 닫힘/연결체1 확인. 렌더2개 시각 확인, 조립/탈착 안내HTML 작성.
- 모델의 정적 직선 탈착 검사만 수행. 실제 커넥터/전선/고정력/충전회로/충전기/열/슬라이싱은 검증하지 않음. 수업 보관팩 사용 조건을 안내에 반영. 기존버전 보존, commit/push 없음.

### LOG-022 — GitHub 업로드 준비
- 2026-10-29 / A. 사용자 승인 후 .gitignore와 LFS 파일 규칙, 저장소 README 작성. 이 프로젝트에만 LFS 초기화, 제작파일/자료/기록 등록. 임시파일과 자동 백업은 로컬 보존하며 제외.
- 원격 조회 과정에서 GitHub 인증창 발생, 사용자에게 브라우저 로그인 안내. 비밀번호/인증코드는 요청하거나 취급하지 않음. 이 기록 시점에 원격 업로드 미완료.

### LOG-023 — GitHub 전달 완료 확인
- 2026-10-29 / A. 사용자 직접 인증 후 제작 커밋86c6d62와 LFS 업로드. GitHub 서버 일시 저장 오류 후 동일 커밋 재전송 성공. 원격 main SHA와 로컬 HEAD 일치 확인. 모델 생성/렌더 재실행 없음.

### LOG-024 — 센서 고정 v4.3 (Claude로 작업 이어받음)
- 2026-10-29 / A. 사용자가 GPT 작업을 Claude에서 이어서 진행하도록 요청. 프로젝트 문서와 v4.2 모델을 검사하다가 HY-SRF05 기판 면(y91)이 덮개 앞벽(y88~92) 안에 묻혀 있는 것을 발견함.
- 바닥판 기존 앞 기둥(x±24)에 기판 홈과 송수신기 여유를 내고 위에서 밀어 넣는 방식으로 변경. 덮개 앞벽에는 위가 트인 홈을 냄. 카메라 받침을 6mm 올리고 기둥 끝의 위치 핀과 선반 M3×20 2개로 고정함. 예전 P12 고정띠는 삭제함.
- 가정: 학교용 표준형 센서(핀이 아래로 곧게 나옴), 원통 간격 26mm·지름 16mm·길이 12mm, 기판 두께 1.6mm. 사용자 실측은 아직 하지 않음.
- 검사: 수정 부품 4개 모두 비다양체 모서리 0·연결체 1. v4.2 대비 새로 생긴 간섭 0건. 송수신기 앞쪽 경로 막힘 없음. 원본 참고 메시 해시 보존. 렌더 2장 확인.
- 출력 방향을 1차로 계산함(print_orientation_check.json). 슬라이서 검사는 하지 않음. .blend(151MB)는 전송 한도 때문에 저장하지 못했으며, 스크립트를 실행하면 다시 생성됨. commit/push 없음.

### LOG-025 — 들어 올리는 덮개 v5.0
- 2026-10-29 / A. 사용자 의견: 기존 덮개는 출력이 어렵고 배터리 충전도 불편함. 처음 만드는 자율주행차라 모양보다 잘 달리는 것을 원함. 충전 방식은 덮개를 통째로 드는 방식을 선택함.
- 새 P10: 지붕이 평평하고 둘레를 45°로 깎은 2.4mm 벽 덮개. 바닥판의 기존 구멍 4곳에 핀으로 끼우며 볼트는 쓰지 않음. 앞면 가운데(x±42)는 아래부터 위까지 트여서 센서·카메라 받침·카메라를 지나 위로 들어 올릴 수 있음. 바퀴 홈, 뒤쪽 배터리 통로, 통풍구는 유지함.
- v4.3에서 낸 덮개 센서 홈은 위로 트여 있어 수직으로 들어 올릴 때 걸리는 잘못된 방향이었음. v5.0으로 대체함.
- 검사: 비다양체 모서리 0. 0~130mm를 2mm 간격으로 들어 올리며 간섭 검사 결과 0건. 지붕을 아래로 놓고 출력할 때 45°보다 가파른 면은 약 1cm²(기존 약 131cm²)이고, 핀 받침 4곳에만 작은 서포트가 필요함. 부피는 약 150cm³. 출력 크기 175×183×87mm로 3DWOX1 범위 안.
- 장식용 헤드램프 참고 형상은 삭제함. 슬라이서 검사, 실물 끼움, 핀 공차는 미검증. .blend는 용량 때문에 전송하지 못했으며 cover_v5.py를 실행하면 다시 생성됨(입력은 v4.3 blend, sensor_mount_v4_3.py 실행 결과). commit/push 없음.

### LOG-026 — 보조배터리 USB 창(v5.1)·출력 세트·캐스터 구멍(v5.2)
- 2026-10-29 / A. 보조배터리 스캔으로 단자 위치(앞면: USB-A 2개, 작은 입력 단자 1개)를 확인함. 덮개 앞쪽 왼편에 바닥부터 트인 창(x -70~-40)을 내서 바깥쪽 USB-A 플러그와 케이블이 지나가게 함. 플러그 추정 형상 간섭 0건, 들어 올림 간섭 0건. 충전 입력 플러그는 센서 배선 추정 형상과 겹침.
- 현재 모델 전체 P부품 21개를 outputs/20261029_출력세트_v5.2_A로 일괄 내보냄(export_all.py). 다른 버전 폴더와 섞지 않음.
- 사용자가 지적한 캐스터 스캔의 고정판 구멍을 측정함: 판 약 68×51mm, 구멍 약 54×24mm(지름 약 4.4~5, M5). 사진 비율과 일치함. 기존 38×28mm 추정 구멍은 맞지 않아 메움. 캐스터를 90° 돌려 긴 쪽을 좌우로 두고, (±27, 38/62) 위치에 ±2mm 조정 긴 구멍과 윗면 M5 너트 홈(깊이 4mm)을 냄. M5×10으로 고정 가능. 스캔이 거칠어 실측 필요.
- 사진으로 확인: 초음파 센서 핀이 긴 모서리에서 기판과 같은 면으로 곧게 나옴(설계 가정과 일치).

### LOG-027 — 출력 방향 정리, 선반 보강대 제거, 제작 설명서
- 2026-10-29 / A. 출력 세트 STL 21개를 출력 방향으로 돌리고 바닥에 맞춰 다시 저장함(export_print.py, print_manifest.json). 선반 아래 보강대 2개 때문에 판 전체가 공중에 떠서 서포트가 179cm²였음. 보강대를 없애 2.2cm²로 줄임.
- 사용자 요청: A(지급 부품)와 B(출력 부품)로 나누어 ① 출력 가능성 ② 볼트·조립 ③ 기능 점검 순서로 설명서를 작성하고, 문제는 발견→조치→결과로 기록할 것. HTML 설명서를 docs/제작설명서/index.html에 저장함(부품 사진 크롭, 모델 렌더 포함). 앞으로 문제가 생기면 같은 표에 추가함.
- 기능 점검 결과(모델 기준): 도로 폭 위험(차 폭 약 283mm, 도로 300mm). 옆 미끄러짐·카메라 흔들림(렌즈 높이 약 20cm)은 주의. 충전·전복·발열은 문제없음으로 판단. 실물 시험은 하지 않음.

### LOG-028 — 구조 흔적 정리와 단계별 조립 그림
- 2026-10-29 / A. 사용자 지적: 용도를 알 수 없는 구멍·구조가 곳곳에 있음. 바닥판·선반을 높이 지도로 전수 조사하고 예전 스크립트에서 출처를 확인함.
- 바닥판: 옛 센서 받침 턱·가이드 삭제. 옮기기 전 지지대 구멍 2곳, 뒤 잠금판에 가려진 케이블 타이 구멍, 옛 캐스터 구멍 끝 홈을 메움. 좌우 배선 구멍은 유지함.
- 선반: 뒤 지지대 구멍이 판 끝에서 1mm라 뒤가 트인 U자 홈이 된 것을 판을 덧대 막음. 옛 지지대 구멍 흔적을 메움. 드라이버 밑 긴 구멍 4개는 통풍용으로 남김. 메시 오류 0, 새 간섭 0, 덮개 들어 올림 간섭 0. 출력 세트 P01·P02 갱신.
- 설명서: 구조 지도(번호와 용도), 출력판 위 모습과 출력 후 확인 항목, 16단계 조립 그림(외곽선, 부품 묶음당 화살표 1개, 연결부 확대)으로 갱신함.

### LOG-029 — v5.3 공구 없는 잠금판, 가로대 일체화, 설명서 간소화
- 2026-10-29 / A. 작은 부품이 많다는 의견으로 가로대 P04·P05를 계단형 1개로 합침. 고정편 8개를 막대로 합치면 드라이버 단자와 파이 핀을 덮고, 잠금판을 합치면 충전 때 볼트가 4개로 늘어서 유지함(21→20개).
- 배터리를 보관하려면 매번 빼야 한다는 의견으로, 뒤 잠금판을 바닥판 홈 기둥에 위에서 꽂는 방식으로 바꿈. M3×16 4개가 필요 없어짐. 리포 잠금판은 선반 아래를 피하려고 10mm 뒤로 옮기고 받침 돌기를 붙임. 잠금판 들어 올림 간섭 0건.
- 검사 중 기존 문제 2개 발견: 모터 받침 볼트 머리(약 3mm)가 배터리 밑에 깔림 → 바닥판에 지름 8.5mm, 깊이 3mm 머리 홈. 보조배터리를 뺄 때 덮개 왼쪽 뒤 다리에 2mm 걸림 → 다리를 줄임. 두 배터리 모두 빼는 길 간섭 0건.
- 카메라 클립의 나사 구멍 여부는 확인할 수 없어 클립 방식을 유지하고, 확인할 것에 추가함.
- 사용자 요청으로 설명서를 핵심 6개 부분(출력, 볼트, 조립, 충전, 주의, 확인할 것)으로 간소화함. 구조 지도와 문제 기록은 접힌 칸으로 옮김.

### LOG-030 — v6 키트 볼트만 사용, 출력 부품 10개
- 2026-10-30 / A. 사용자 요청: 키트에 볼트가 없을 수 있으니 키트 것만 쓰고, 가늘어서 부러지기 쉬운 구조를 없애고, 부품 수를 줄여 조립을 쉽게.
- 바뀐 점: 선반 지지대 4개 → 바닥판 출력 기둥(지름 8mm 핀 3곳, 뒤 왼쪽 M6×20 1개). 보드 고정편 8개 → 선반 레일과 위 턱, 앞 모서리 막이, 뒤 막대 P15 1개(끼움식). 모터 받침 좌우 일체 P06, 하판 좌우 일체 P07, 너트 대신 M4×20이 출력물에 직접 나사를 내며 박힘(지름 3.4mm 구멍, 박히는 깊이 위 18mm·아래 9.6mm). 카메라 누름판을 받침에 붙임(클립 뒤판이 받침 틈에 끼워짐). 가로대는 지름 6mm 핀 4개에 끼우고 선반이 위를 막음, 연결부 8mm로 보강. 덮개 핀 삭제, 바닥판 테두리 턱(높이 3mm)으로 위치 고정. 센서 홈 앞벽 1.6mm → 3.1mm. 안 쓰는 너트 홈과 M3 구멍을 메움.
- 볼트: M4×20 8개(모터), M6×20 1개(선반), M5×10 4개(캐스터), M4×12·M3×8(바퀴). 지지대 8개는 쓰지 않음.
- 검사: 10개 부품 메시 오류 0, 새 간섭 0(닿게 설계한 면만 접촉), 덮개·잠금판 2개·뒤 막대 들어 올림 간섭 0, 배터리 2개 빼는 길 간섭 0, 출력 서포트 최대 약 9cm²(카메라 받침). 하판은 세워서 출력.
- 남은 위험: 보드 레일·카메라 클립 틈은 추정 치수 기준(실물 확인 필요). 카메라 받침과 선반은 핀과 무게로 자리를 잡고 있어서, 차가 뒤집히면 빠질 수 있음. 출력물에 직접 나사를 내는 방식은 여러 번 풀었다 조이면 헐거워짐.

### LOG-031 — v6.1 흔적 없는 재모델링 (바닥판, 카메라 받침, 덮개)
- 2026-10-30 / A. 사용자가 모델을 하나씩 보다가 이상한 구멍, 의미 없는 구멍, 떠 있는 덩어리를 지적함.
- 검사 결과: 덮개에 떠 있는 얇은 조각 1개와 잘린 다리 흔적. 바닥판 STL 면 오류 121곳과 예전 너트 홈·받침·메운 구멍 자국. 카메라 받침에 예전 너트 홈을 메운 삼각형 홈.
- 조치: 바닥판과 카메라 받침을 지금 쓰는 구조 목록만으로 처음부터 다시 모델링함(v6_rebuild.py). 바닥판 외곽선만 이전 판에서 가져옴. 덮개는 흔적을 잘라내고 떠 있는 조각을 지움. 카메라 받침 핀 구멍이 세로판까지 파고들던 것도 고침.
- 검사: 10개 STL 모두 조각 1개, 면 오류 0. 간섭은 닿게 설계한 면만. 덮개·잠금판·뒤 막대 들어 올림 간섭 0. 배터리 빼는 길 간섭 0. 바닥판 서포트 0.5cm².

### LOG-032 — 가상 조립 검사
- 2026-10-30 / A. 설명서 순서대로 18개 부품 묶음을 끼우는 방향으로 2mm씩 움직이며 이미 조립된 부품과의 간섭을 검사함(virtual_assembly.py). 볼트 3종은 위·아래 직선 120mm 안에 공구를 막는 부품이 있는지 검사함.
- 결과: 15단계 막힘 없음. 공구 접근 3종 모두 가능. 걸린다고 나온 3건 중 2건은 오탐(파이 묶음에 보조배터리 플러그 형상이 잘못 포함됨, 축소 판정에 따른 핀 구멍 오탐 — 실제 구멍은 열려 있음을 확인). 1건은 실제 문제: 보드 뒤 막대 연결부와 파이 레일 벽 사이 0.1mm → 0.5mm로 수정.
- 검사하지 않은 것: 전선과 커넥터, 손이 들어갈 공간, 실물 치수 오차, 볼트가 출력물에 박히는 힘.

## LOG-033 (2026-10-30) 덮개 볼트 고정 + 웹캠 클립 받침 수정
- 발견: 덮개가 얹기만 해서 주행 중 들릴 수 있음. 실제 웹캠(APC850) 클립은 위판이 길고 뒤판이 비스듬히 뒤로 내려와 뒤쪽 공간이 필요함(사진 확인).
- 조치: 바닥판 기둥(8,-59)을 선반 위로 덮개 천장까지 연장, 덮개에 M6 관통구멍 → 키트 M6×20 1개로 덮개+선반 동시 고정. 카메라 받침 뒤 누름막대·옆벽 삭제(모니터 위에 거는 방식), 덮개 천장 개구를 뒤로 확장(y30~60).
- 결과: 모든 출력파일 깨진 면 0, 새 간섭 0, 볼트 풀면 덮개 들어올림 걸림 0. 클립 추정 형상은 받침 위·뒤에만 닿음. 남은 확인: 클립 위판 길이·뒤판 길이·폭 실측.
- 파일: outputs/20261030_출력세트_v6_A (10 STL 갱신), models/assembly-v3/v62_cover_bolt.py, v63_camera_clip.py

## LOG-034 (2026-10-30) 폴더 정리, 출력 가이드
- 요청: 가이드·출력파일·학교자료만 위에 보이게, 나머지는 날짜별 과거 기록으로, 불필요 파일 삭제.
- 조치: 1_출력파일_v6.3 / 2_출력가이드 / 3_조립설명서 / 4_학교제공자료 / 5_과거기록(날짜별) 구조로 이동. 최신 모델 v6.3 .blend를 PC에 추가(검사값 일치 확인).
- 삭제(사용자 승인): Blender 자동백업 .blend1 7개, tmp, 로그 2개, 설명서에서 안 쓰는 옛 그림 57장, 빈 옛 폴더(models, outputs, docs, references).
- 참고: Git에는 아직 반영하지 않음(푸시 보류 지시).

## LOG-035 (2026-10-30) 출력 파일 4개로 정리, 모터 하판 눕힘 (v6.4)
- 발견(사용자): 작은 부품을 하나씩 불러와야 함. 한 판에 모은 파일이 필요함. 한 판 그림에서 세워진 부품이 잘 나올지 걱정.
- 조치: 작은 부품 7개를 한 판에 배치한 출력1 STL 생성, 출력1~4 파일만 보이게 정리(개별 파일은 하위 폴더). 방향 재검토: P07 모터 하판은 54mm로 선 얇은 판이라 아래를 채워 평평하게 눕힘(볼트 머리 홈 추가, 볼트 길이 동일). P04 가로대·P09 카메라 받침은 서포트·강도 때문에 옆으로 눕힌 방향 유지.
- 결과: P07 서포트 0(구멍 머리 홈 천장 브리지만), 브림 불필요, 다른 부품과 겹침 0. 한 판 199×179mm로 출력판 안. 최신 모델 v6.4 .blend 추가(검사값 확인).
