shinhan7n2-spec/autonomous-car/(commit log)

2026-10-29 Add autonomous car models, assembly guides and design records
    [01_P01_한장바닥판_190x185x5.stl, 01_P01_한장바닥판_190x185x5_REVIEW.stl, 02_P02_분리선반_150x130x4.stl, 02_P02_분리선반_150x130x4_REVIEW.stl, 03_P04_보조배터리_고정가로대.stl, 03_P04_보조배터리_고정가로대_REVIEW.stl, 04_P05_리포배터리_고정가로대.stl, 04_P05_리포배터리_고정가로대_REVIEW.stl]
2026-10-30 v6.4 출력 세트, 출력 가이드, 조립설명서, 발표자료, 폴더 정리
    - 1_출력파일_v6.3: 출력1~4 STL (작은 부품 7개 한 판 포함), 개별 부품 10개
    - 모터 하판 P07 눕혀서 출력하도록 수정 (v6.4)
    - 2_출력가이드, 3_조립설명서, 6_발표자료 (HTML)
    - 4_학교제공자료, 5_과거기록(날짜별) 구조로 정리, 최신 .blend 추가
    Claude-Session: https://claude.ai/code/session_01Rew21ixvqrc2DKiAcPkobt
    [01_P01_한장바닥판_190x185x5.stl, 01_P01_한장바닥판_190x185x5_REVIEW.stl, 02_P02_분리선반_150x130x4.stl, 02_P02_분리선반_150x130x4_REVIEW.stl, 03_P04_보조배터리_고정가로대.stl, 03_P04_보조배터리_고정가로대_REVIEW.stl, 04_P05_리포배터리_고정가로대.stl, 04_P05_리포배터리_고정가로대_REVIEW.stl]
2026-10-30 출력 가이드 수정
2026-10-30 수업자료대조 수정
